a-drizzle/Printer1/media/pictures/building/20160507_185557.jpg

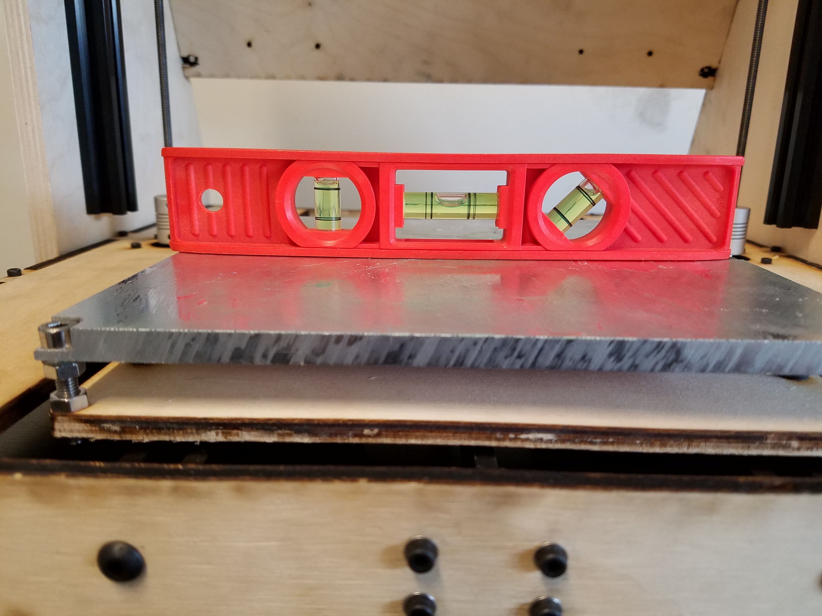
media/pictures/building/20160507_185557.jpg
