a-drizzle/Printer1/archive/rev A/X-002.pdf

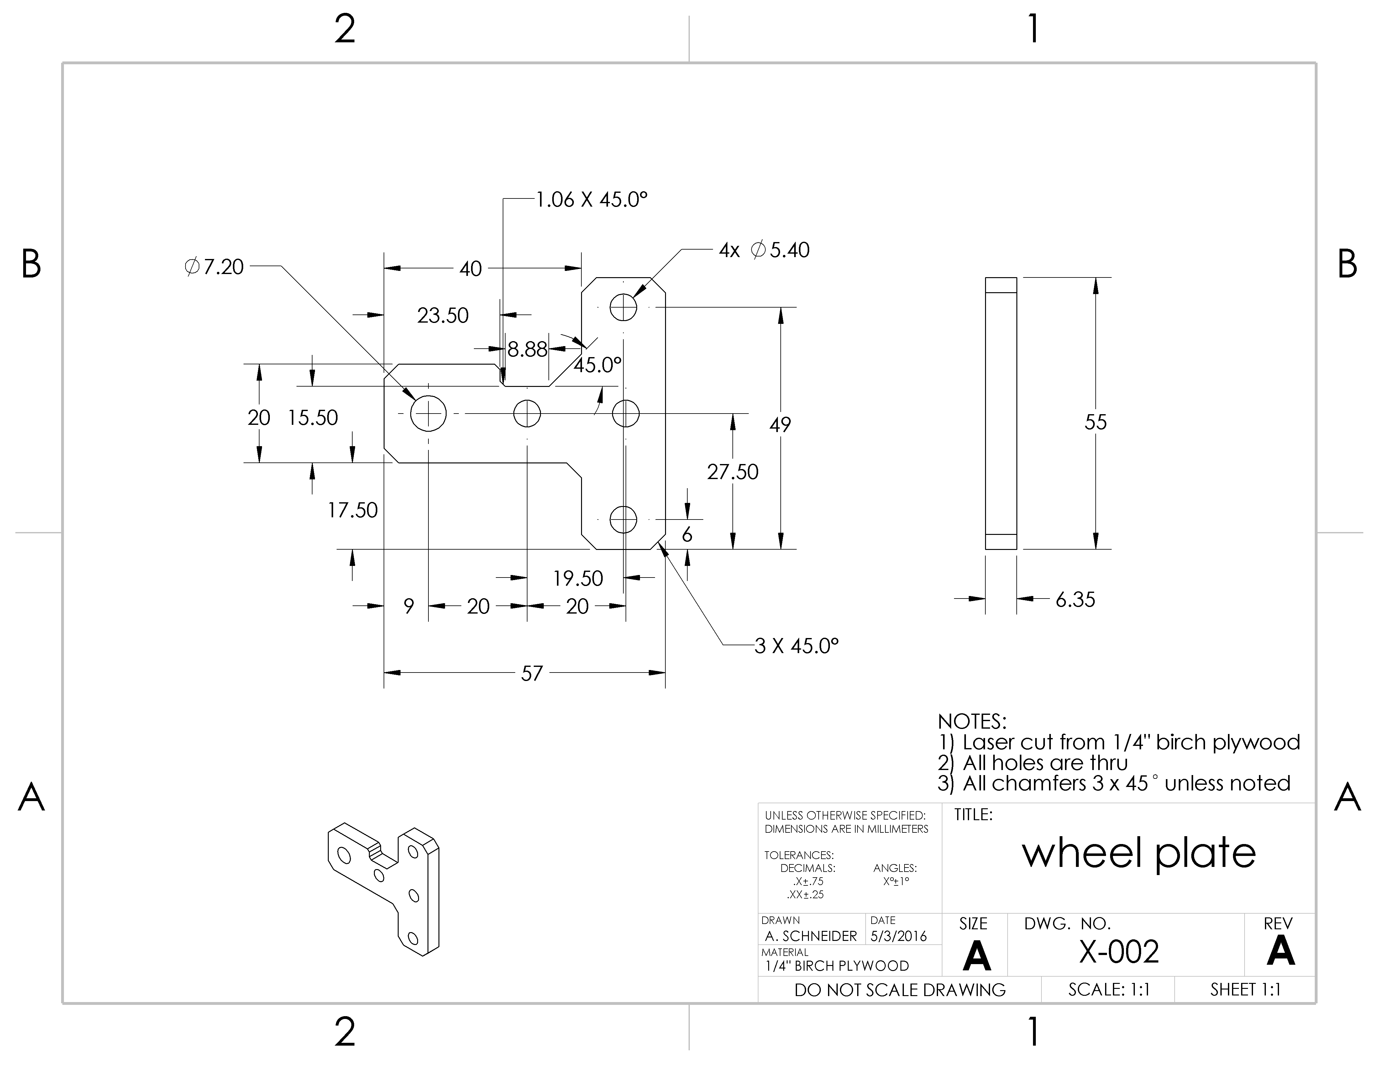
[picture p3: page 1]
