a-drizzle/Printer1/archive/rev A/Y-004.pdf

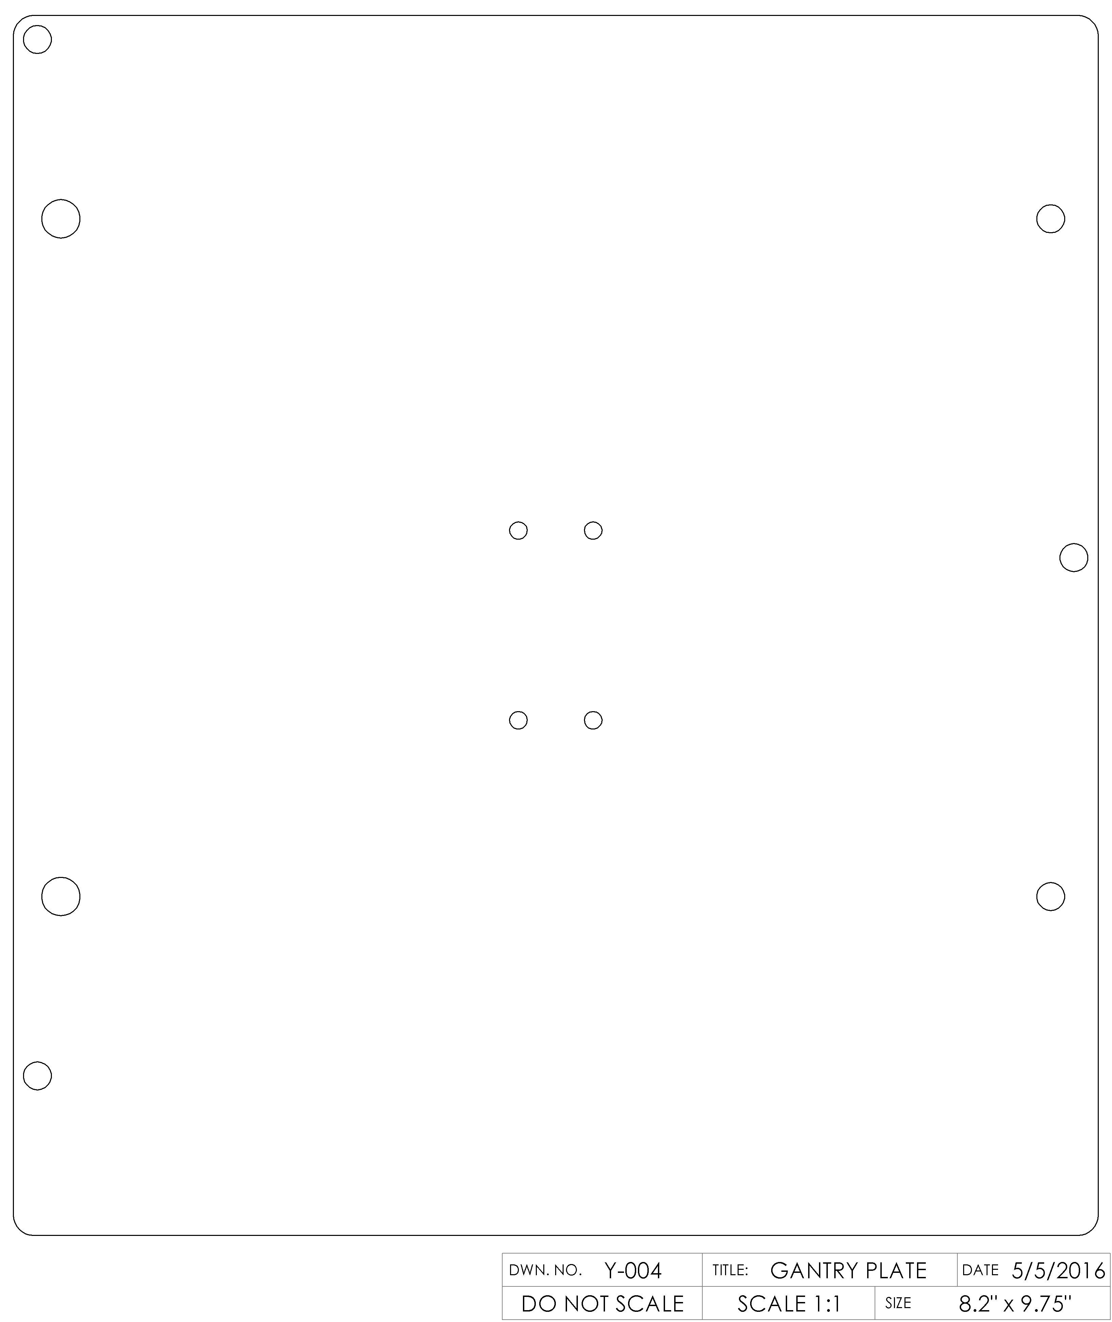
[picture p4: page 1]
