a-drizzle/Printer1/media/pictures/complete/20160509_213520.jpg

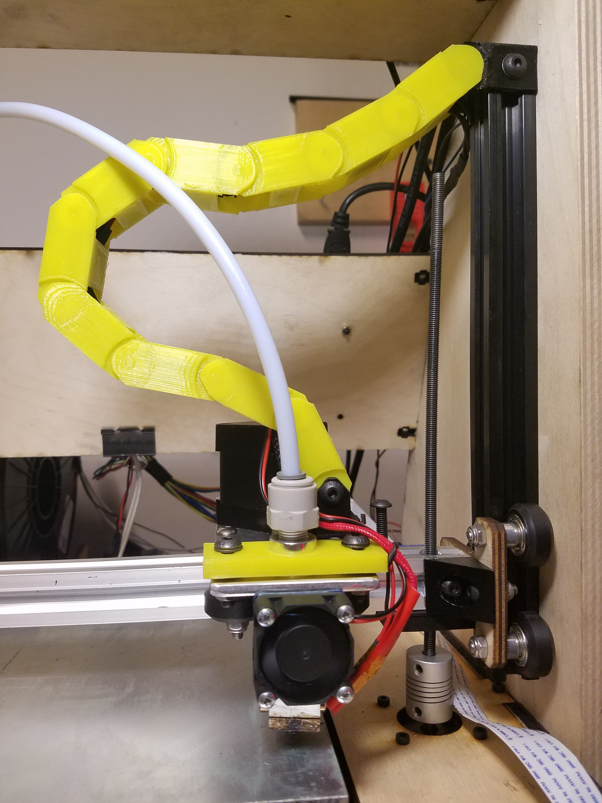
media/pictures/complete/20160509_213520.jpg
