a-drizzle/Printer1/media/renders/FrameRender2.png

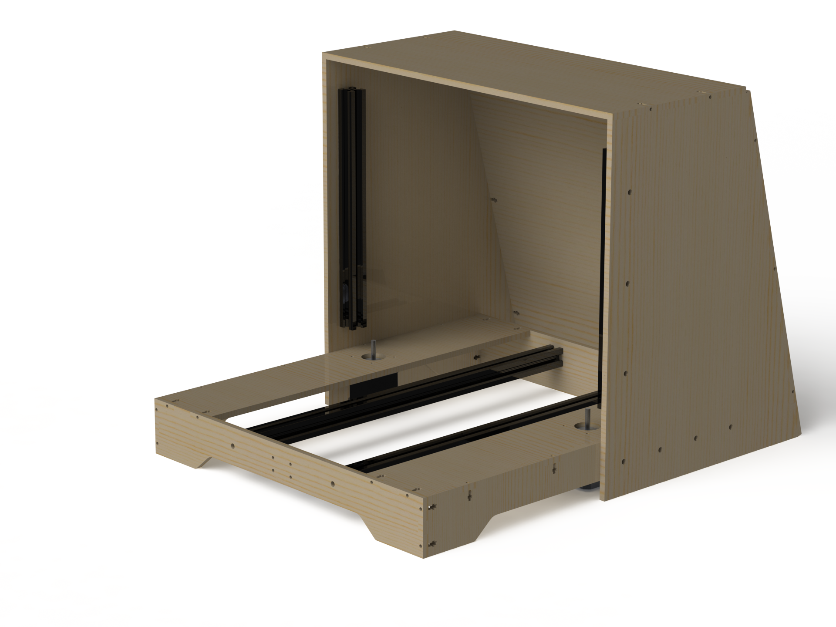
media/renders/FrameRender2.png
