a-drizzle/Printer1/media/renders/full.png

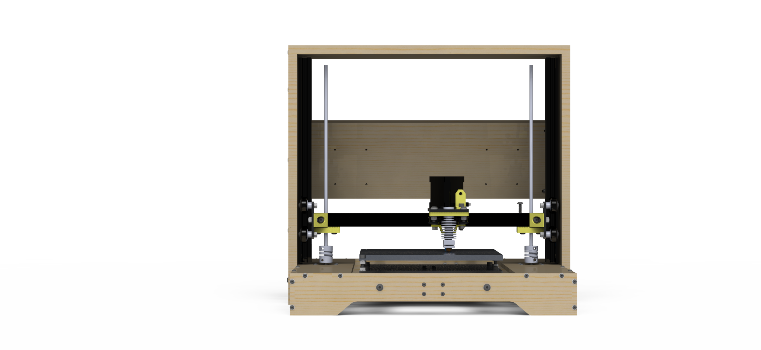
media/renders/full.png
