a-drizzle/Printer1/media/renders/x-axis_back.png

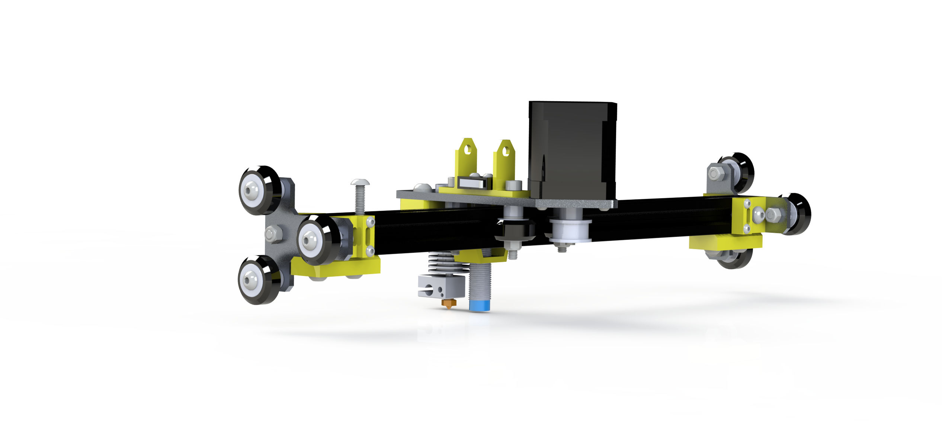
media/renders/x-axis_back.png
