a-drizzle/Printer1/media/renders/x-carriage.png

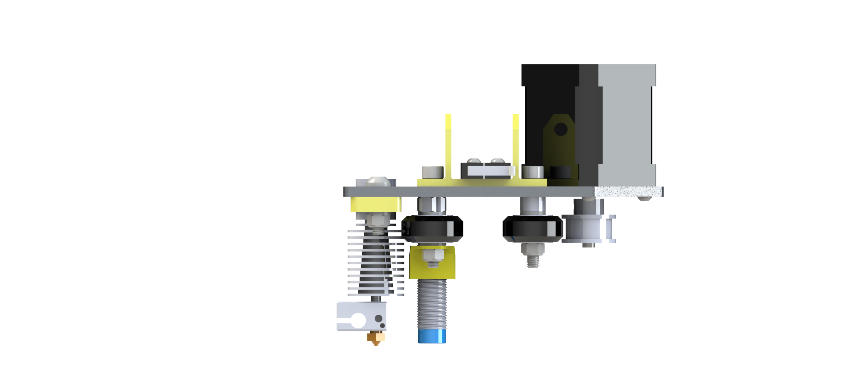
media/renders/x-carriage.png
