a-drizzle/Printer1/media/renders/y.png

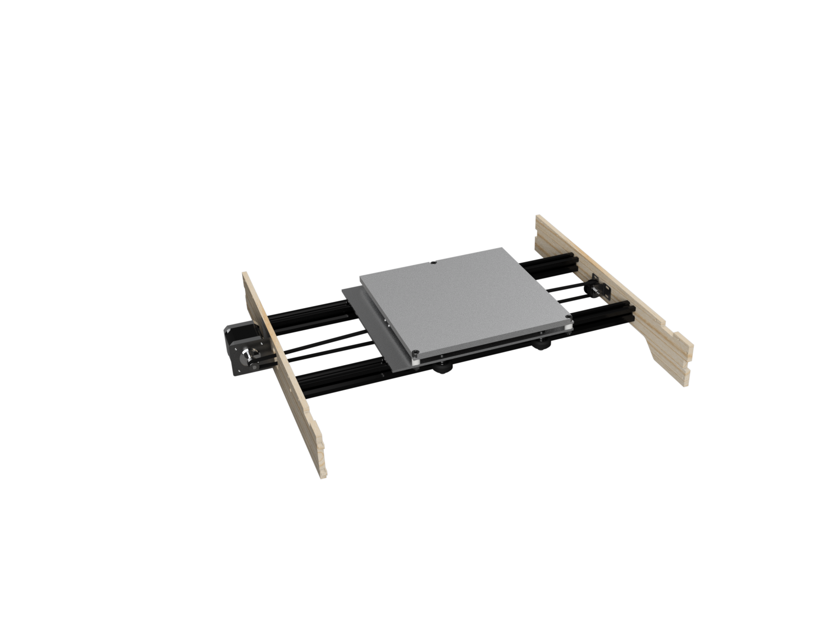
media/renders/y.png
