a-drizzle/Printer1/documentation/BOM_final.xlsx

Category | Andrew's Part # | Description | Manufacturer | Manufacturer Part # | Quantity | Price per Unit | Total
Electronic | E-001 | NEMA 17 stepper 76 oz-in | OpenBuilds | 775 | 1 | $17.50 | $17.50
Electronic | E-002 | NEMA 17 stepper 84 oz-in | Ebay | 231514870097 | 3 | $9.00 | $27.00
Electronic | E-003 | Inductive Sensor | Ebay | 141715753806 | 1 | $4.58 | $4.58
Electronic | E-004 | Endstop Switch | OpenBuilds | 725 | 2 | $2.00 | $4.00
Frame | F-001 | Front Base | Andrew |  | 1 |  | $0.00
Frame | F-002 | Back Base | Andrew |  | 1 |  | $0.00
Frame | F-003 | Sides Base | Andrew |  | 2 |  | $0.00
Frame | F-004 | Stepper Mounts | Andrew |  | 2 |  | $0.00
Frame | F-005 | Big Sides | Andrew |  | 2 |  | $0.00
Frame | F-006 | Top | Andrew |  | 1 |  | $0.00
Frame | F-007 | Back | Andrew |  | 1 |  | $0.00
Hardware | H-001 | T-Nuts (25 pk) | OpenBuilds | 50 | 1 | $4.95 | $4.95
Hardware | H-002 | Eccentric Spacer | OpenBuilds | 226 | 6 | $2.00 | $12.00
Hardware | H-003 | Aluminum Spacer - 6mm | OpenBuilds | 90 | 8 | $0.20 | $1.60
Hardware | H-004 | M5x8 Button Head | Mr.Metric | M11409 | 2 | $0.12 | $0.24
Hardware | H-005 | M5x10 Button Head | Mr.Metric | M11410 | 2 | $0.10 | $0.20
Hardware | H-006 | M5x12 Button Head | Mr.Metric | M11411 | 6 | $0.11 | $0.66
Hardware | H-007 | M5x16 Button Head | Mr.Metric | M11412 | 12 | $0.09 | $1.08
Hardware | H-008 | M5x20 Button Head | Mr. Metric | M11413 | 4 | $0.16 | $0.64
Hardware | H-009 | M5x25 Button Head | Mr.Metric | M11414 | 18 | $0.14 | $2.52
Hardware | H-010 | M5x30 Button Head, SS | Mr.Metric | M11534 | 2 | $0.20 | $0.40
Hardware | H-011 | M5 Flat Washer | Mr.Metric | M60710 | 39 | $0.02 | $0.78
Hardware | H-012 | M5 Nylon Locknut | Mr.Metric | M50352 | 29 | $0.06 | $1.74
Hardware | H-013 | M3x10 Button Head | Mr.Metric | M11402 | 18 | $0.06 | $1.08
Hardware | H-014 | Solid V Wheel Kit | OpenBuilds | 480 | 14 | $4.85 | $67.90
Hardware | H-015 | Drop In T-Nut | OpenBuilds | 230 | 2 | $0.75 | $1.50
Hardware | H-016 | M5 Hex Nut, zinc | Mr. Metric | M50608 | 14 | $0.04 | $0.56
Hardware | H-017 | M5x30 FT Socket Head | Mr. Metric | M10103-FT | 7 | $0.16 | $1.12
Hardware | H-018 | M5 Split Lock Washer | Mr. Metric | M60807 | 3 | $0.04 | $0.12
Hardware | H-019 | M3 Nylon Locknut | Mr.Metric | M50303 | 8 | $0.02 | $0.16
Hardware | H-020 | M3 Hex Nut, zinc | Mr. Metric | M50013 | 28 | $0.02 | $0.56
Hardware | H-021 | M3x12 Button Head | Mr. Metric | M11403 | 12 | $0.09 | $1.08
Hardware | H-022 | M3x16 Button Head | Mr. Metric | M11404 | 24 | $0.05 | $1.20
Hardware | H-023 | M3x6 Button Head | Mr. Metric | M11400 | 4 | $0.03 | $0.12
Hardware | H-024 | M3 Flat Washer | Mr. Metric | M60708 | 28 | $0.03 | $0.84
Hardware | H-025 | M5x35 Socket Head | Mr. Metric | M10105 | 2 | $0.20 | $0.40
Hardware | H-030 | Smooth Idler Pulley Wheel Kit | OpenBuilds | 550 | 1 | $5.45 | $5.45
Mechanical | M-001 | GT2 20 tooth pulley | OpenBuilds | 210 | 2 | $5.50 | $11.00
Mechanical | M-002 | GT2 Timing Belt 2mm | OpenBuilds | 470 / By the Foot | 5 | $2.50 | $12.50
Mechanical | M-003 | e3D Lite6 Bowden, 12V | SMW3D | Lite12B | 1 | $39.99 | $39.99
Mechanical | M-004 | Flexible 5mm to 5mm coupler | SMW3D | 5x5cplr | 2 | $1.50 | $3.00
Mechanical | M-005 | Z-Axis Rod | Andrew |  | 2 |  | $0.00
Printed | PX-001 | Endstop Mount | Andrew |  | 1 |  | $0.00
Printed | PX-002 | Belt Clamp Base | Andrew |  | 2 |  | $0.00
Printed | PX-003 | Belt Clamper | Andrew |  | 4 |  | $0.00
Printed | PX-004 | Z Nut Trap | Andrew |  | 2 |  | $0.00
Printed | PX-005 | Z Nut Trap stopper | Andrew |  | 2 |  | $0.00
Printed | PX-006 | Black Angle Connector | Andrew |  | 2 |  | $0.00
Printed | PX-007 | Groove Mount Plate | Andrew |  | 1 |  | $0.00
Printed | PX-008 | Drag Chain Base | Andrew |  | 1 |  | $0.00
Printed | PX-009 | Inductive Sensor Mount | Andrew |  | 1 |  | $0.00
Mechanical | X-001 | Carriage Plate | Andrew |  | 1 |  | $0.00
Mechanical | X-002 | Wheel Plate | Andrew |  | 2 |  | $0.00
Mechanical | X-003 | x axis V-Slot | Andrew |  | 1 |  | $0.00
Mechanical | Y-001 | laser cut idler mount | Andrew |  | 2 |  | $0.00
Mechanical | Y-002 | laser cut stepper mount | Andrew |  | 1 |  | $0.00
Mechanical | Y-003 | Build Plate | Andrew |  | 1 |  | $0.00
Mechanical | Y-004 | Gantry Plate | Andrew |  | 1 |  | $0.00
Mechanical | Y-005 | y axis V-Slot | Andrew |  | 2 |  | $0.00
Mechanical | Y-006 | z axis V-Slot | Andrew |  | 2 |  | $0.00
Stock |  | .160x6x6" aluminum sheet | McMaster | 89015K255 | 1 | $10.48 | $10.48
Stock |  | 1/2x12x24" Birch Plywood (single sheet) | Revell | 88-7682 | 2 | $6.79 | $13.58
Stock |  | 1/4x12x24" Birch Plywood (single sheet) | Revell | 88-7684 | 2 | $9.49 | $18.98
Stock |  | 20x20x500mm Black V-Slot | OpenBuilds | 130-LP | 5 | $5.50 | $27.50
Electronic |  | Fotek Relay, 24V-380V 25A SSR-25 DA | Ebay | 321979099507 | 1 | $4.99 | $4.99
Stock |  | General Purpose Low-Carbon 22 gauage Steel Sheet 12"x24" | McMaster | 6544K13 | 1 | $8.27 | $8.27
Electronic |  | Keenovo 500W, 120V, 8x8" heat mat | Keenovo | K150150500W110V | 1 | $34.25 | $34.25
Stock |  | M5x0.8 low-strength steel fully threaded rod | McMaster | 98861A060 | 2 | $1.08 | $2.16
Hardware |  | M5x25 Socket Cap, zinc | Mr. Metric | M10856 | 7 | $0.02 | $0.14
Stock |  | MIC 6 5/16x8x8" | McMaster | 86825K744 | 1 | $22.37 | $22.37
Stock |  | Super-Cushioning Polyurethane Rubber Sheet, Abrasion-Resistant, 4" x 4", 1/8" Thick, 70Oo Durometer | McMaster | 8514K51 | 2 | $5.73 | $11.46
Electronic |  | Thermistor 100K 3950 | SMW3D | 100K 3950 | 1 | $0.99 | $0.99
Mechanical |  | V-slot cover 500mm black | OpenBuilds | 120-LP-B | 3 | $2.00 | $6.00
Total |  |  |  |  |  |  | $389.64
