a-drizzle/Printer1/documentation/BOM_rB.xlsx

Sheet: BOM
Category | Andrew's Part # | Description | Manufacturer | Manufacturer Part # | Quantity | Price per Unit | Total
 |  |  |  |  |  |  | $345.41
MISC
Hardware | H-001 | T-Nuts (25 pk) | OpenBuilds | 50 | 1 | $4.95 | $4.95
Mechanical |  | V-slot cover 500mm black | OpenBuilds | 120-LP-B | 3 | $2.00 | $6.00
X - AXIS & Z - AXIS
Stock |  | .160x6x6" aluminum sheet | McMaster | 89015K255 | 1 | $10.48 | $10.48
Stock |  | 20x20x500mm Black V-Slot | OpenBuilds | 130-LP | 1 | $5.50 | $5.50
Electronic | E-001 | NEMA 17 stepper 76 oz-in | OpenBuilds | 775 | 1 | $17.50 | $17.50
Electronic | E-002 | NEMA 17 stepper 84 oz-in | Ebay | 231514870097 | 2 | $9.00 | $18.00
Hardware | H-002 | Eccentric Spacer | OpenBuilds | 226 | 4 | $2.00 | $8.00
Hardware | H-003 | Aluminum Spacer - 6mm | OpenBuilds | 90 | 8 | $0.20 | $1.60
Mechanical | M-001 | GT2 20 tooth pulley | OpenBuilds | 210 | 1 | $5.50 | $5.50
Mechanical | M-002 | GT2 Timing Belt | OpenBuilds | 470 / By the Foot | 2 | $2.50 | $5.00
Electronic | E-003 | Inductive Sensor | Ebay | 141715753806 | 1 | $4.58 | $4.58
Mechanical | M-003 | e3D v6 clone | Ebay | 181902204358 | 1 | $25.99 | $25.99
Mechanical |  | PTFE tubing 3mm ID | Filastruder |  | 1 | $7.50 | $7.50
Mechanical |  | Fiberglass insulation | Filastruder |  | 1 | $1.99 | $1.99
Mechanical | H-014 | Solid V Wheel | MakerFarm | SolidV+Bearing | 6 | $2.95 | $17.70
Hardware | H-004 | M5x8 Button Head | Mr.Metric | M11409 | 2 | $0.12 | $0.24
Hardware | H-005 | M5x10 Button Head | Mr.Metric | M11410 | 3 | $0.10 | $0.30
Hardware | H-006 | M5x12 Button Head | Mr.Metric | M11411 | 4 | $0.11 | $0.44
Hardware | H-007 | M5x16 Button Head | Mr.Metric | M11412 | 4 | $0.09 | $0.36
Hardware | H-008 | M5x20 Button Head | Mr.Metric | M11413 |  | $0.16 | $0.00
Hardware | H-009 | M5x25 Button Head | Mr.Metric | M11414 |  | $0.14 | $0.00
Hardware | H-010 | M5x30 Button Head, SS | Mr.Metric | M11534 | 4 | $0.20 | $0.80
Hardware | H-011 | M5 Flat Washer | Mr.Metric | M60710 | 10 | $0.02 | $0.20
Hardware | H-012 | M5x.8 Nylon Locknut | Mr.Metric | M50352 | 12 | $0.06 | $0.72
Hardware | H-013 | M3x10 Button Head | Mr.Metric | M11402 | 6 | $0.06 | $0.36
Hardware | H-014 | Solid V Wheel Kit |  |  | 10 |  | $0.00
Hardware | H-015 | Drop In T-Nut |  |  |  |  | $0.00
Hardware | H-016 | M5 Hex Nut, zinc | Mr. Metric | M50608 | 2 | $0.02 | $0.04
Electronic | E-004 | Endstop Switch | MakerFarm | Switch | 1 | $1.50 | $1.50
Mechanical | X-001 | Carriage Plate | Andrew |  | 1 |  |  | $123.82
Mechanical | X-002 | Wheel Plate | Andrew |  | 2
Mechanical | X-003 | V-Slot | Andrew |  | 1
Printed | PX-002 | Belt Clamp Base | Andrew |  | 2 |  | $0.00
Printed | PX-003 | Belt Clamper | Andrew |  | 2 |  | $0.00
Printed | PX-004 | Z Nut Trap | Andrew |  | 2 |  | $0.00
Printed | PX-005 | Z nut trap stopper | Andrew |  | 2 |  | $0.00
Printed | PX-006 | Black Angle Connector | Andrew |  | 2 |  | $0.00
Printed | PX-007 | Groove Mount Plate
Printed | PX-008 | Drag Chain Base | Andrew |  | 1 |  | $0.00
Y - AXIS
Electronic |  | NEMA 17 stepper 84 oz-in | Ebay | 231514870097 | 1 | $9.00 | $9.00
Stock |  | MIC 6 5/16x8x8" | McMaster | 86825K744 | 1 | $22.37 | $22.37
Stock |  | Firm White Polyester Felt Strip, 1/4" Thick, 1" Width, Plain Back | McMaster | 88085K311 | 1 | $4.70 | $4.70
Stock |  | Super-Cushioning Polyurethane Rubber Sheet, Abrasion-Resistant, 4" x 4", 1/8" Thick, 70Oo Durometer | McMaster | 8514K51 | 2 | $5.73 | $11.46
Stock |  | General Purpose Low-Carbon 22 gauage Steel Sheet 12"x24" | McMaster | 6544K13 | 1 | $8.27 | $8.27
Stock |  | 20x20x500mm Black V-Slot | OpenBuilds | 130-LP | 2 | $5.50 | $11.00
Stock |  | 20x20x250mm Black V-Slot | OpenBuilds | 255-LP | 2 | $3.30 | $6.60
Stock |  | Aspen Aerogel Spaceloft insulation | Ebay | 171328843398 | 1 | $7.99 | $7.99
Electronic |  | Keenovo 500W, 120V, 8x8" heat mat | Keenovo | K150150500W110V | 1 | $34.25 | $34.25
Electronic |  | Fotek Relay, 24V-380V 25A SSR-25 DA | Ebay | 321979099507 | 1 | $4.99 | $4.99
Mechanical |  | Solid V Wheel Kit | OpenBuilds | 480 | 4 | $4.85 | $19.40
Hardware |  | Smooth Idler Pulley Wheel Kit | OpenBuilds | 550 | 1 | $5.45 | $5.45
Hardware |  | Eccentric Spacer | OpenBuilds | 226 | 2 | $2.00 | $4.00
Mechanical | M-002 | GT2 Timing Belt 2mm | OpenBuilds | 470 / By the Foot | 3 | $2.50 | $7.50
Hardware |  | M5 x 25 Socket Cap, zinc | Mr. Metric | M10856 | 7 | $0.02 | $0.06
Hardware |  | M5 Washer | Mr. Metric | M60710 | 3 | $0.04 | $0.36
Hardware |  | M5 Hex Nut, zinc | Mr. Metric | M50608 | 9 | $0.04 | $0.32
Hardware |  | M3 X 6 Button Head | Mr. Metric | M11400 | 8 | $0.03 | $0.12
Hardware |  | M3 Washer | Mr. Metric | M60708 | 4 | $0.02 | $0.10
Hardware |  | M3 Hex Nut, zinc | Mr. Metric | M50013 | 5
Mechanical | Y-001 | laser cut idler mount | Andrew |  | 2
Mechanical | Y-002 | laser cut stepper mount | Andrew |  | 1
Mechanical | Y-003 | Build Plate | Andrew |  | 1
Mechanical | Y-004 | Gantry Plate | Andrew |  | 1 |  |  | $157.94
Printed | PX-001 | Endstop Mount | Andrew |  | 1
FRAME
Stock |  | 1/4x12x24" Birch Plywood (single sheet) | Revell | 88-7684 | 2 | $9.49 | $18.98
Stock |  | 1/2x12x24" Birch Plywood (single sheet) | Revell | 88-7682 | 2 | $6.79 | $13.58
Hardware |  | M3 Hex Nut, zinc | Mr. Metric | M50013 | 42 | $0.03 | $1.26
Hardware |  | M5 Hex Nut, zinc | Mr. Metric | M50608 | 8 | $0.02 | $0.16
Hardware |  | M3 Washer | Mr. Metric | M60708 | 50 | $0.05 | $2.50
Hardware |  | M5 Washer | Mr. Metric | M60710 | 18 | $0.09 | $1.62
Hardware |  | M3 x 16 Button Head | Mr. Metric | M11404 | 34 | $0.06 | $2.04
Hardware |  | M3 x 12 Button Head | Mr. Metric | M11403 | 14 |  | $0.00
Hardware |  | M3 x 10 Button Head | Mr. Metric | M11402 | 8 | $0.16 | $1.28
Hardware |  | M5 x 25 Button Head | Mr. Metric | M11414 |  | $0.11 | $0.00
Hardware |  | M5 x 20 Button Head | Mr. Metric | M11413 | 8 | $0.10 | $0.80
Hardware |  | M5 x 12 Button Head | Mr. Metric | M11411 | 6 |  | $0.00
Hardware |  | M5 x 10 Button Head | Mr. Metric | M11410 | 4 |  | $0.00
Hardware | F-001 | Front Base | Andrew |  | 1
Hardware | F-002 | Back Base | Andrew |  | 1
Hardware | F-003 | Sides Base | Andrew |  | 2
Hardware | F-004 | Stepper Mounts | Andrew |  | 2
Hardware | F-005 | Big Sides | Andrew |  | 2
Hardware | F-006 | Top | Andrew |  | 1
Hardware | F-007 | Back | Andrew |  | 1

Sheet: OpenBuilds
OPENBUILDS
V-SLOT BLK |  |  |  |  |  |  | ELECTRONICS |  |  | HARDWARE |  | SCREWS
x [mm] | y [mm] | length [mm] | length [in] | Cost | $/cm | $/in | Item | Price |  | Item | Price | Item | Price
20 | 20 | 250 | 9.84 | $3.30 | $0.13 | $0.34 | Nema 17 | $17.50 |  | Eccentric Spacer | $2.00 | M5 x 6mm | $0.15
20 | 20 | 500 | 19.69 | $5.50 | $0.11 | $0.28 | Nema 23 | $24.50 |  | M5 Nylon Lock Nut | $0.15 | M5 x 8mm | $0.15
20 | 20 | 1000 | 39.37 | $11.00 | $0.11 | $0.28 | Limit Switch | $2.00 |  | T-Nuts (25) | $4.95 | M5 x 10mm | $0.15
20 | 20 | 1500 | 59.06 | $16.50 | $0.11 | $0.28 | 16-2 Wire | $0.4/ft |  | Drop in T-Nuts | $0.75 | M5 x 15mm | $0.15
20 | 40 | 250 | 9.84 | $4.15 | $0.17 | $0.42 | Wire Cable | $2.5/ft |  | Doulbe T-Nut | $0.85 | M5 x 20mm | $0.15
20 | 40 | 500 | 19.69 | $7.15 | $0.14 | $0.36 |  |  |  | Lock Collar | $0.90 | M5 x 25mm | $0.15
20 | 40 | 1000 | 39.37 | $14.30 | $0.14 | $0.36 | Item |  | Price | Spring Loaded T-Nuts | $1.20 | M5 x 30mm | $0.20
20 | 40 | 1500 | 59.06 | $21.45 | $0.14 | $0.36 | V Wheel |  | $4.85 | 5mm * 8mm coupler | $6.95 | 8mm Lead Screw | $10.00
20 | 60 | 250 | 9.84 | $4.65 | $0.19 | $0.47 | GT2 Timming Belt |  | $2.50 | Nut Plate for 8mm | $6.25 | M3 Socket (25) | $2.00
20 | 60 | 500 | 19.69 | $8.50 | $0.17 | $0.43 | Smooth Idler |  | $5.45 | Mounting plate | $3.50 | Self Tapping Screw | $0.25
20 | 60 | 1000 | 39.37 | $17.00 | $0.17 | $0.43 | GT2 20 tooth pulley |  | $5.50 | Precision Shim | 0.25
20 | 60 | 1500 | 59.06 | $25.30 | $0.17 | $0.43 | Belt Crimp |  | $0.60 | Spacers | 0.2
20 | 80 | 250 | 9.84 | $6.00 | $0.24 | $0.61 | Black Angle Corner |  | 2.75
20 | 80 | 500 | 19.69 | $11.00 | $0.22 | $0.56 | Cube Corner |  | 3.25
20 | 80 | 1000 | 39.37 | $22.00 | $0.22 | $0.56 | End Cap |  | 1.85
20 | 80 | 1500 | 59.06 | $33.00 | $0.22 | $0.56
Panel Cover |  | 250 | 9.84 | $1.00 | $0.04 | $0.10
Panel Cover |  | 500 | 19.69 | $2.00 | $0.04 | $0.10
Panel Cover |  | 1000 | 39.37 | $3.00 | $0.03 | $0.08

Sheet: Mr.Metric
 | M3 |  |  |  |  | McMaster
 | Mr. Metric |  |  |  |  | length | qnty | total | price
 | length | price |  |  |  | 8 | 100 | 6.58 | $0.07
Socket Head | 8 | $0.10 |  |  |  | 10 | 100 | 6.81 | $0.07
 | 10 | $0.04
 | 12 | $0.05
 | 14 | $0.11
 | 16 | $0.09
Button Head | 10 | $0.06
 | 12 | $0.09
 | 14 | $0.08
 | 16 | $0.05
 | 25 | $0.14
 | M5 |  | M5 Washer | M60710 | $0.02
 | Mr. Metric |  | M5 Hex Nut | M50608 | $0.04
 | length | price | M5 Nylon locknut |  | $0.06
Socket Head | 8 | $0.15 | M3 Nylon locknut |  | $0.02
 | 10 | $0.09 | M3 Hex Nut |  | $0.02
 | 12 | $0.17 | M3 Washer | M60708 | $0.03
 | 14 | $0.16
 | 16 | $0.12
 | 25 | $0.13
 | 30 | $0.16
Button Head | 8 | $0.12
 | 10 | $0.10
 | 12 | $0.11
 | 14 | NA
 | 16 | $0.09
 | 20 | $0.16
 | 25 | $0.14
 | 30 | NA
