a-drizzle/Printer1/production_parts/drawings/M-005.pdf

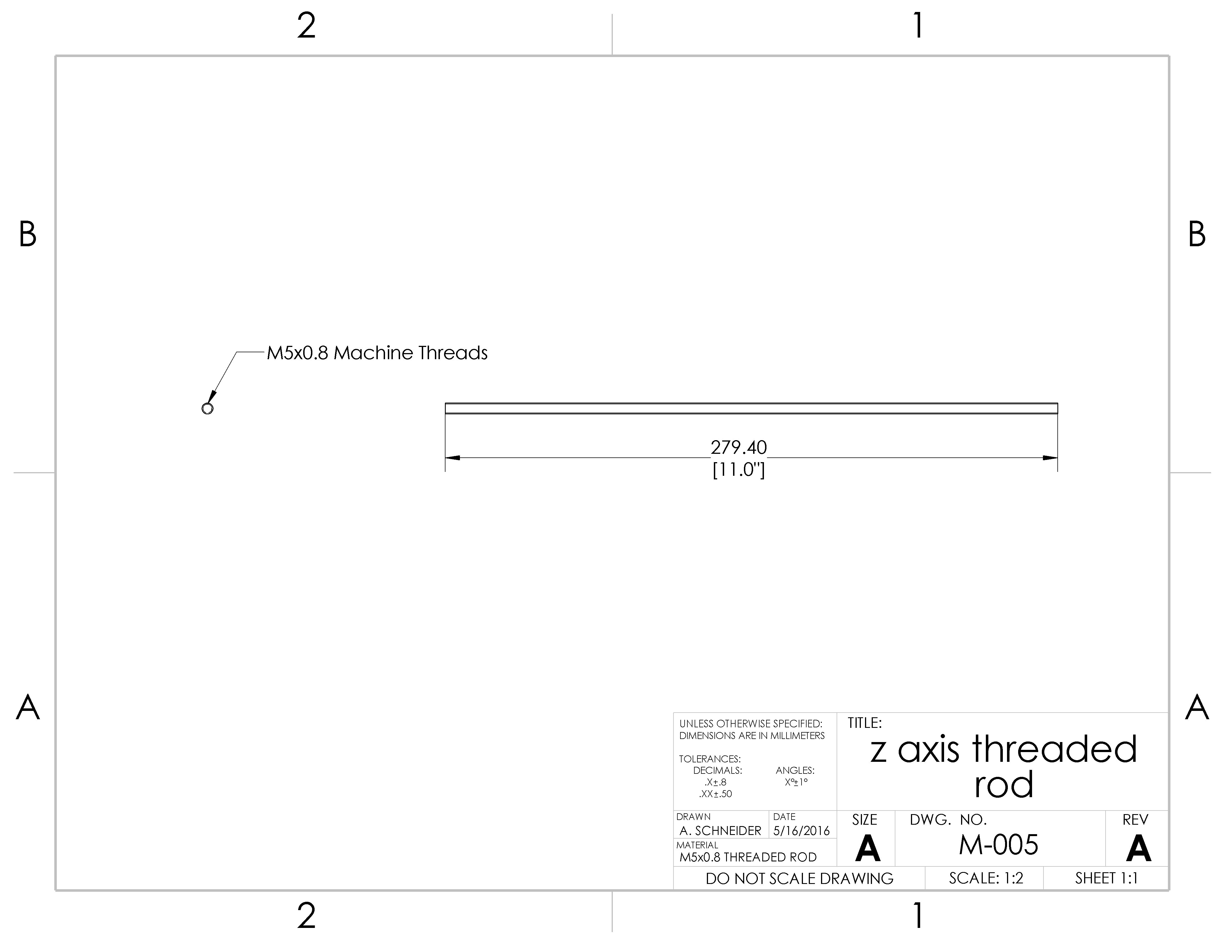
[picture p13: page 1]
