a-drizzle/Printer1/production_parts/drawings/PX-005.pdf

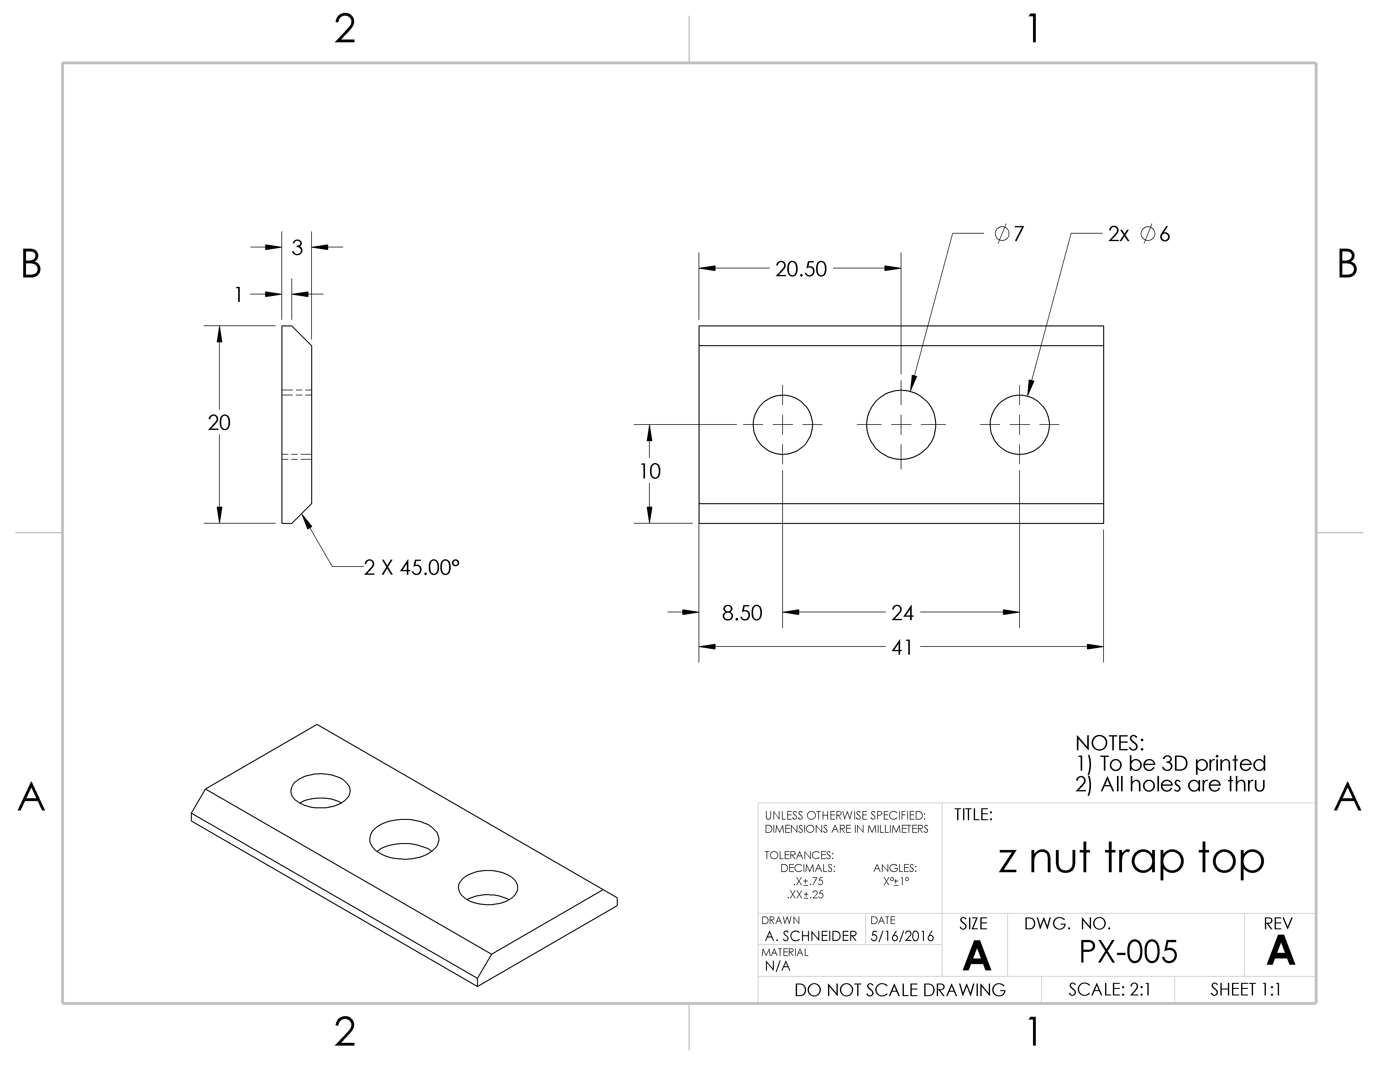
[picture p14: page 1]
