a-drizzle/Printer1/production_parts/drawings/PX-006.pdf

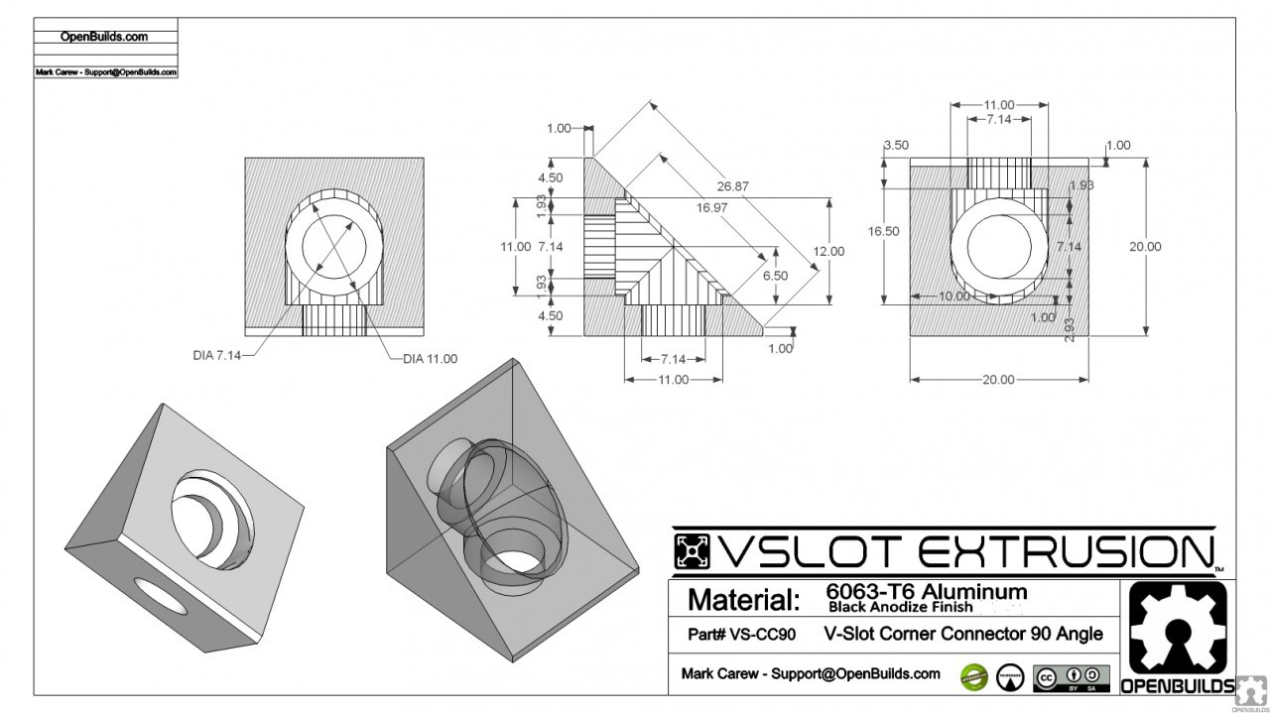
[picture p15: page 1]
