a-drizzle/Printer1/production_parts/drawings/PX-007.pdf

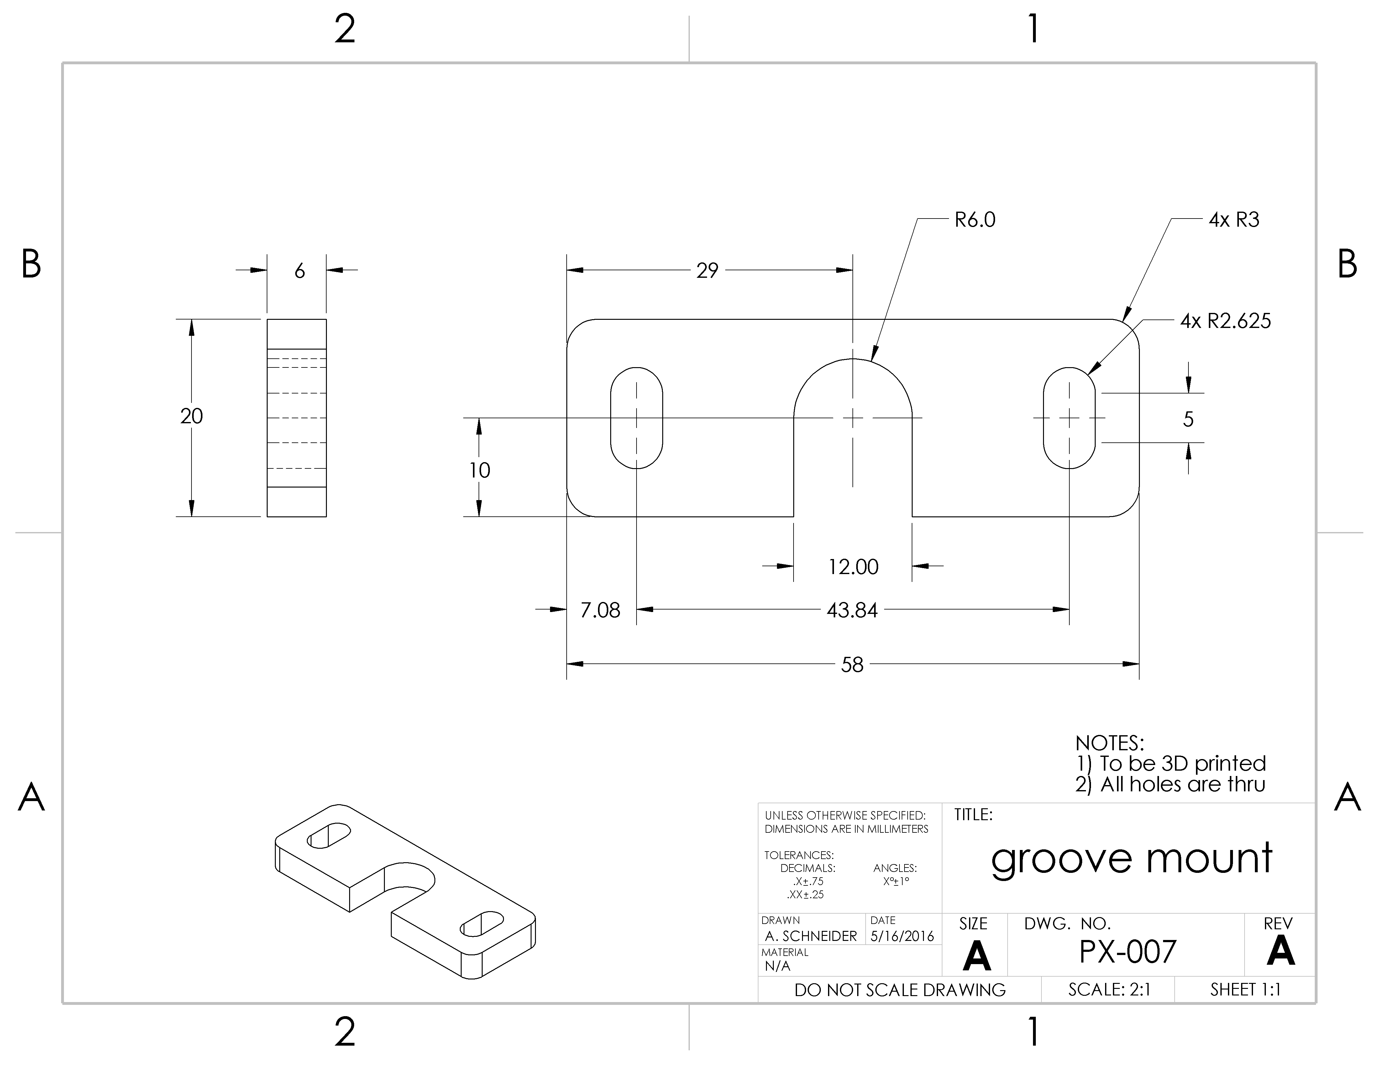
[picture p16: page 1]
