a-drizzle/Printer1/production_parts/drawings/X-001.pdf

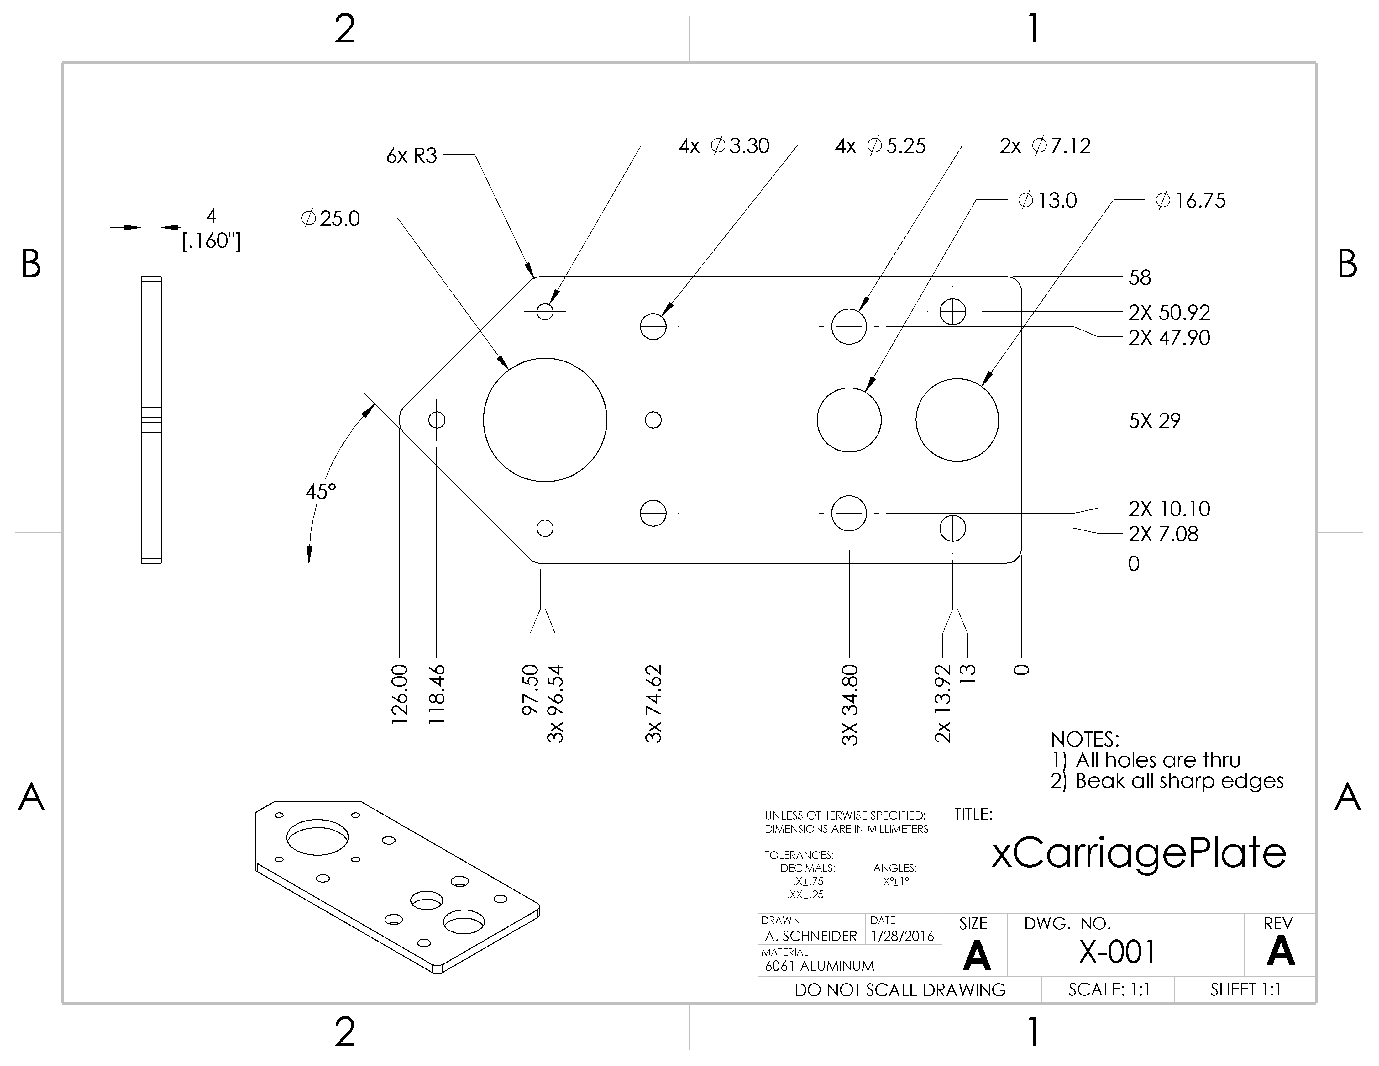
[picture p17: page 1]
