a-drizzle/Printer1/production_parts/drawings/X-002_rB.pdf

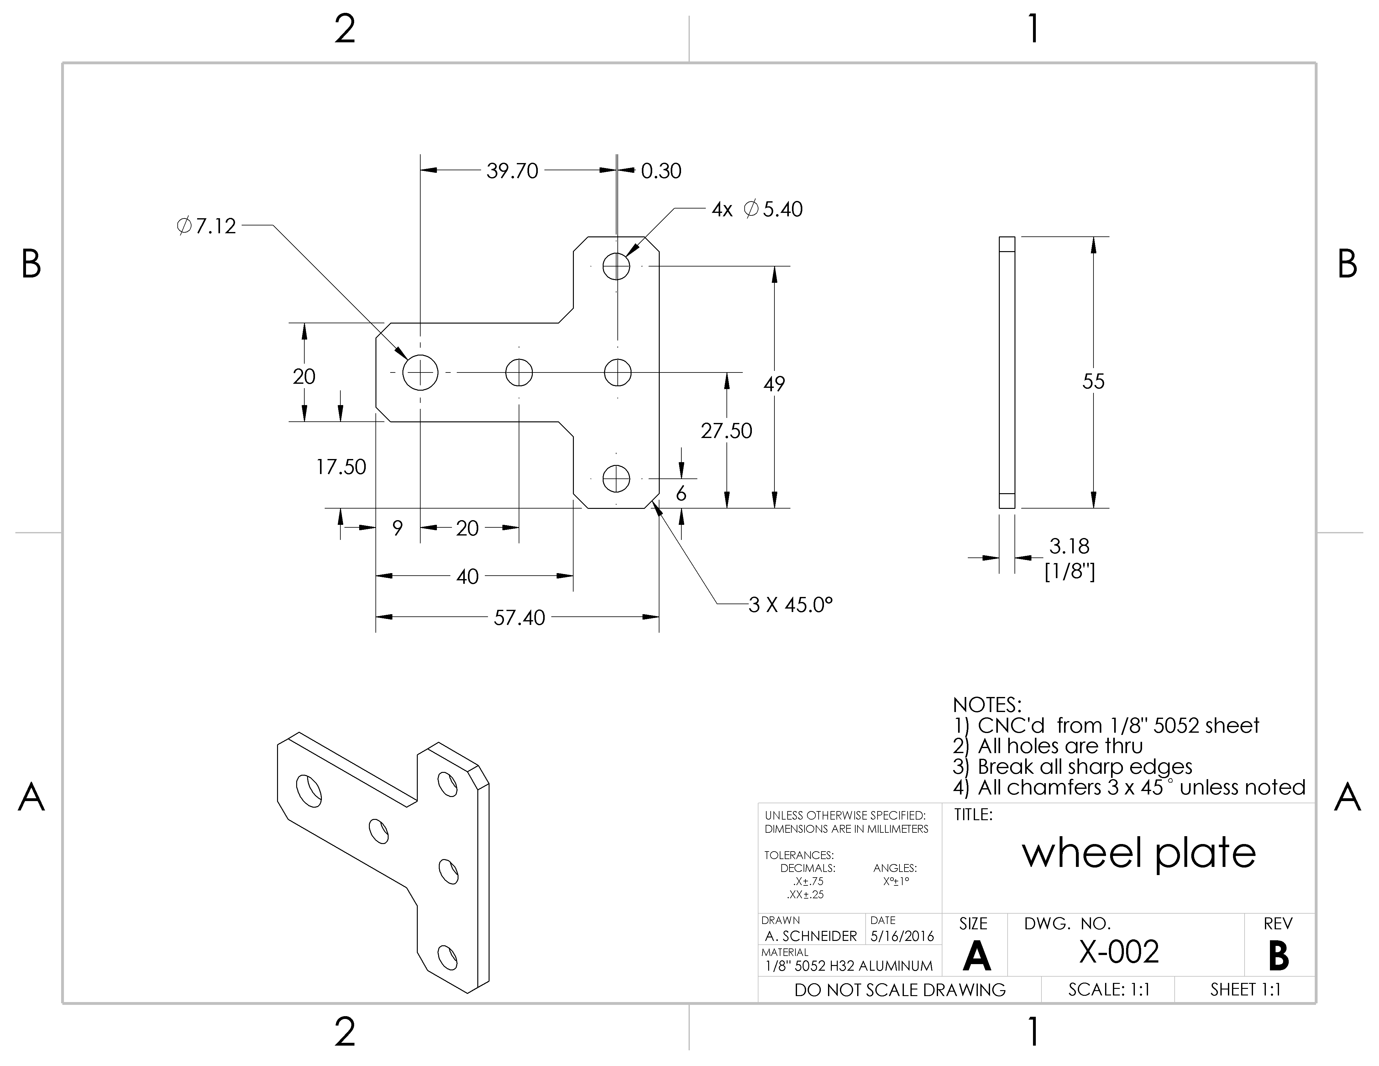
[picture p18: page 1]
