a-drizzle/Printer1/production_parts/drawings/X-003.pdf

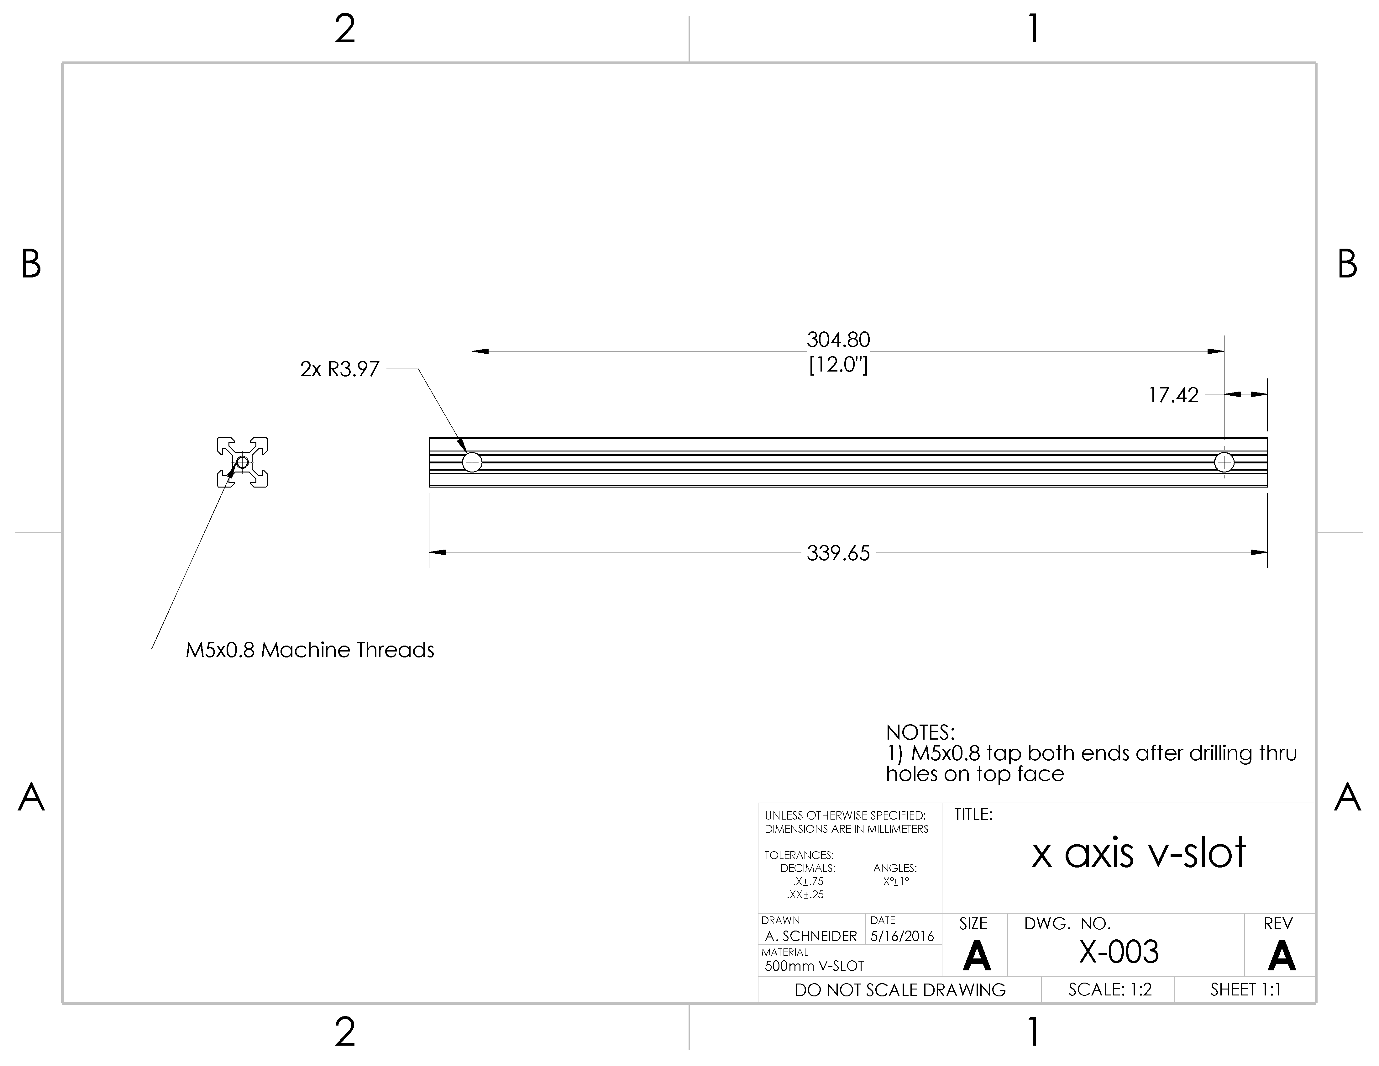
[picture p19: page 1]
