a-drizzle/Printer1/production_parts/drawings/Y-004_rB.pdf

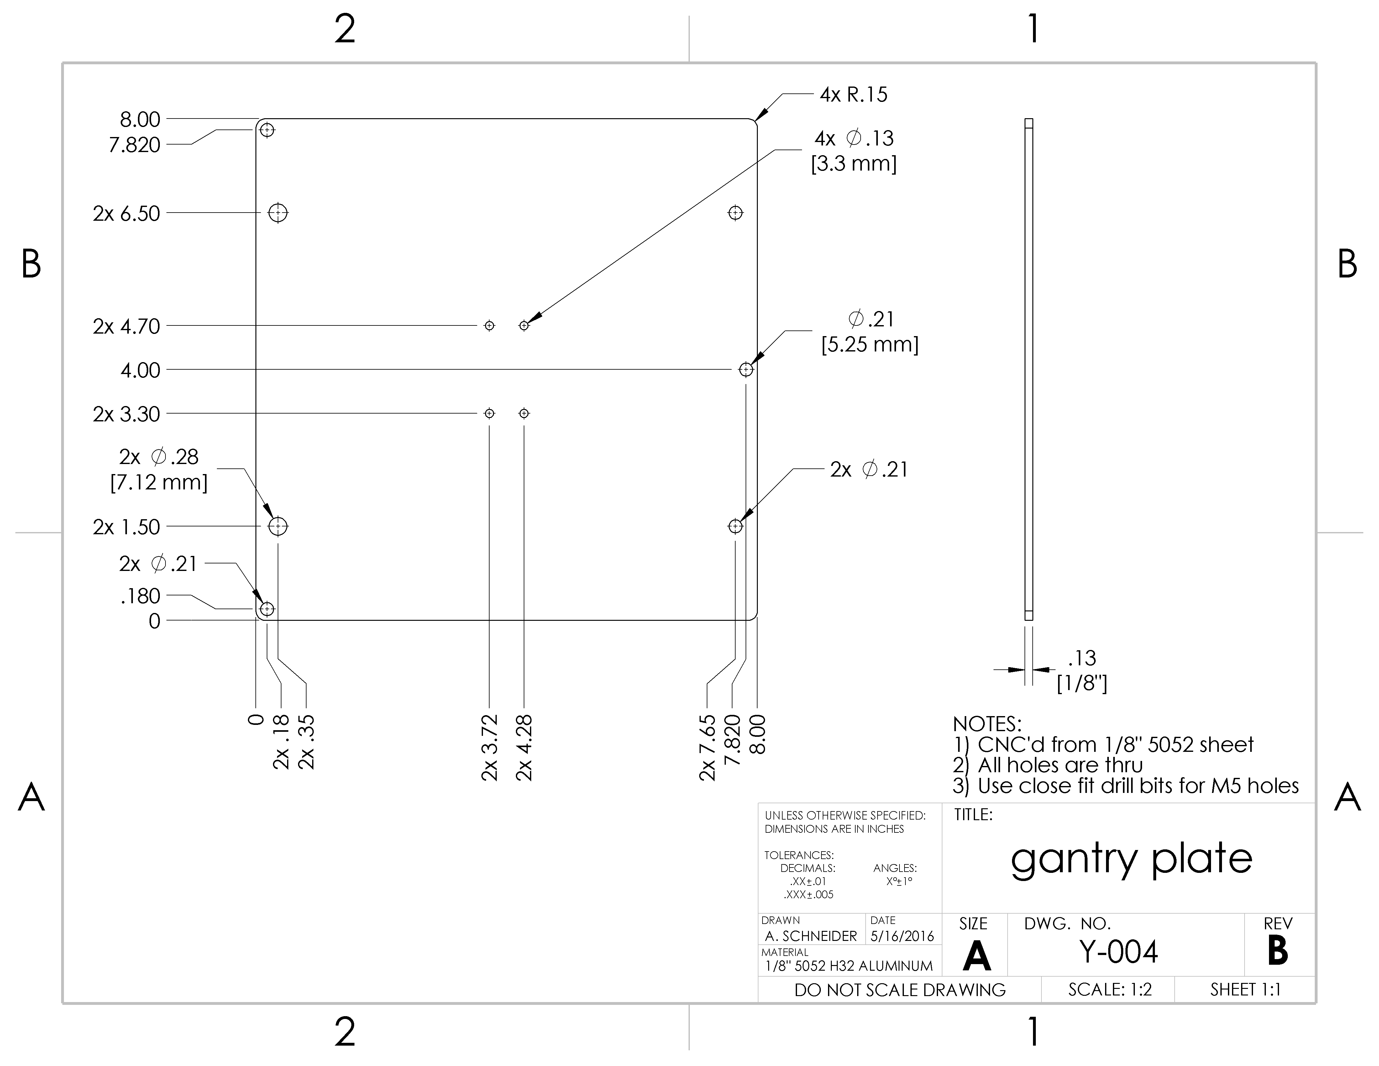
[picture p20: page 1]
