a-drizzle/Printer1/production_parts/drawings/Y-005.pdf

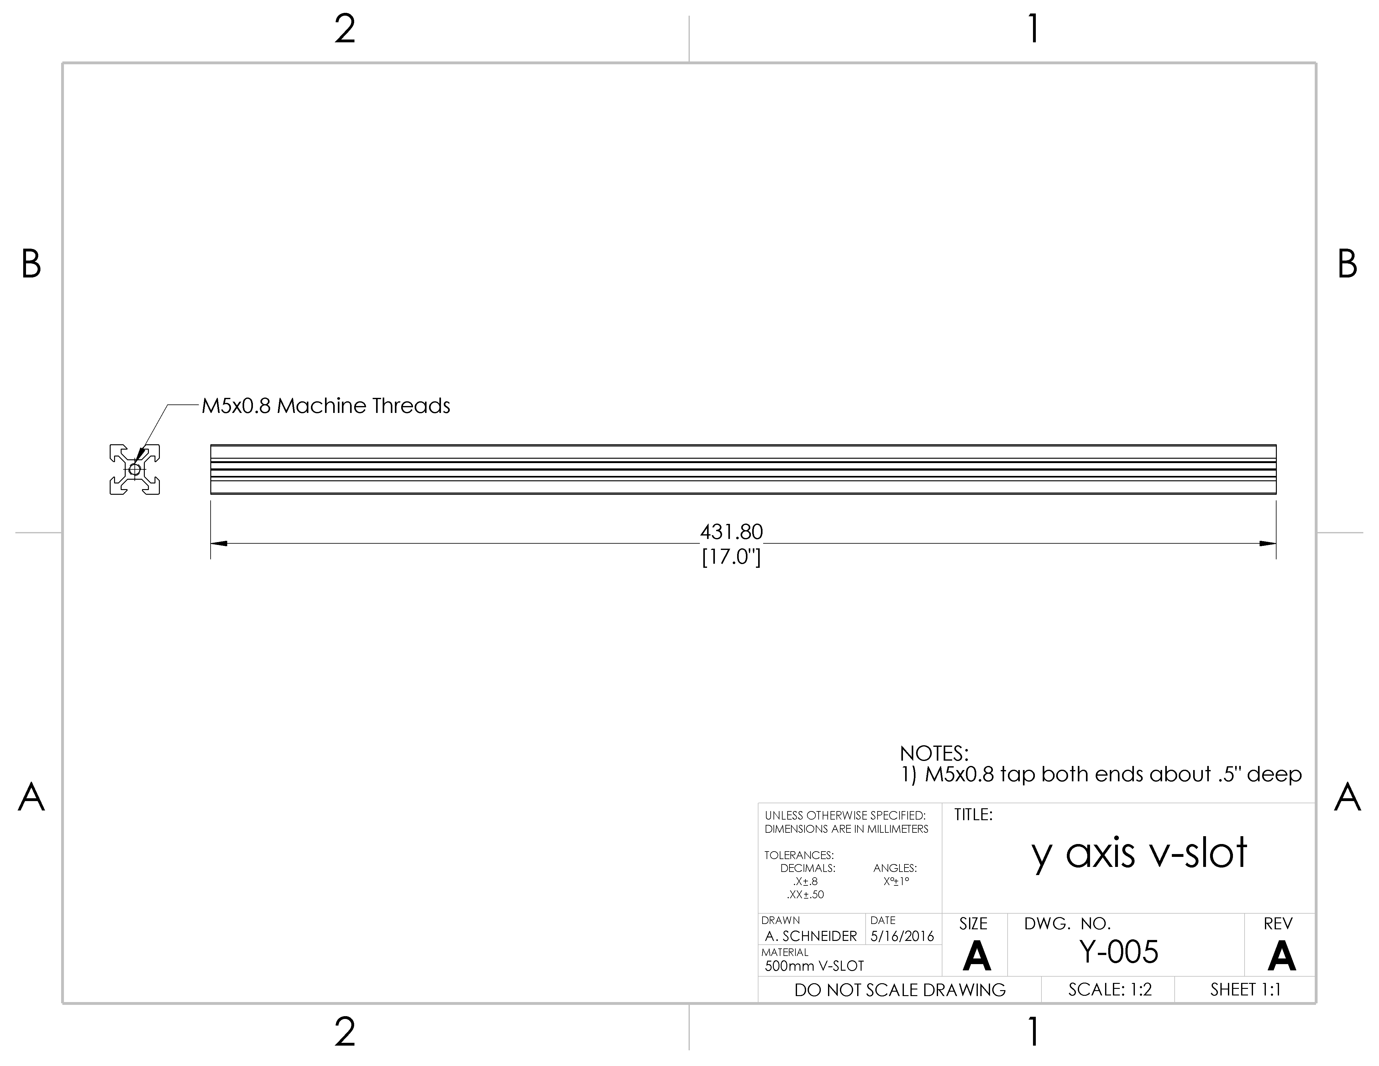
[picture p21: page 1]
