a-drizzle/Printer1/production_parts/drawings/Y-006.pdf

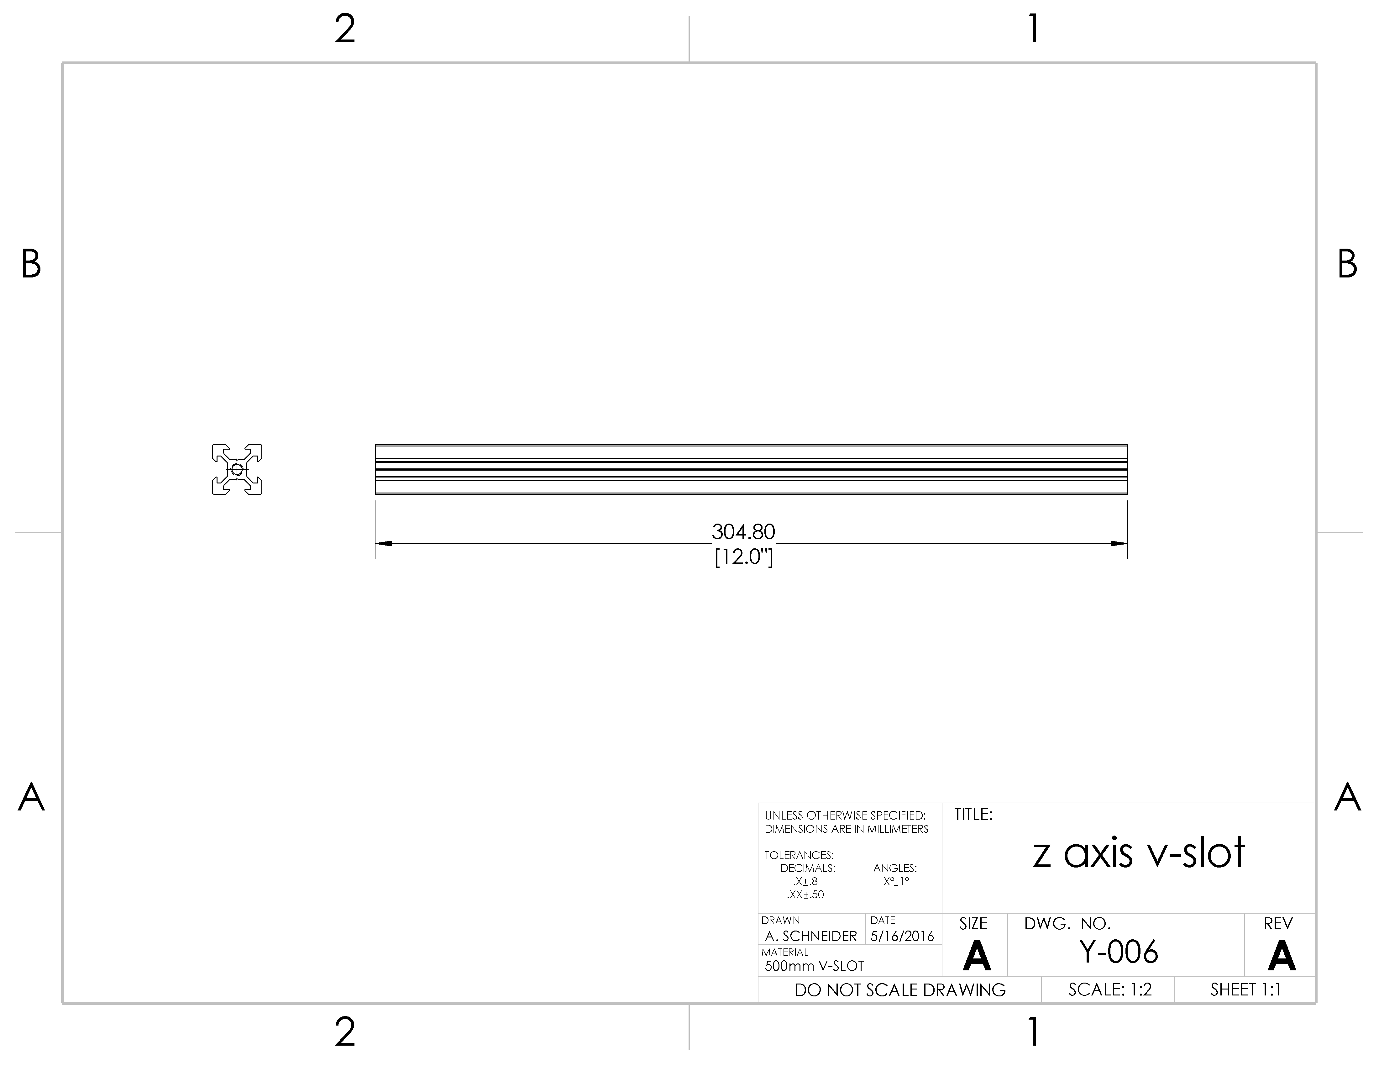
[picture p22: page 1]
