a-drizzle/Printer1/production_parts/drawings/F-100.pdf

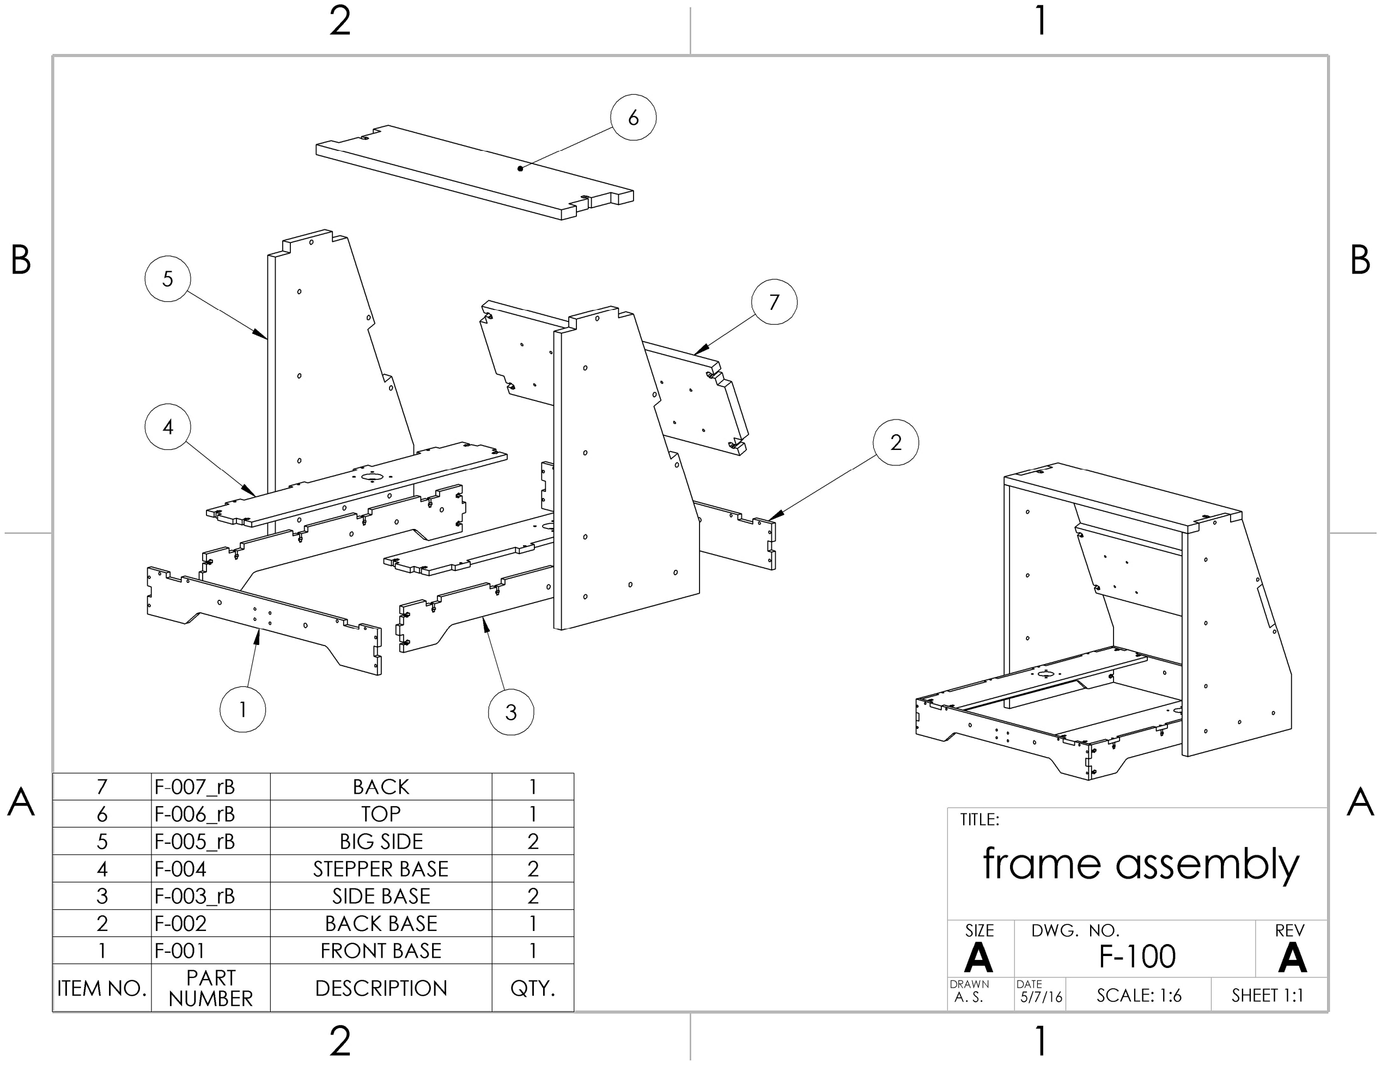
[picture p23: page 1]
