a-drizzle/Printer1/production_parts/drawings/X-100.pdf

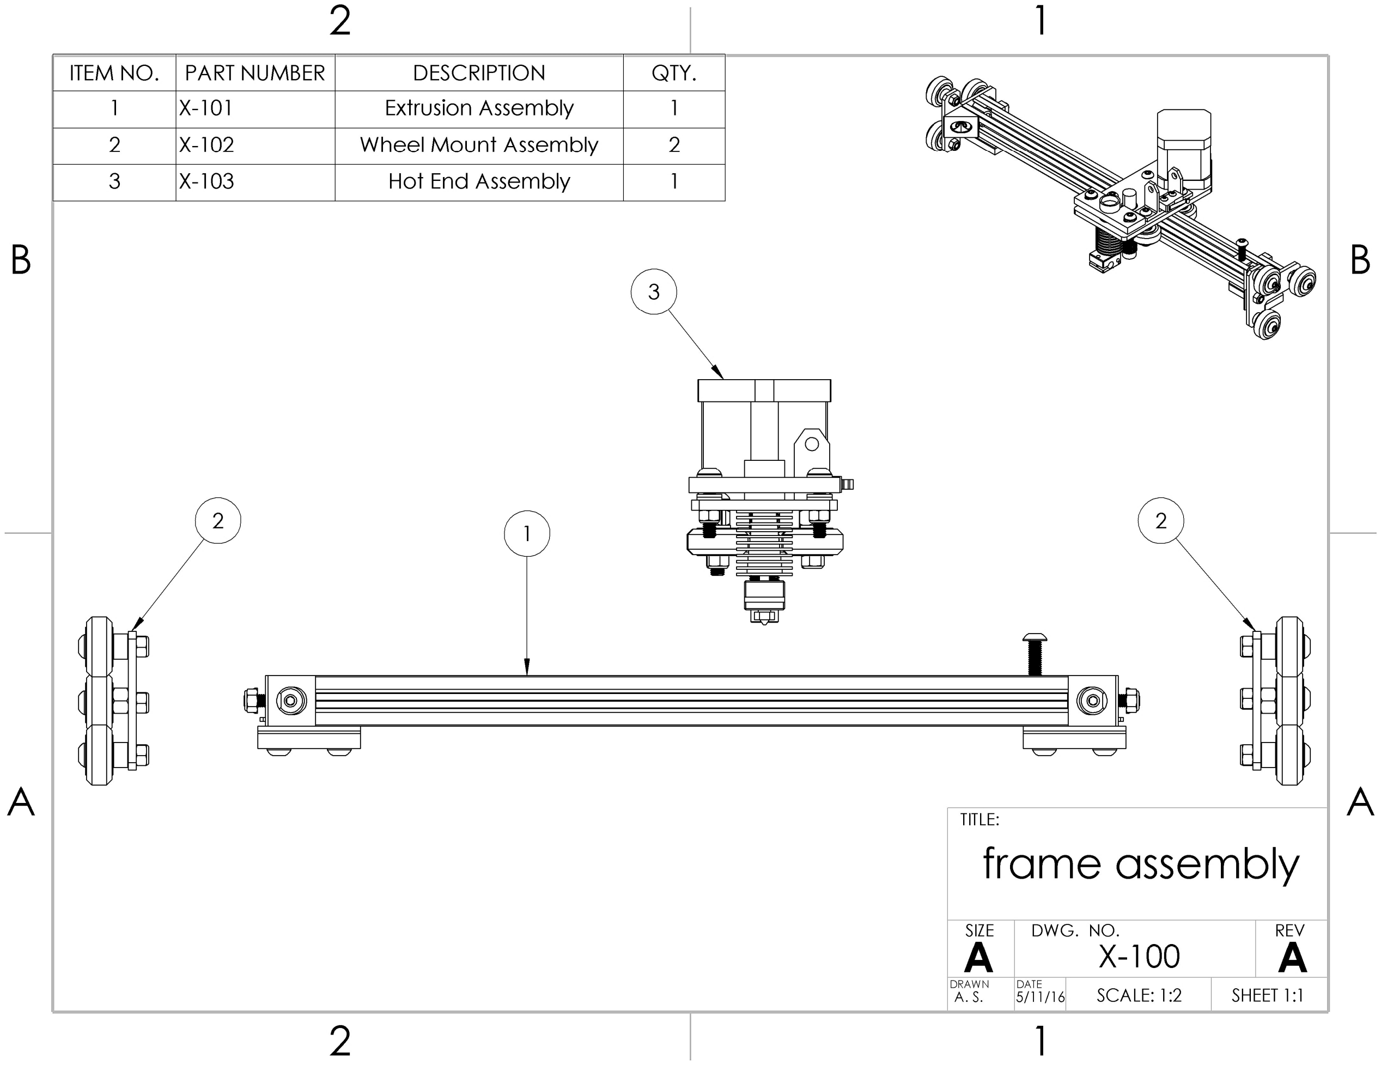
[picture p24: page 1]
