a-drizzle/Printer1/production_parts/drawings/X-101.pdf

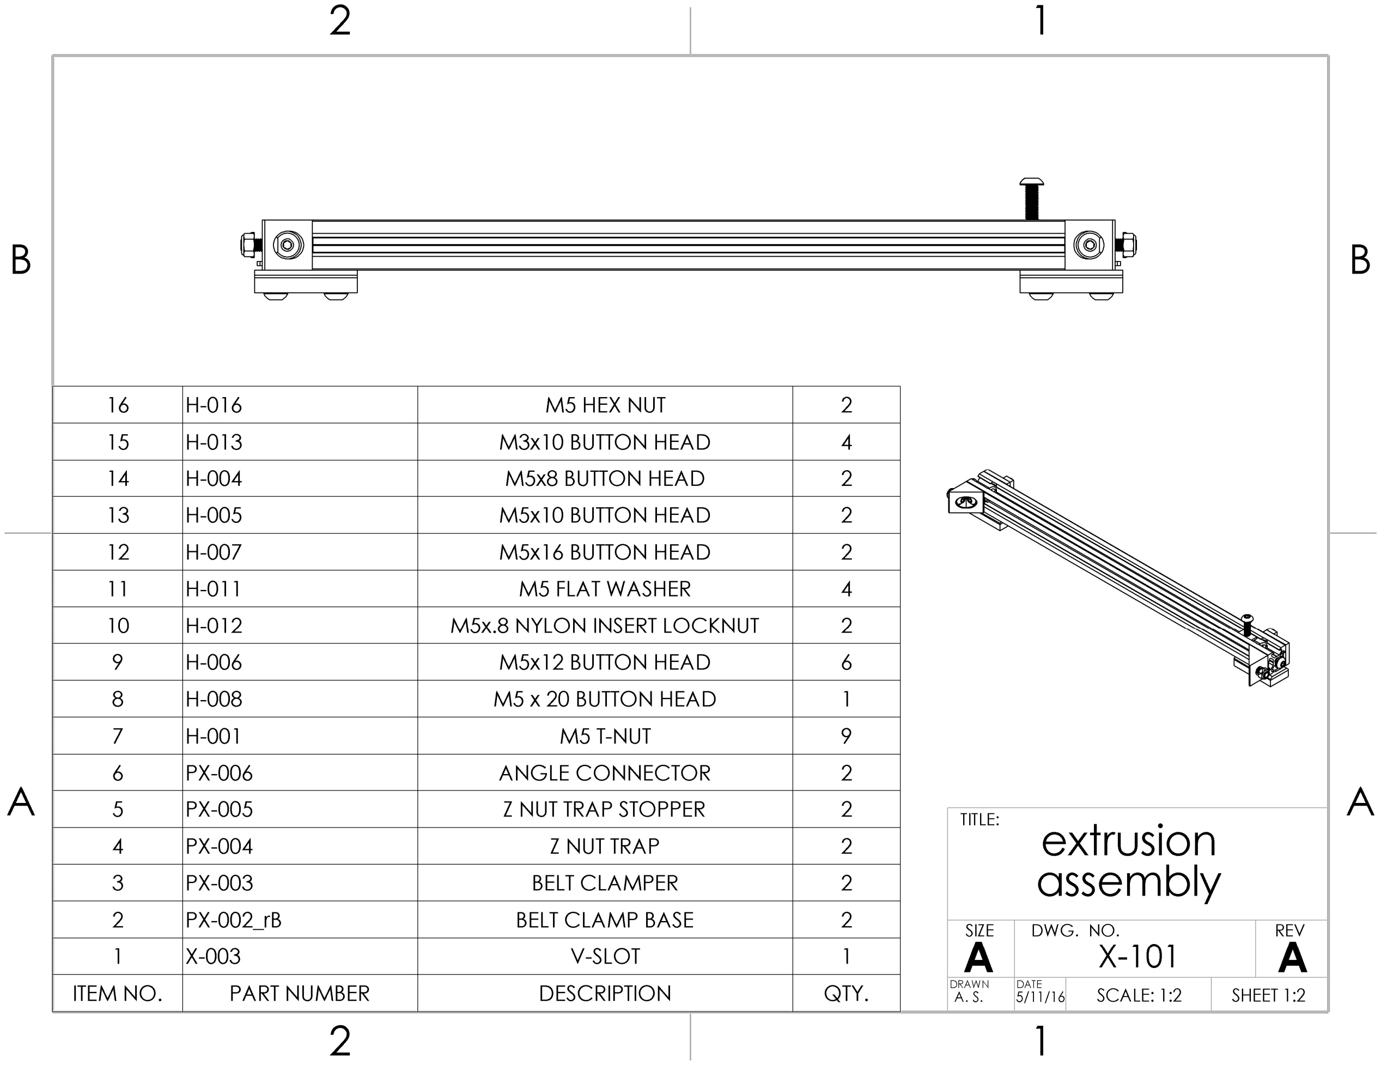
[picture p25: page 1]
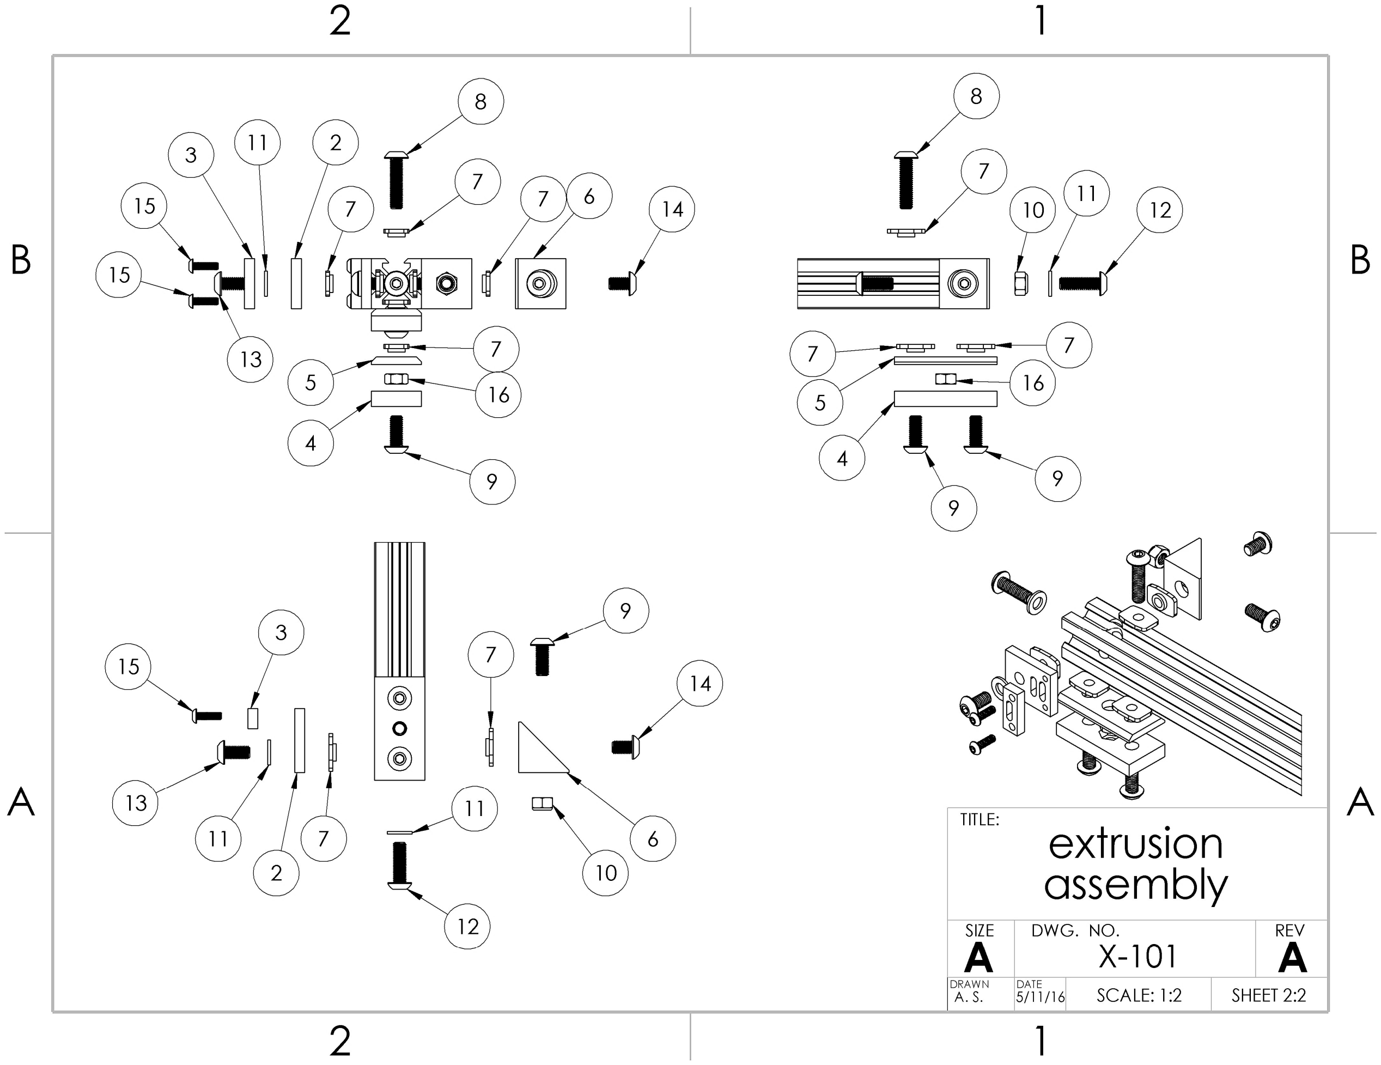
[picture p26: page 2]
