a-drizzle/Printer1/production_parts/drawings/X-102.pdf

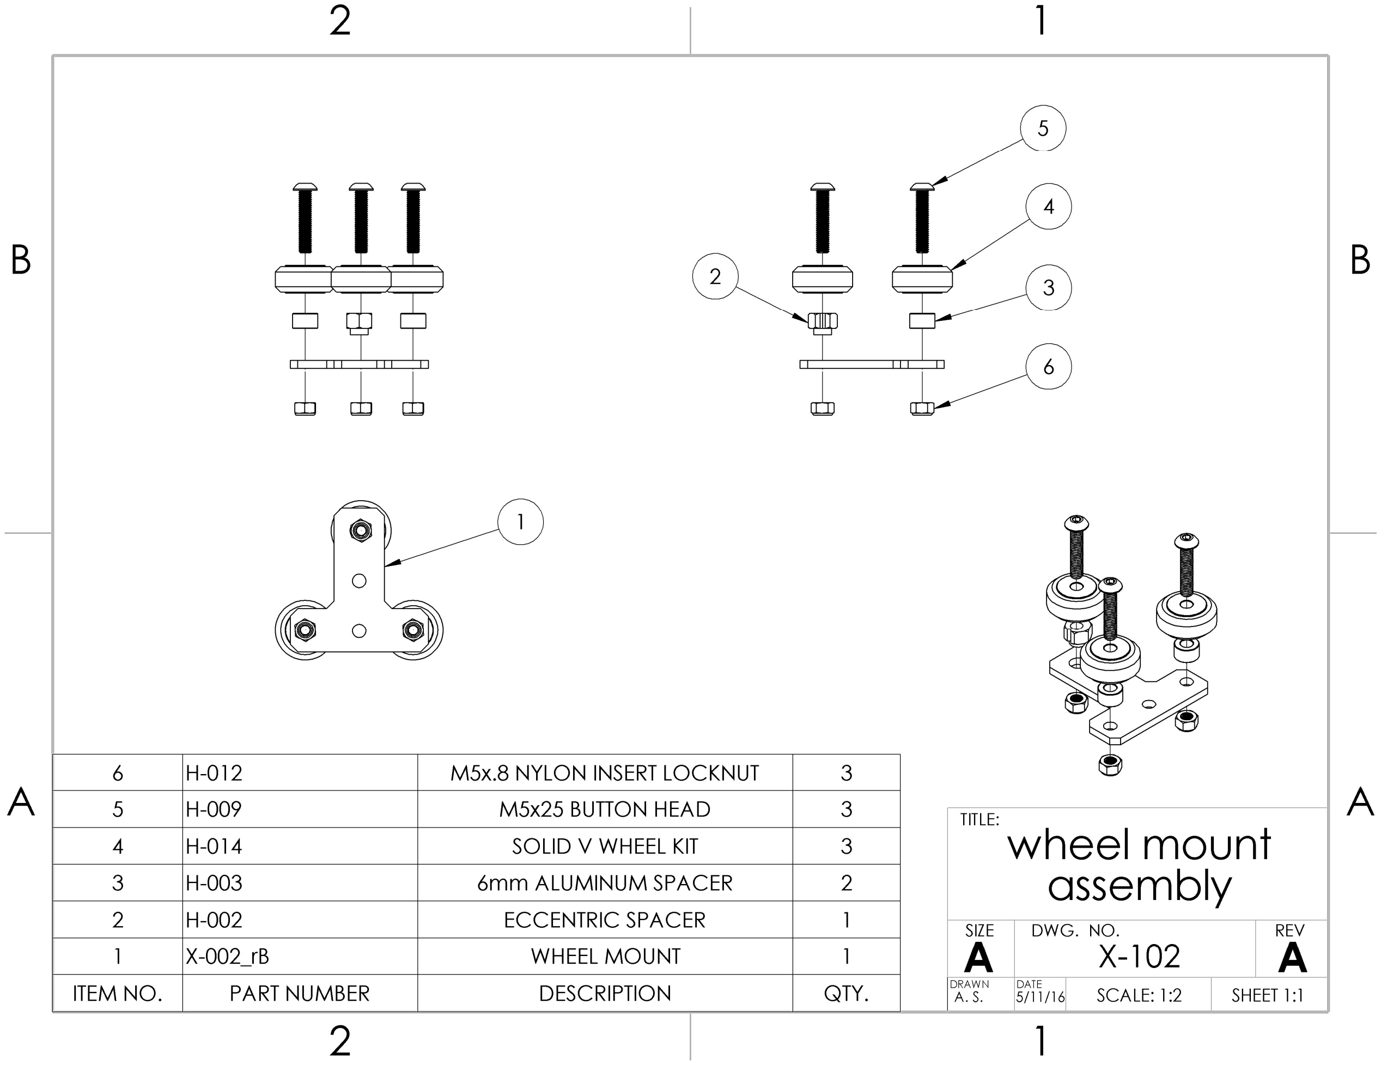
[picture p27: page 1]
