a-drizzle/Printer1/production_parts/drawings/X-103.pdf

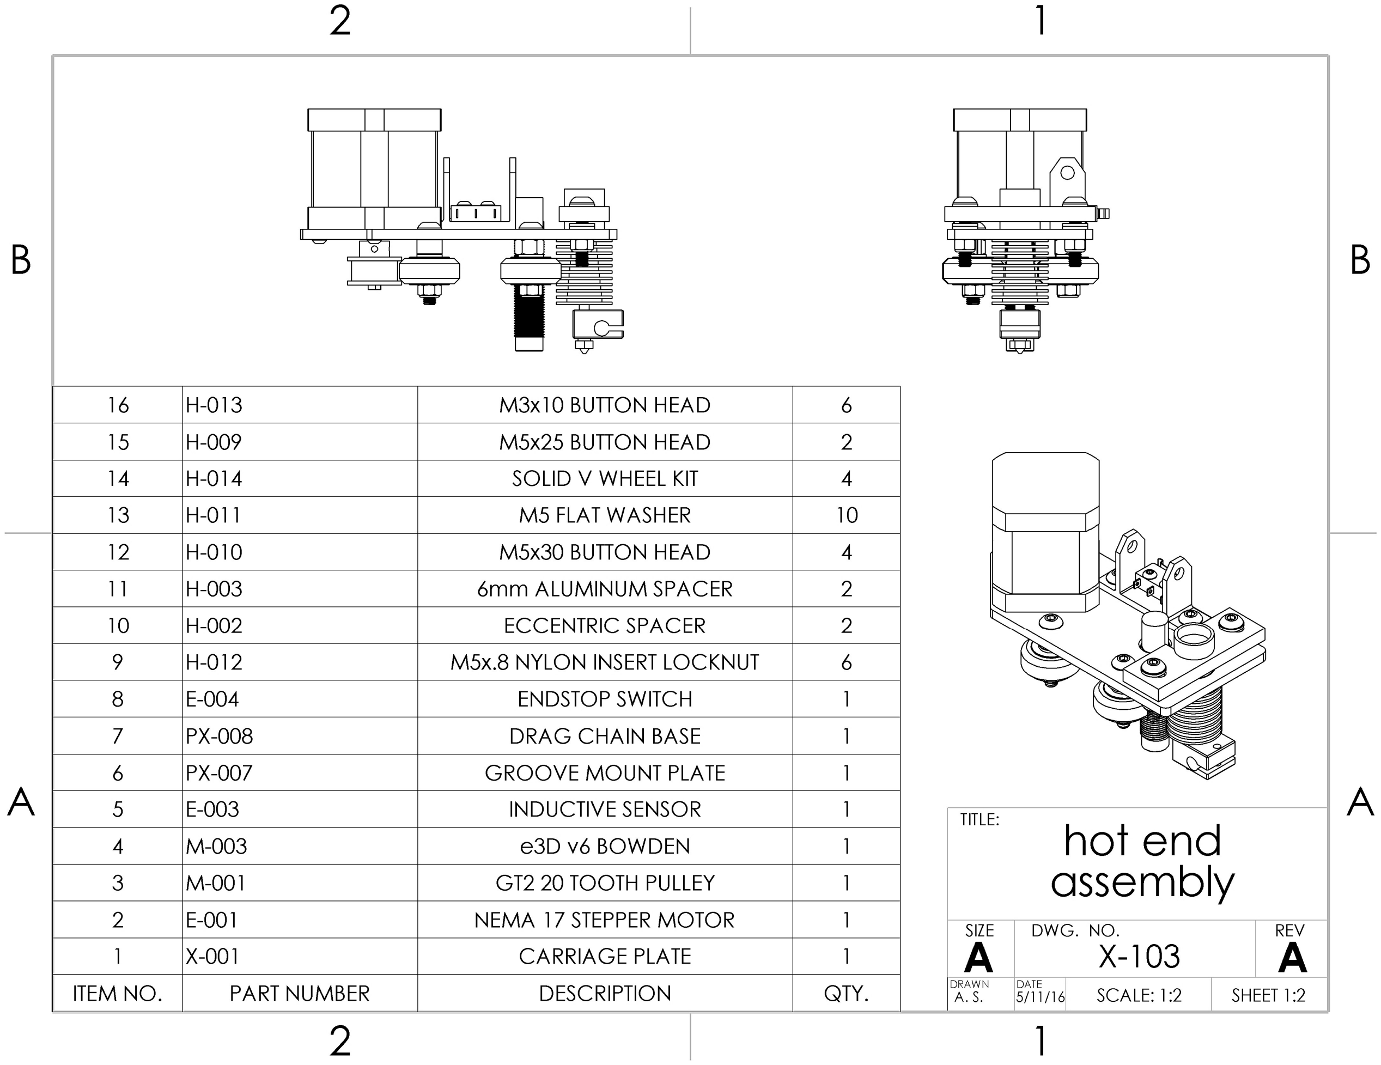
[picture p28: page 1]
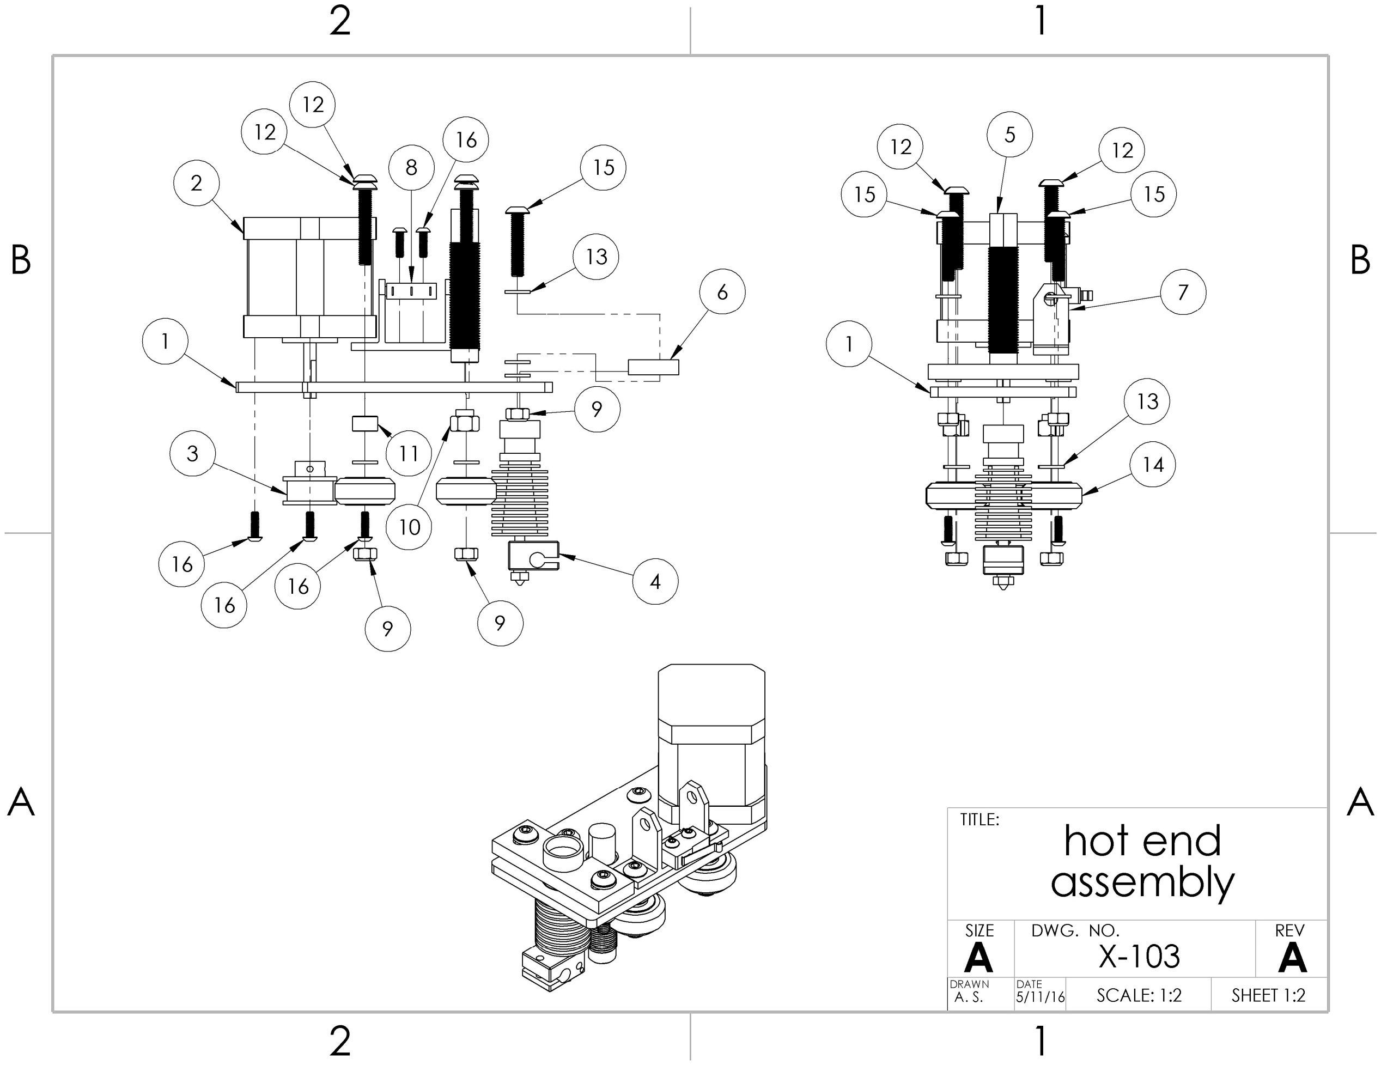
[picture p29: page 2]
