a-drizzle/Printer1/production_parts/drawings/PX-001.pdf

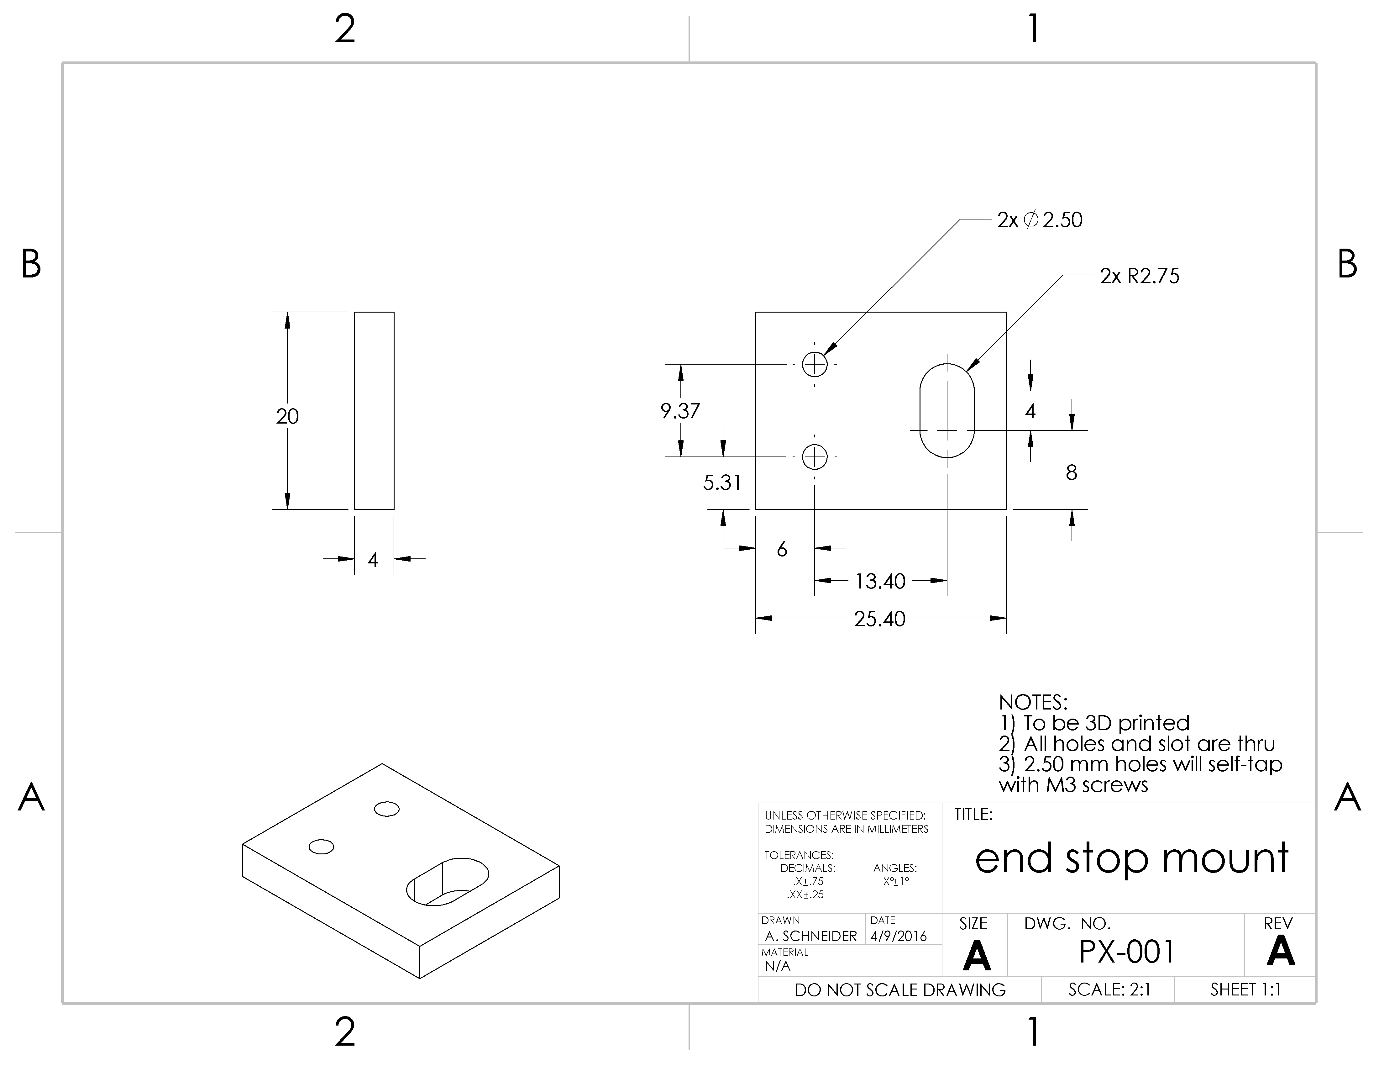
[picture p30: page 1]
