a-drizzle/Printer1/production_parts/drawings/PX-002.pdf

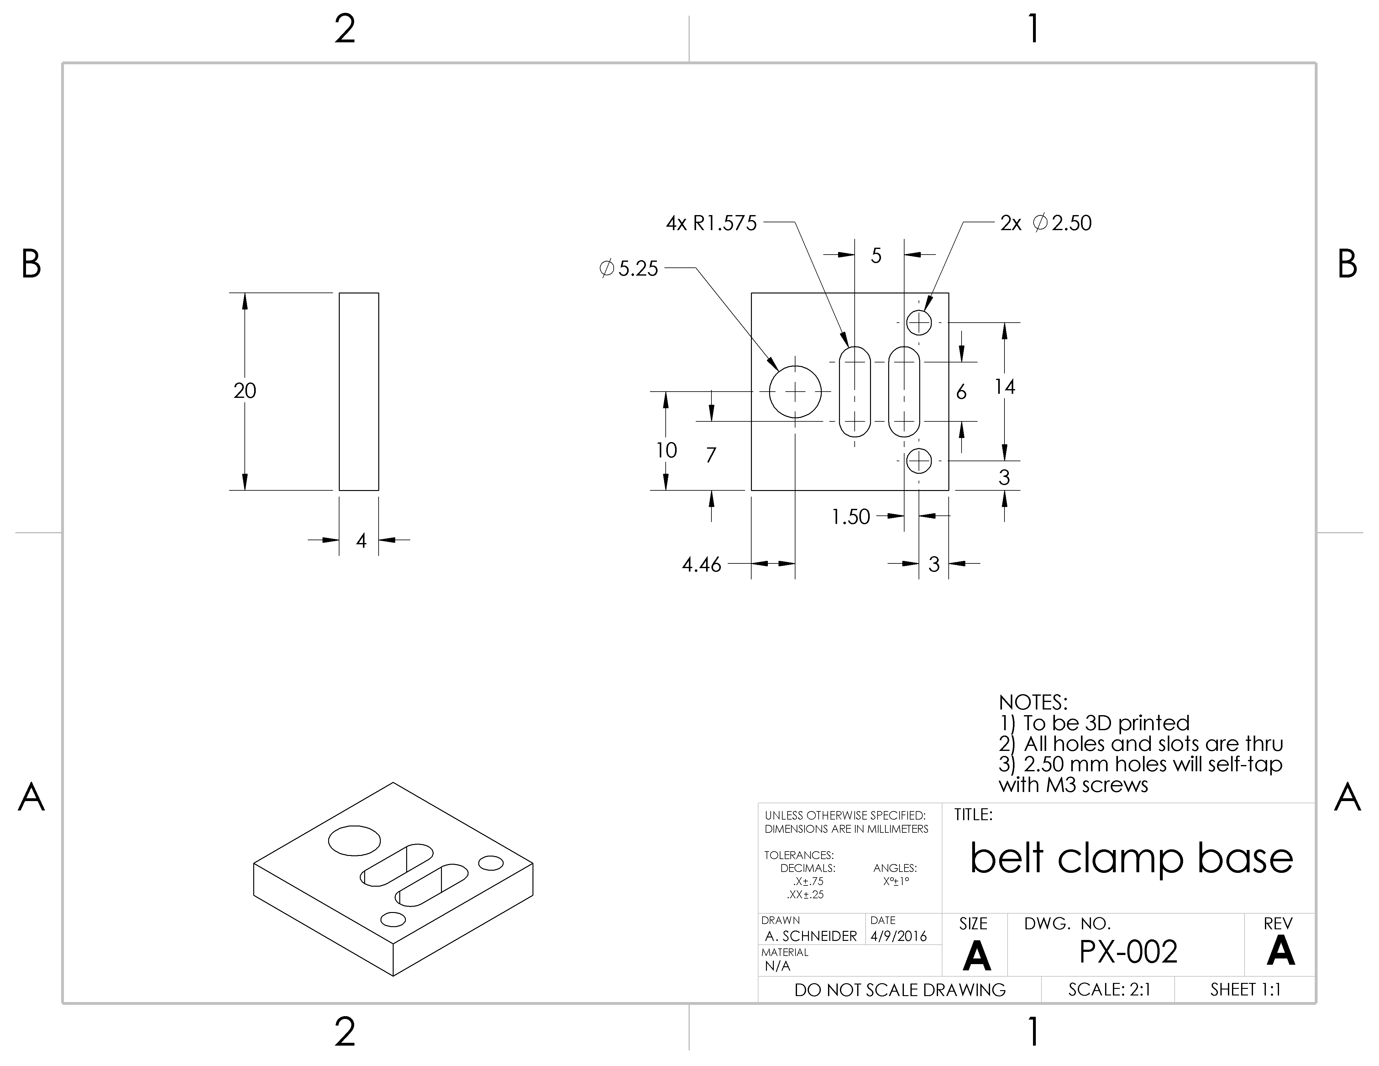
[picture p31: page 1]
