a-drizzle/Printer1/production_parts/drawings/PX-003.pdf

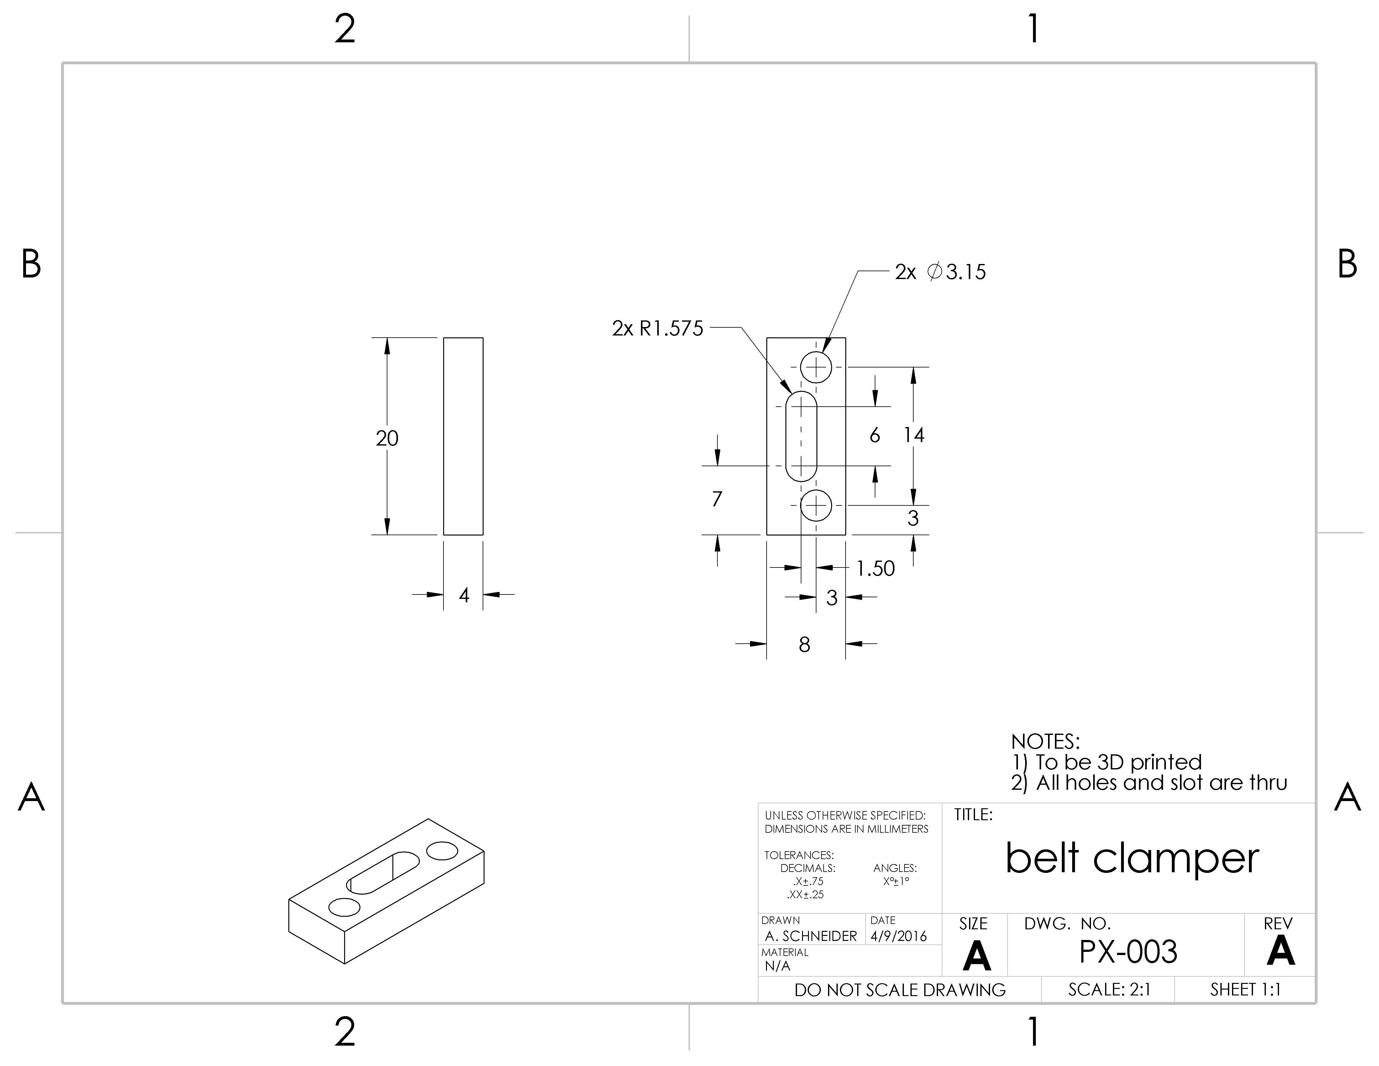
[picture p32: page 1]
