a-drizzle/Printer1/production_parts/drawings/PX-004.pdf

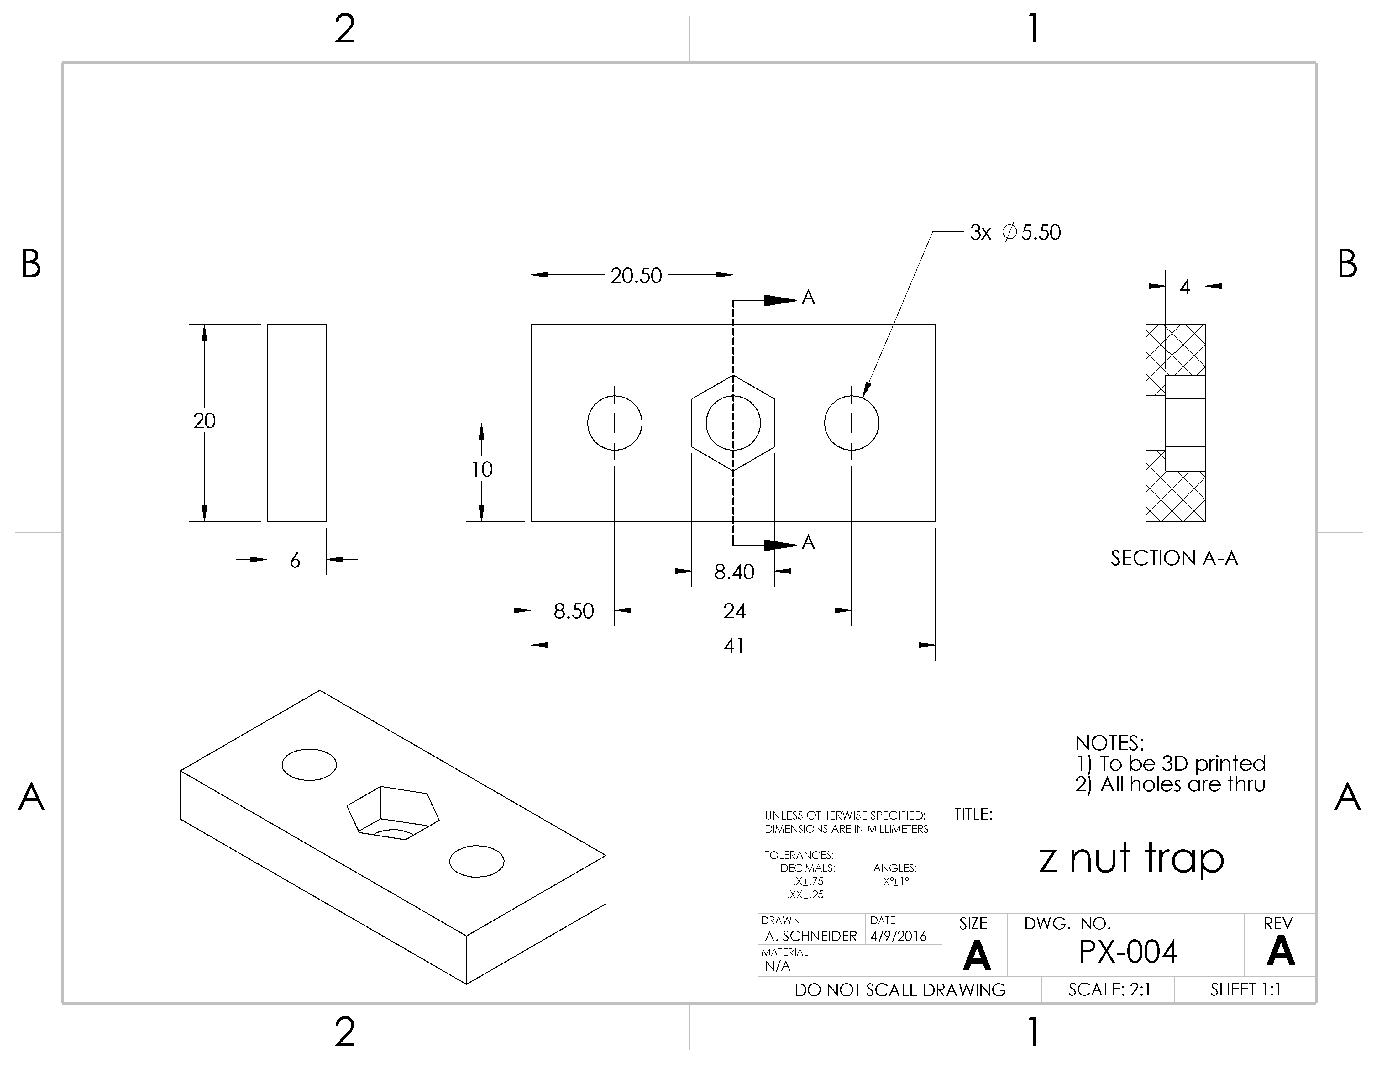
[picture p33: page 1]
