a-drizzle/Printer1/production_parts/drawings/Y-001.pdf

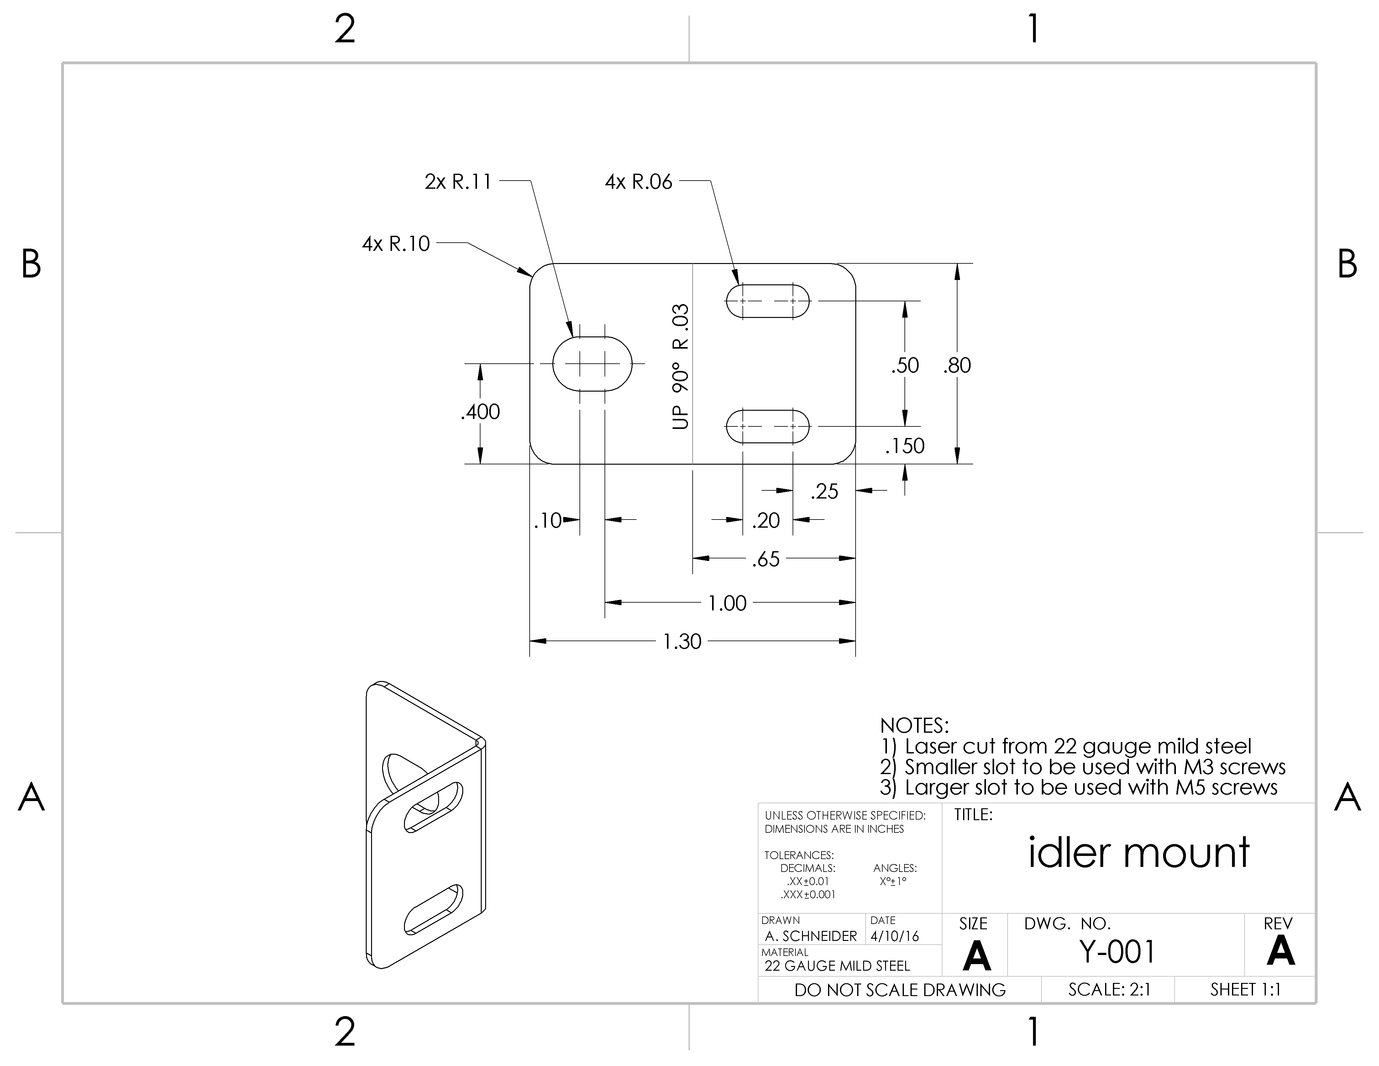
[picture p34: page 1]
