a-drizzle/Printer1/production_parts/drawings/Y-002.pdf

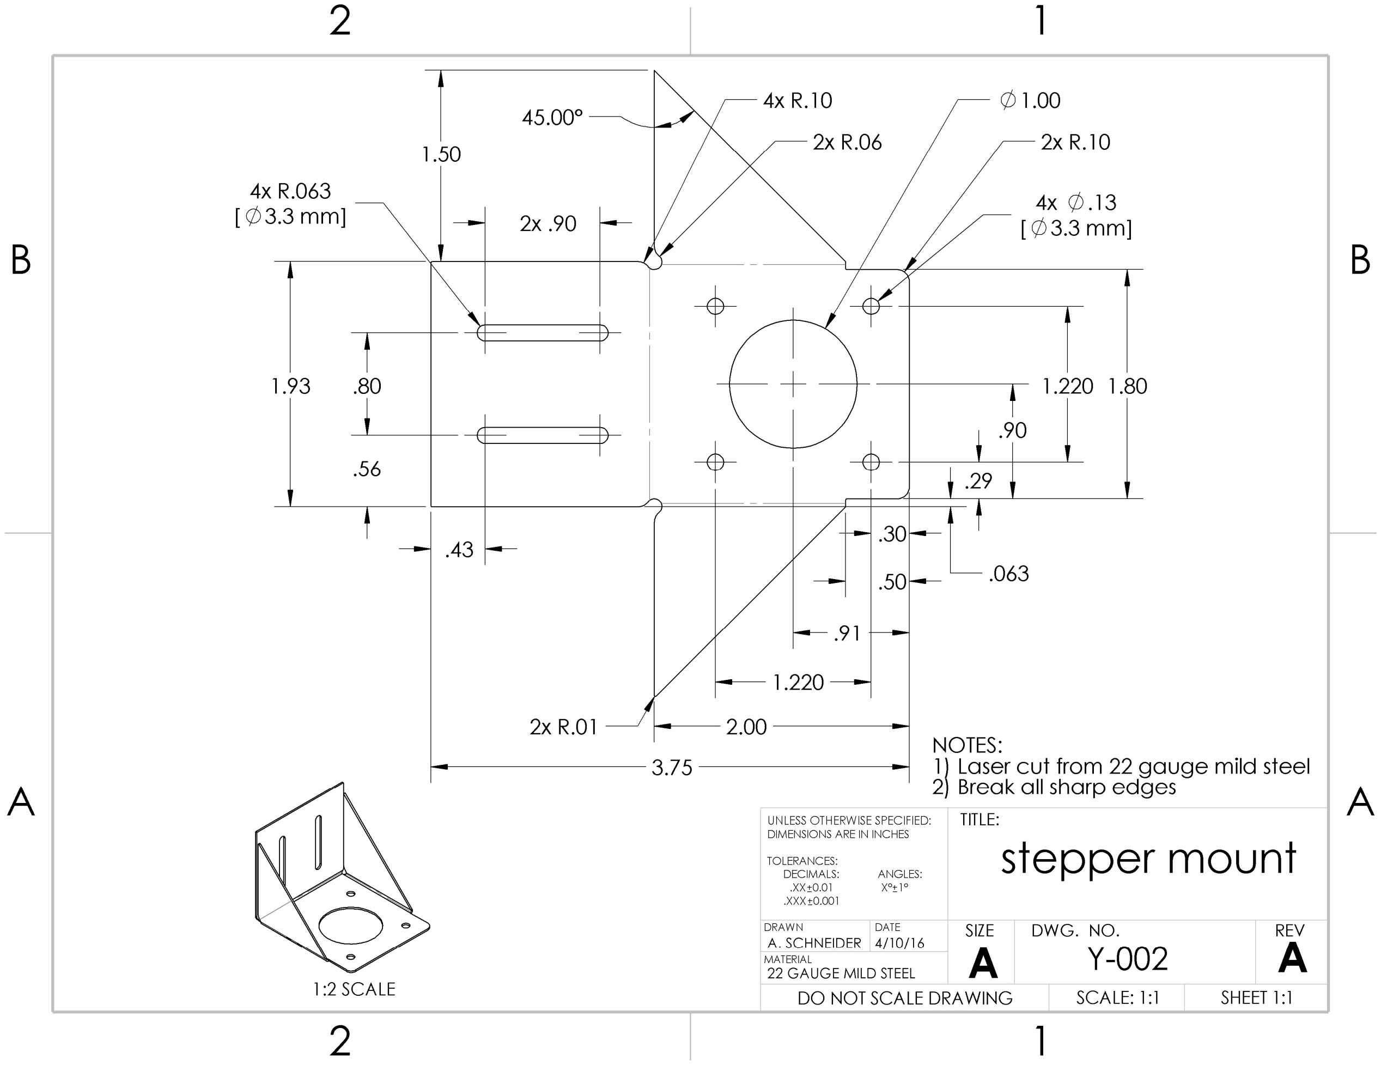
[picture p35: page 1]
