a-drizzle/Printer1/production_parts/drawings/Y-003.pdf

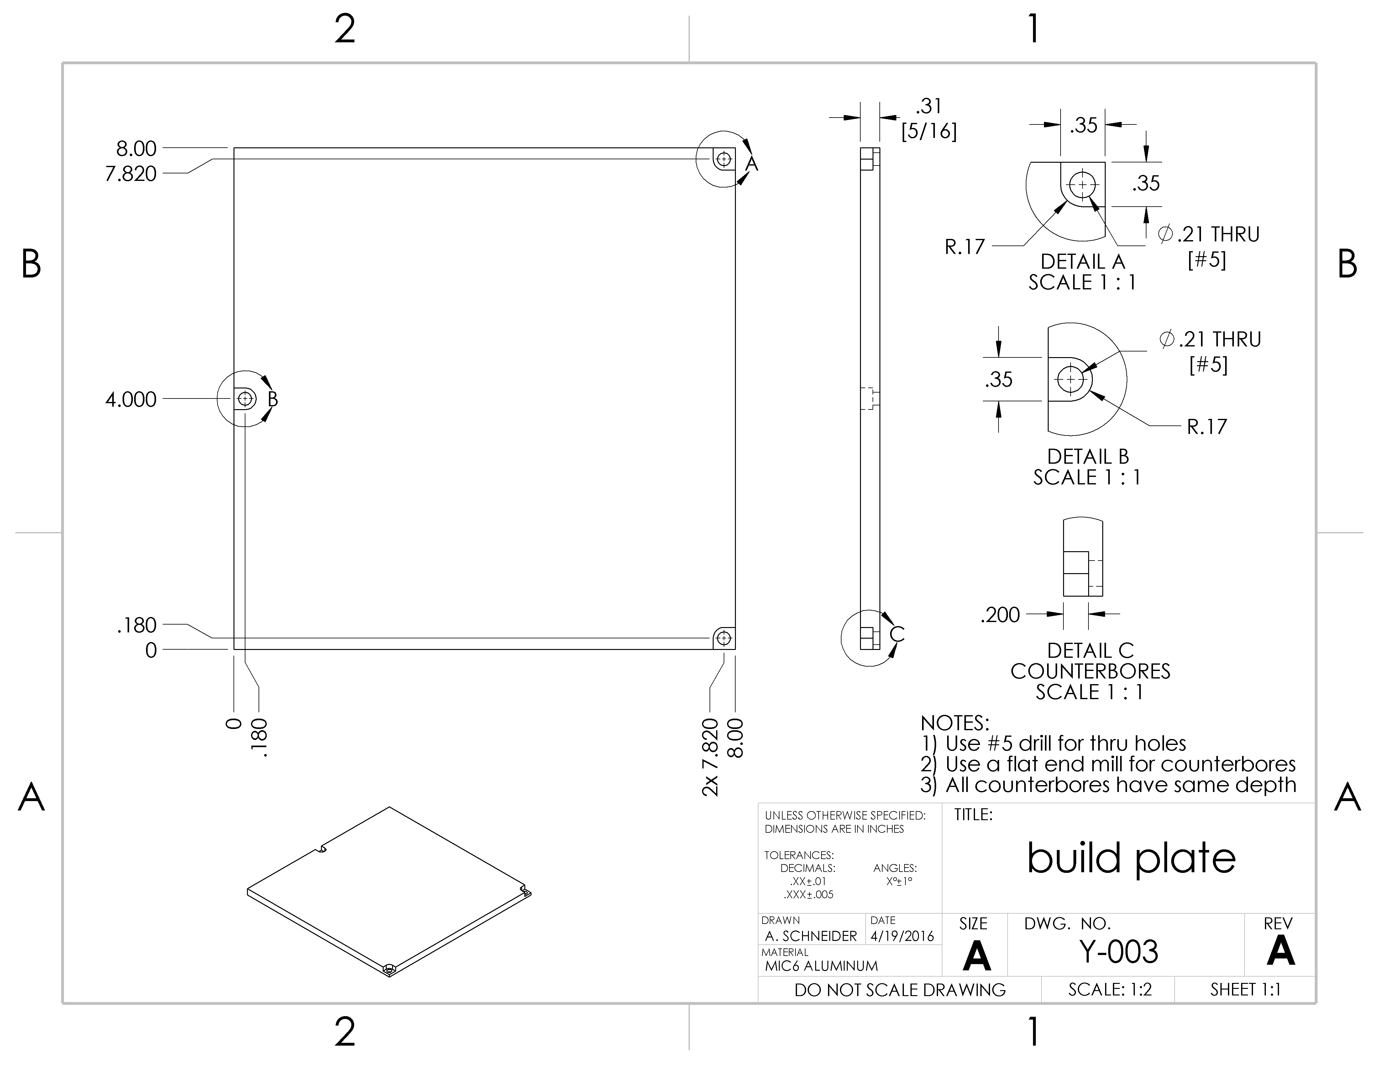
[picture p36: page 1]
