a-drizzle/Printer1/production_parts/laser_cut_parts/F-001.pdf

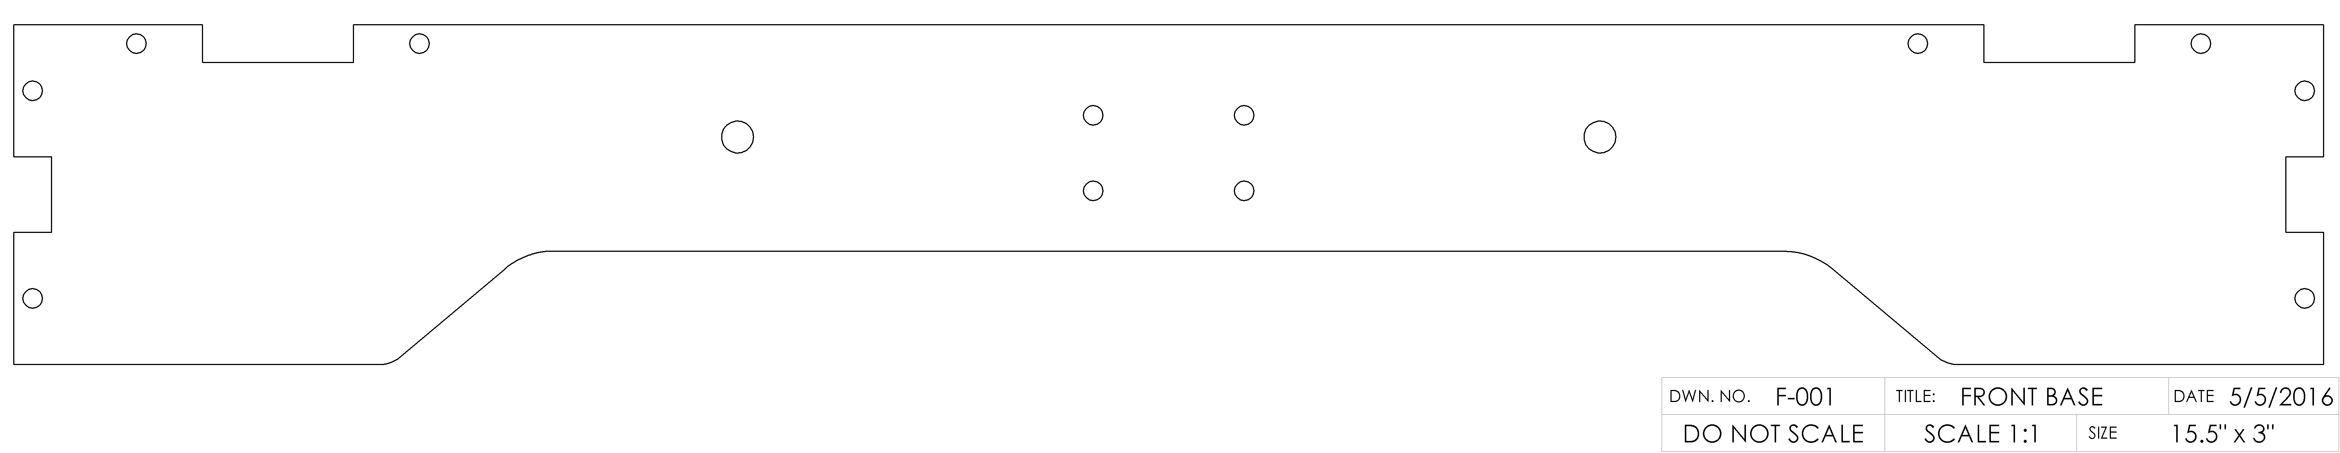
[picture p37: page 1]
