a-drizzle/Printer1/production_parts/laser_cut_parts/F-004.pdf

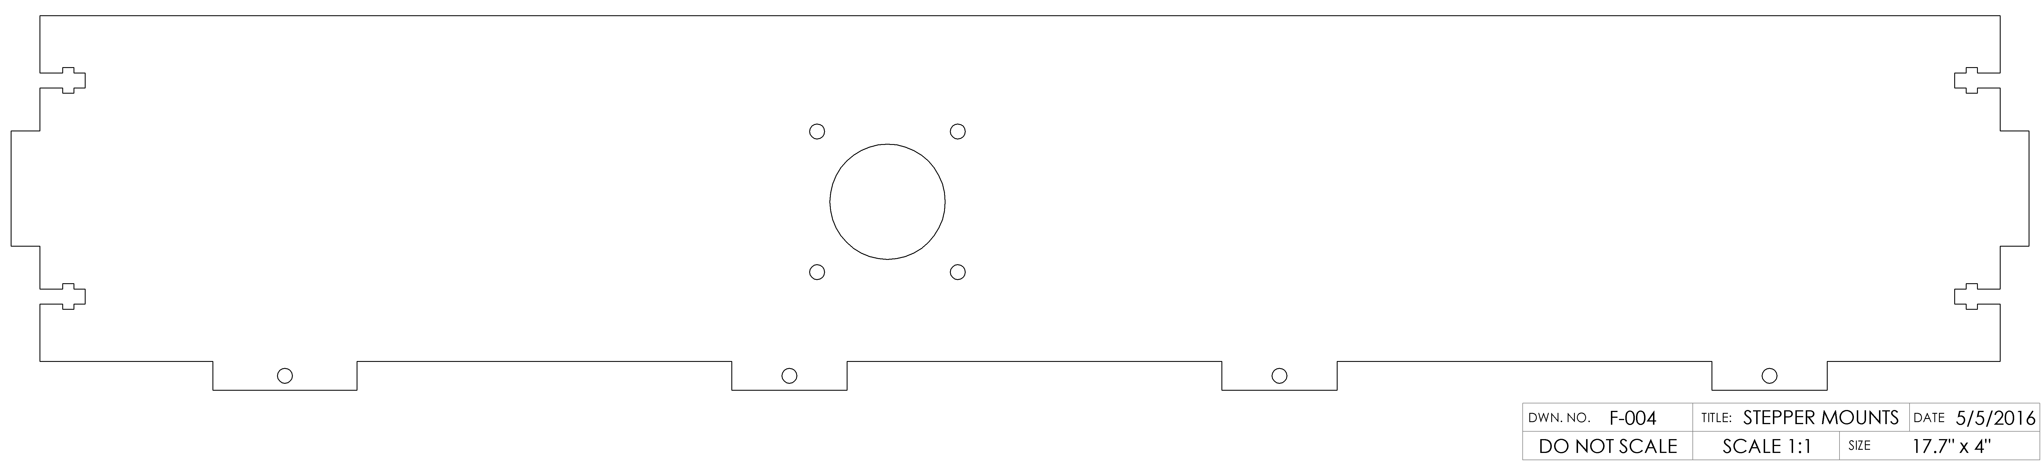
[picture p38: page 1]
