a-drizzle/Printer1/production_parts/laser_cut_parts/full_sheets/F-007_&_F-006.pdf

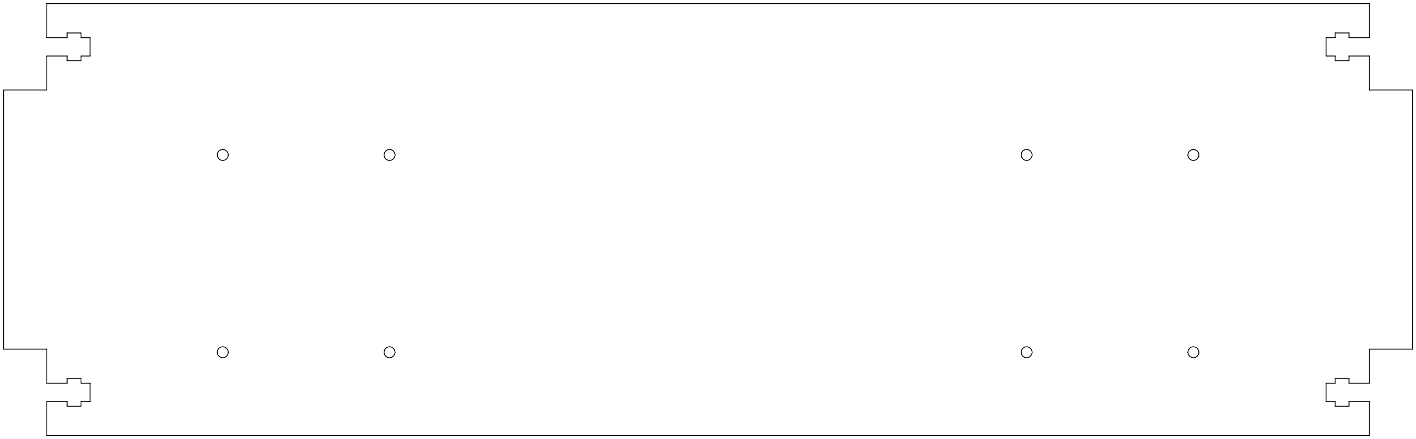
[picture p39: figure]
