a-drizzle/Printer1/CAD/solidworks/X-102.SLDASM

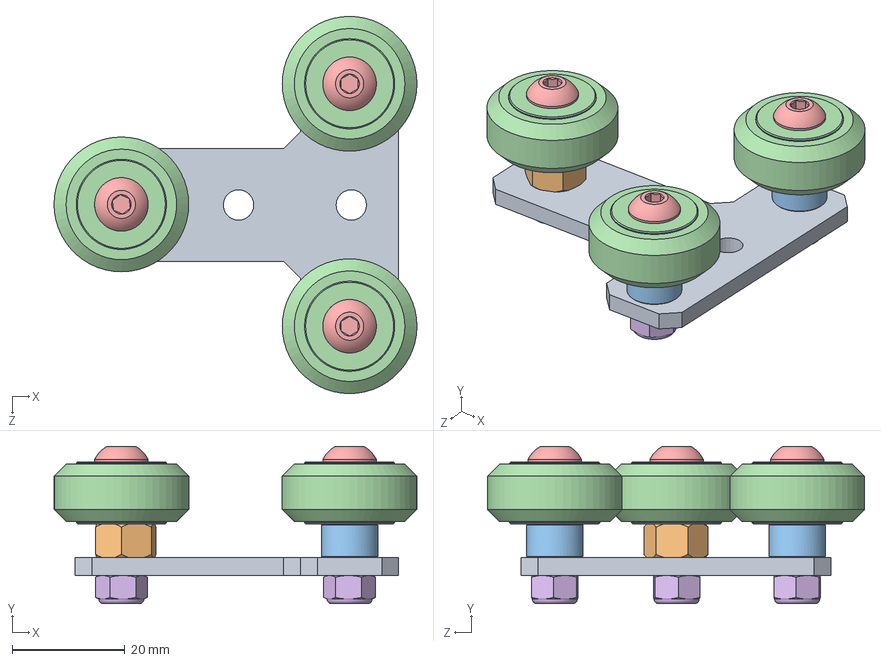
[picture p40: CAD file, 2016-05-18]
CAD/solidworks/X-102.SLDASM
64.4 x 27.9 x 66.9 mm
X-002_rB
H-002
H-003 x 2
H-014 x 3
H-009 x 3
H-012 x 3
