a-drizzle/Printer1/CAD/solidworks/F-101.SLDASM

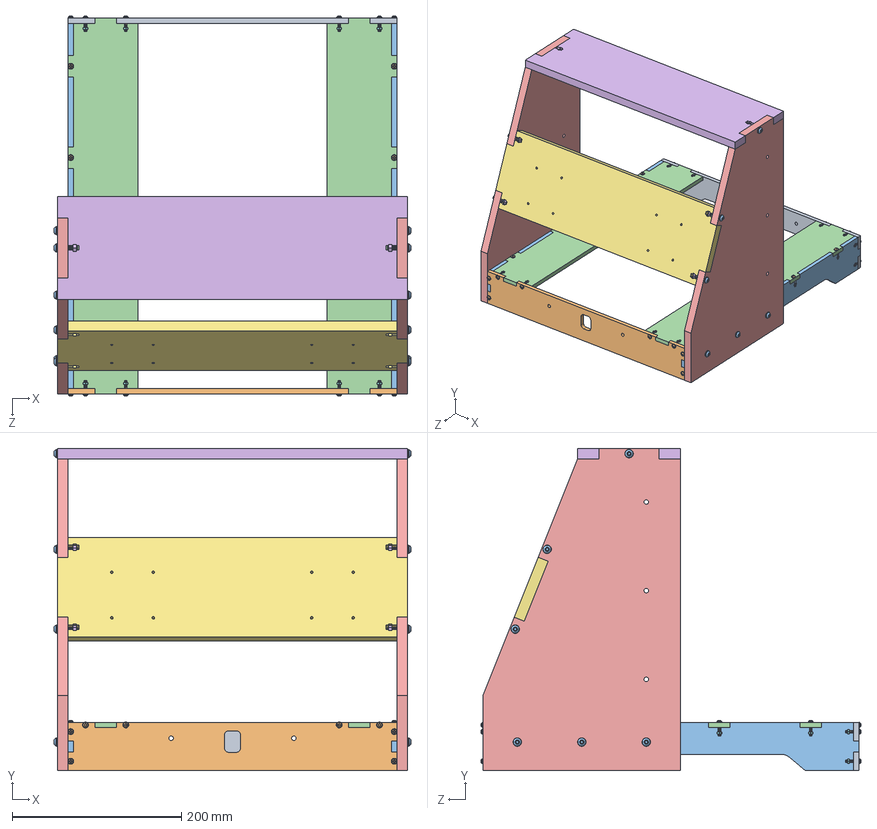
[picture p41: CAD file, 2016-05-18]
CAD/solidworks/F-101.SLDASM
421.7 x 381.0 x 449.0 mm
F-001
F-002
F-003_rB x 2
F-004 x 2
F-005_rB x 2
F-006_rB
F-007_rB
H-020 x 24
H-024 x 24
H-022 x 24
H-009 x 12
H-011 x 12
H-012 x 6
H-016 x 6
