a-drizzle/Printer1/CAD/solidworks/X-101.SLDASM

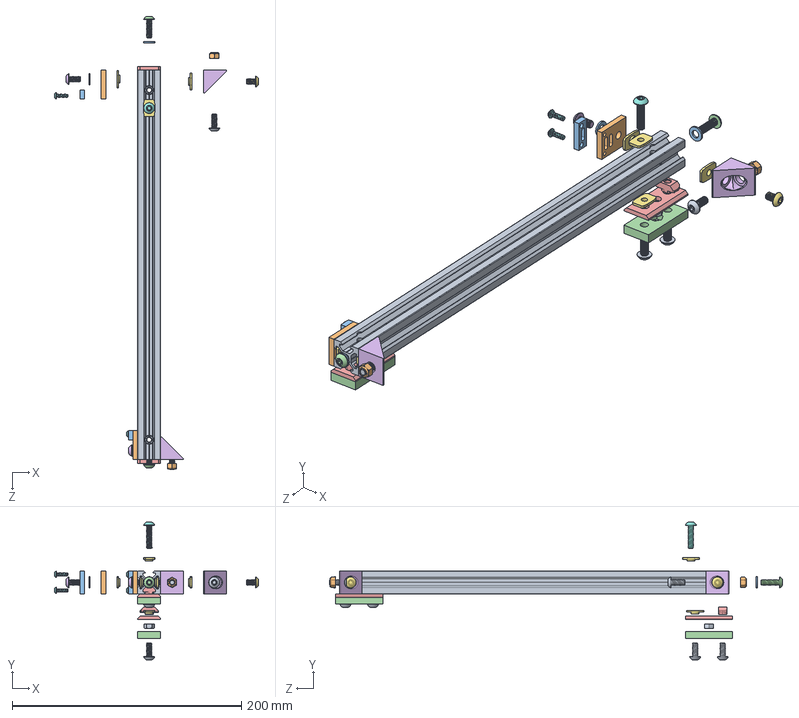
[picture p42: CAD file, 2016-05-18]
CAD/solidworks/X-101.SLDASM
178.0 x 120.0 x 394.8 mm
X-003
PX-002_rB x 2
PX-003 x 2
PX-004 x 2
PX-005 x 2
PX-006 x 2
H-001 x 7
H-008
H-006 x 6
H-012 x 2
H-011 x 4
H-007 x 2
H-015 x 2
H-005 x 2
H-004 x 2
H-013 x 4
H-016 x 2
