a-drizzle/Printer1/CAD/solidworks/X-103.SLDASM

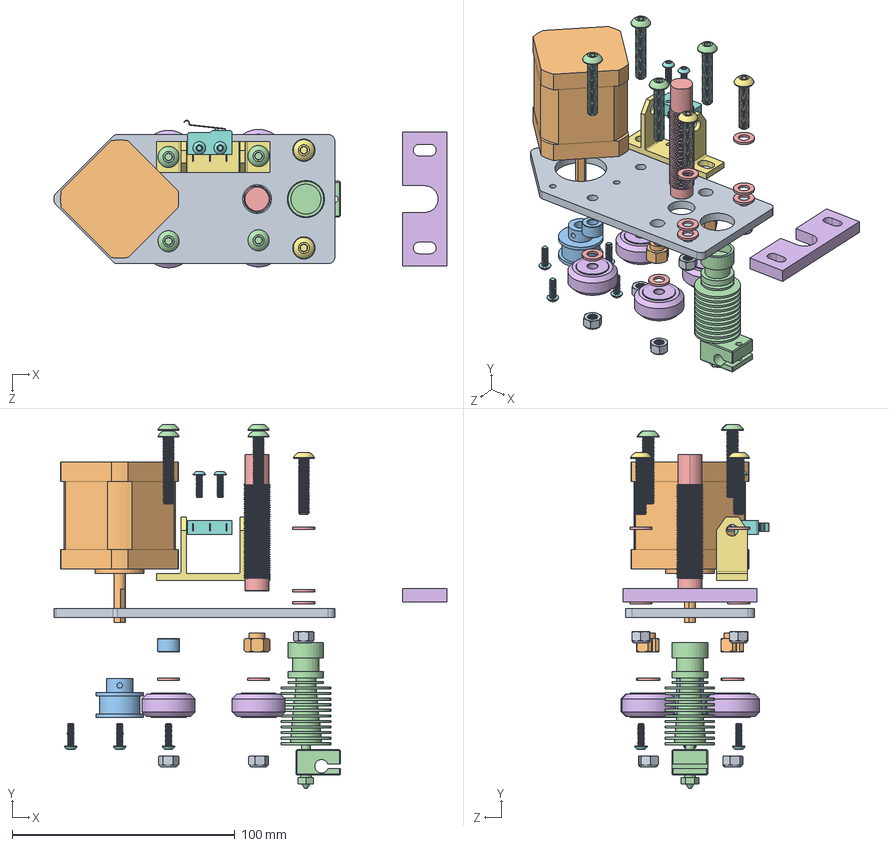
[picture p43: CAD file, 2016-05-12]
CAD/solidworks/X-103.SLDASM
176.3 x 163.3 x 66.3 mm
X-001
E-001
M-001
M-003
E-003
PX-007
PX-008
E-004
H-012 x 6
H-002 x 2
H-003 x 2
H-010 x 4
H-011 x 10
H-014 x 4
H-009 x 2
H-013 x 6
