a-drizzle/Printer1/CAD/solidworks/electronics/E-002.SLDPRT

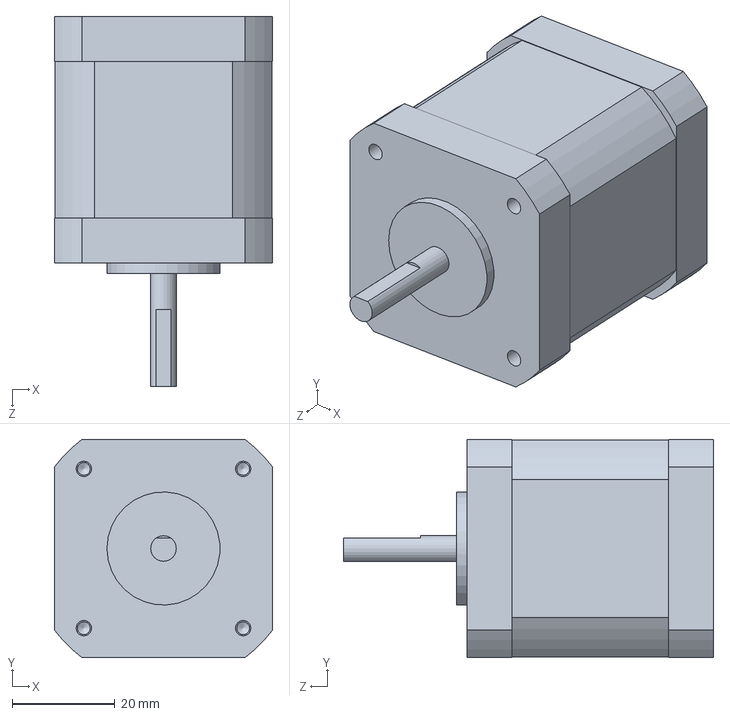
[picture p44: CAD file, 2016-05-18]
CAD/solidworks/electronics/E-002.SLDPRT
42.4 x 42.4 x 72.0 mm
