a-drizzle/Printer1/CAD/solidworks/hardware/H-017.SLDPRT

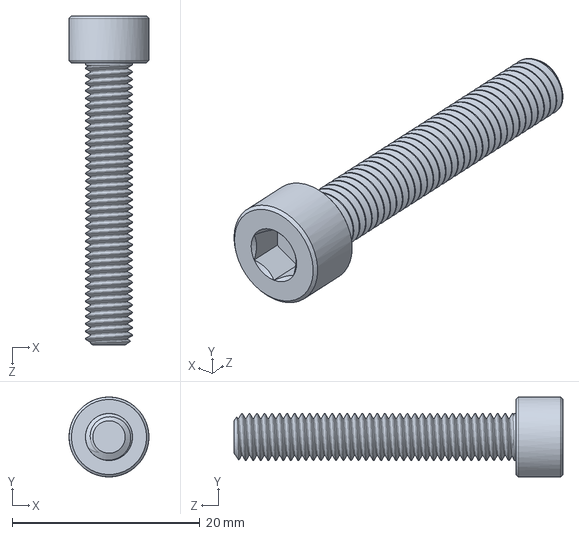
[picture p45: CAD file, 2016-05-18]
CAD/solidworks/hardware/H-017.SLDPRT
8.50 x 8.49 x 35.0 mm
