a-drizzle/Printer1/CAD/solidworks/PX-004.SLDPRT

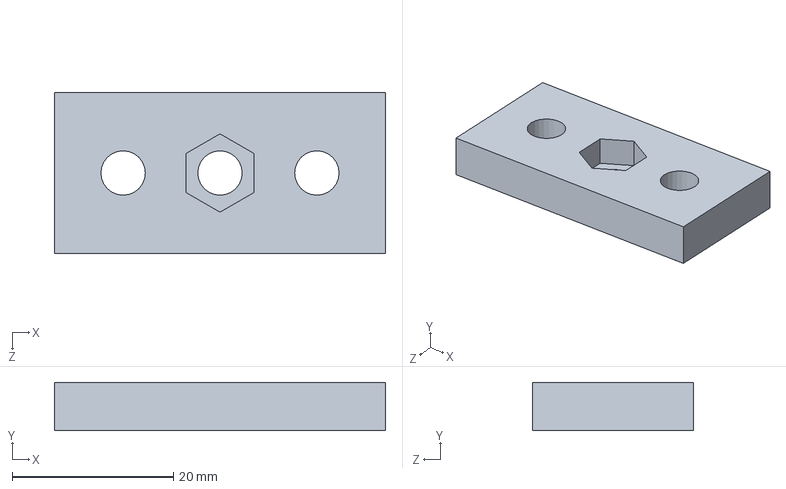
[picture p46: CAD file, 2016-05-18]
CAD/solidworks/PX-004.SLDPRT
41.0 x 6.00 x 20.0 mm
