a-drizzle/Printer1/production_parts/printed_parts/PX-005.STL

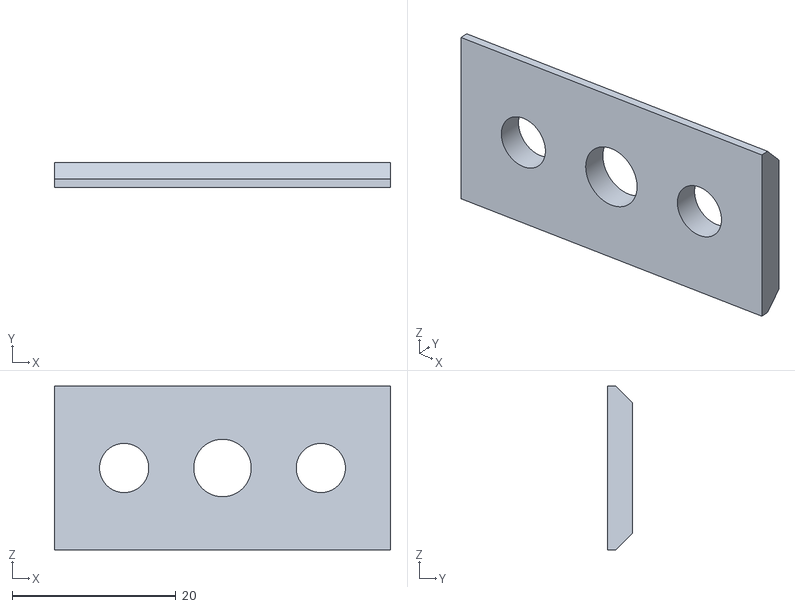
[picture p47: CAD file, 2016-05-18]
production_parts/printed_parts/PX-005.STL
41.0 x 3.00 x 20.0
