a-drizzle/Printer1/production_parts/solidworks/Y-001.SLDPRT

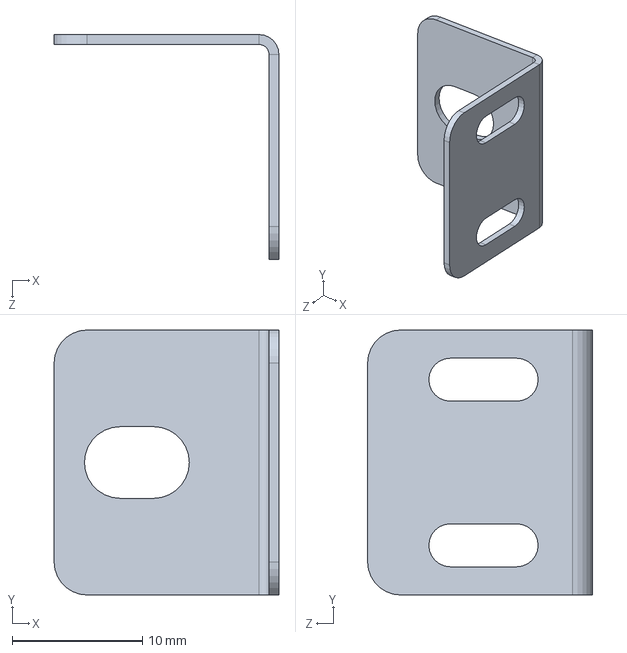
[picture p48: CAD file, 2016-05-18]
production_parts/solidworks/Y-001.SLDPRT
17.2 x 20.3 x 17.2 mm
