a-drizzle/Printer1/CAD/solidworks/electronics/E-003.SLDPRT

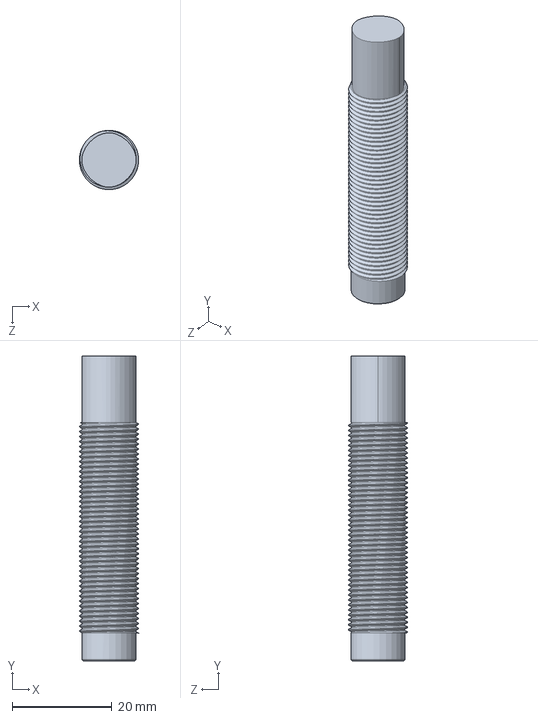
[picture p49: CAD file, 2016-05-18]
CAD/solidworks/electronics/E-003.SLDPRT
11.9 x 61.2 x 11.9 mm
