a-drizzle/Printer1/CAD/solidworks/F-002.SLDPRT

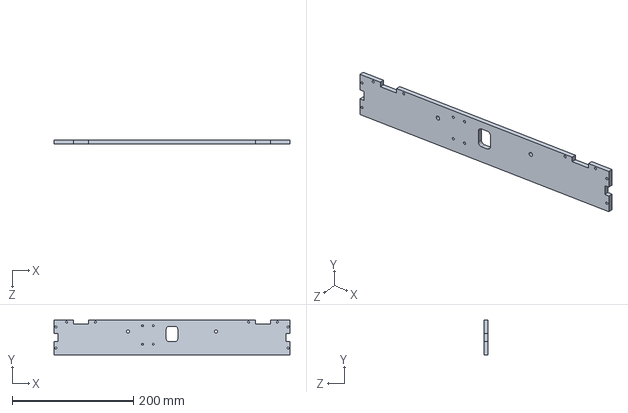
[picture p50: CAD file, 2016-05-18]
CAD/solidworks/F-002.SLDPRT
388.6 x 57.1 x 6.35 mm
