a-drizzle/Printer1/CAD/solidworks/hardware/H-024.SLDPRT

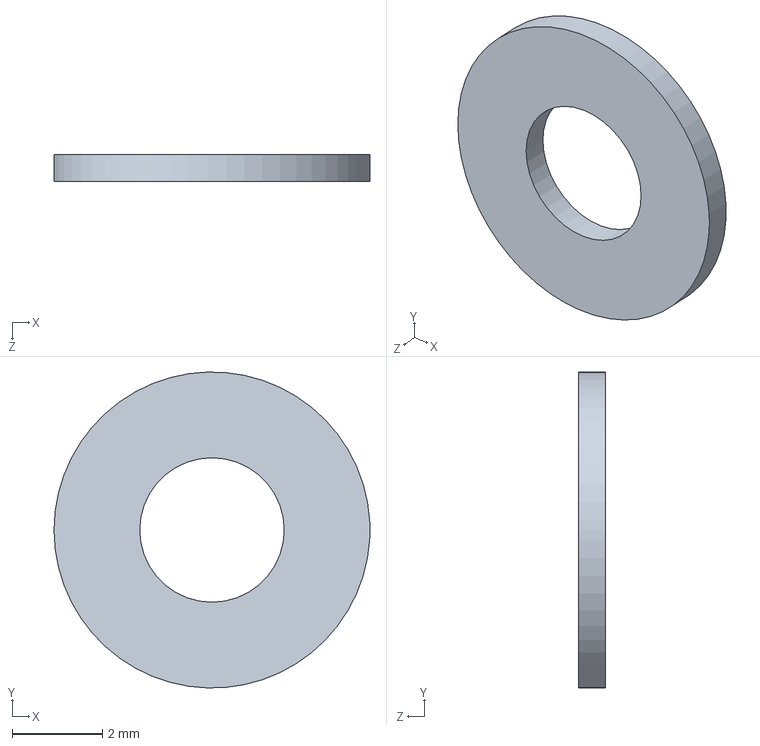
[picture p51: CAD file, 2016-05-18]
CAD/solidworks/hardware/H-024.SLDPRT
7.00 x 7.00 x 0.6 mm
