a-drizzle/Printer1/production_parts/printed_parts/PX-009.STL

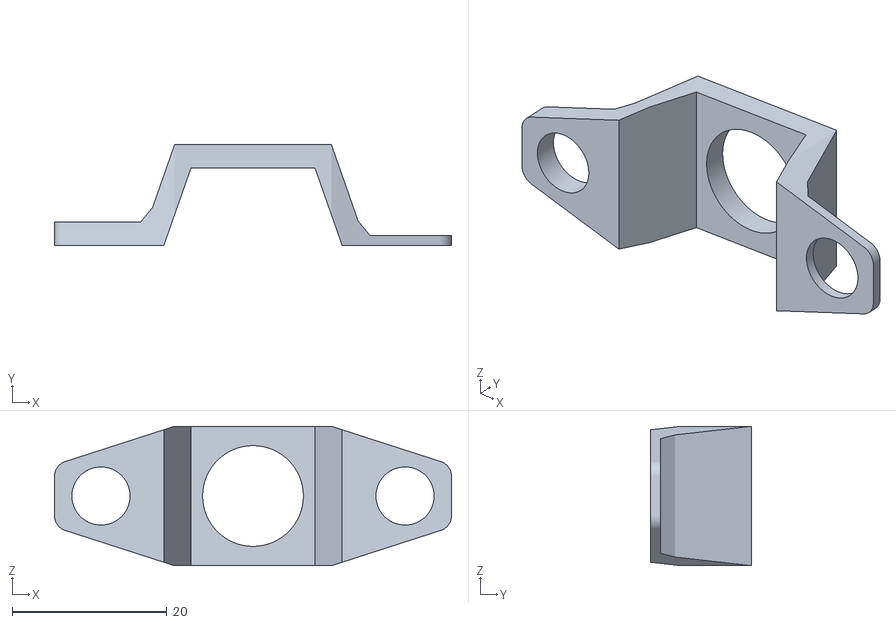
[picture p52: CAD file, 2016-05-18]
production_parts/printed_parts/PX-009.STL
51.3 x 13.0 x 18.0
