a-drizzle/Printer1/production_parts/solidworks/X-003.SLDPRT

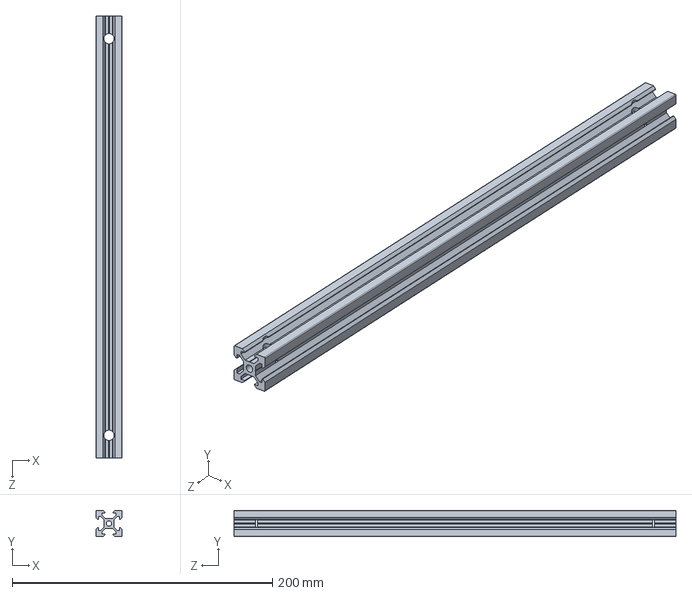
[picture p53: CAD file, 2016-05-18]
production_parts/solidworks/X-003.SLDPRT
20.0 x 20.0 x 339.6 mm
