a-drizzle/Printer1/CAD/solidworks/electronics/E-004.SLDPRT

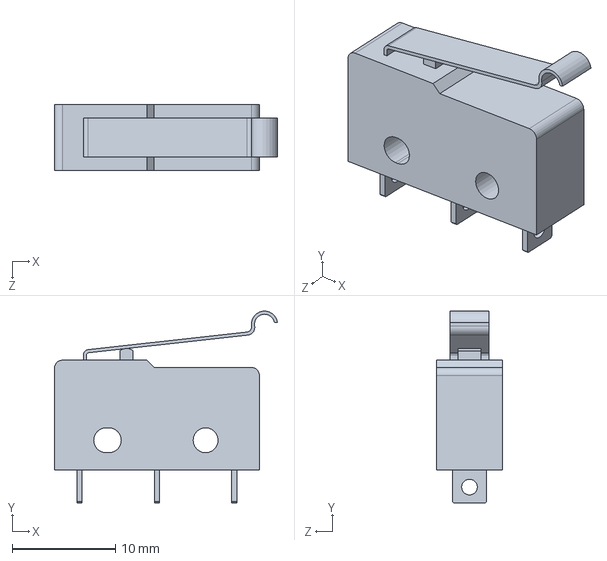
[picture p54: CAD file, 2016-05-18]
CAD/solidworks/electronics/E-004.SLDPRT
21.6 x 18.6 x 6.35 mm
