a-drizzle/Printer1/CAD/solidworks/hardware/H-006.SLDPRT

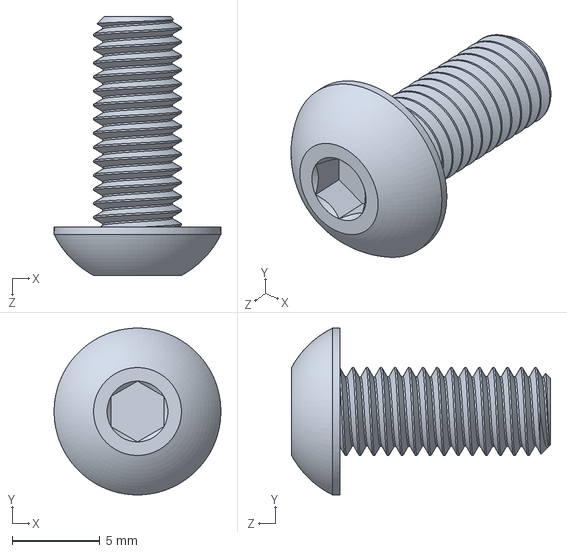
[picture p55: CAD file, 2016-05-18]
CAD/solidworks/hardware/H-006.SLDPRT
9.50 x 9.50 x 14.8 mm
