a-drizzle/Printer1/production_parts/printed_parts/PX-008.STL

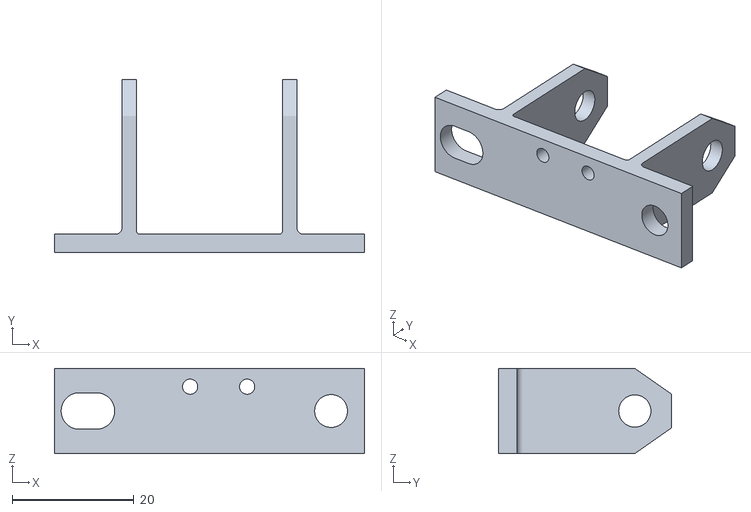
[picture p56: CAD file, 2016-05-18]
production_parts/printed_parts/PX-008.STL
51.0 x 28.4 x 14.0
