a-drizzle/Printer1/production_parts/solidworks/M-003.SLDPRT

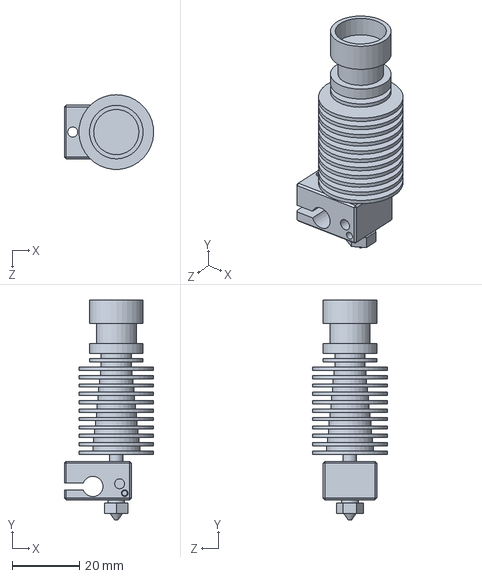
[picture p57: CAD file, 2016-05-18]
production_parts/solidworks/M-003.SLDPRT
26.6 x 65.6 x 22.3 mm
