a-drizzle/Printer1/CAD/solidworks/hardware/H-009.SLDPRT

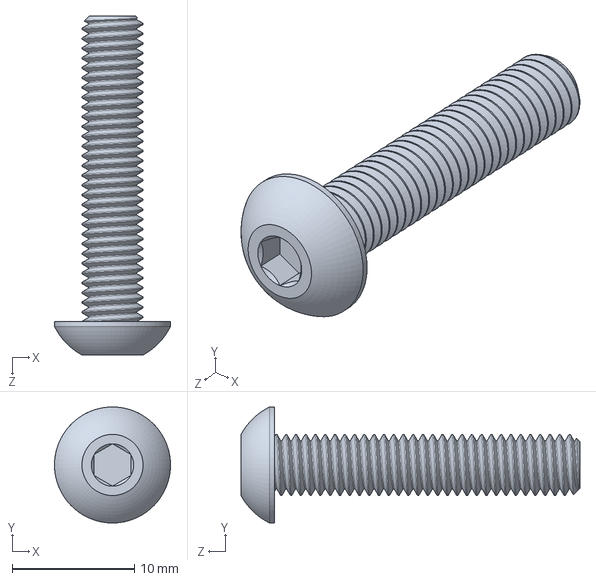
[picture p58: CAD file, 2016-05-18]
CAD/solidworks/hardware/H-009.SLDPRT
9.50 x 9.50 x 27.8 mm
