a-drizzle/Printer1/CAD/solidworks/Y-005.SLDPRT

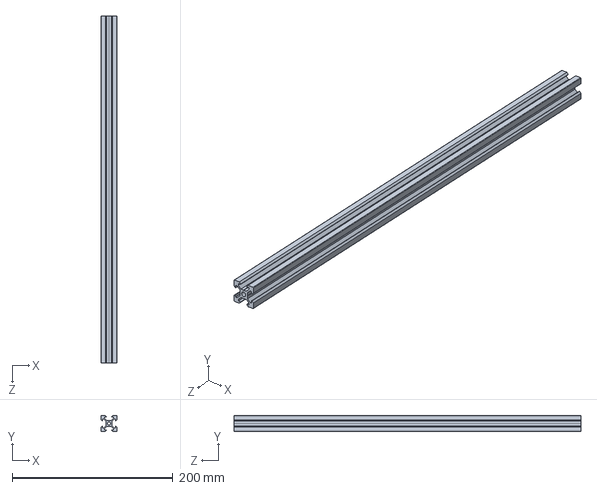
[picture p59: CAD file, 2016-05-18]
CAD/solidworks/Y-005.SLDPRT
20.0 x 20.0 x 431.8 mm
