a-drizzle/Printer1/production_parts/printed_parts/PX-006.STL

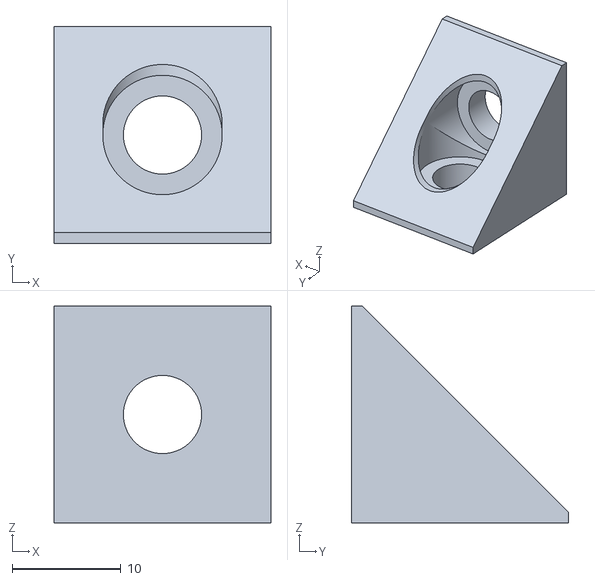
[picture p60: CAD file, 2016-05-18]
production_parts/printed_parts/PX-006.STL
20.0 x 20.0 x 20.0
