a-drizzle/Printer1/CAD/solidworks/hardware/H-008.SLDPRT

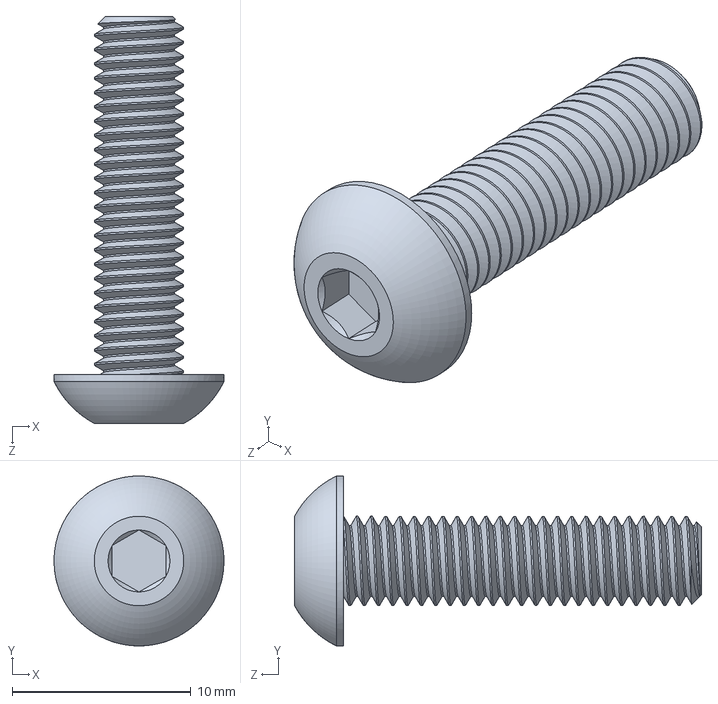
[picture p61: CAD file, 2016-05-18]
CAD/solidworks/hardware/H-008.SLDPRT
9.50 x 9.50 x 22.8 mm
