a-drizzle/Printer1/CAD/solidworks/PX-002_rB.SLDPRT

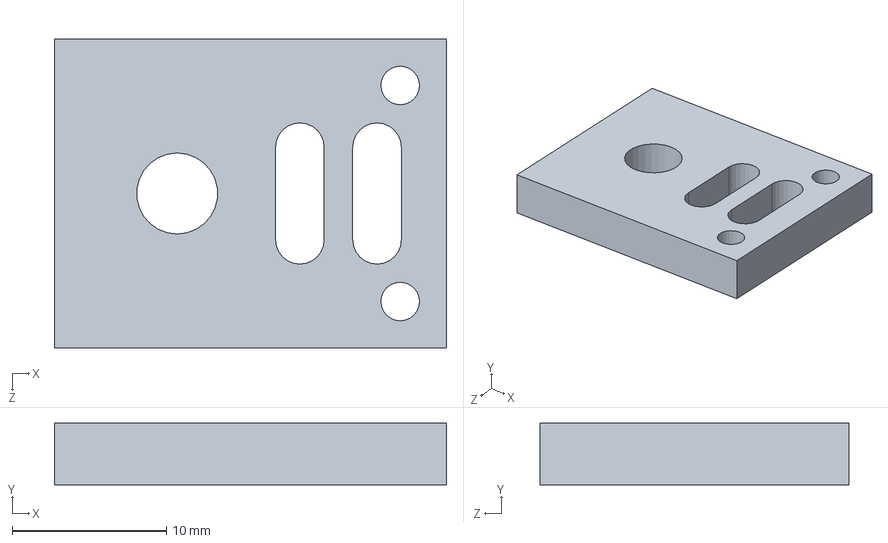
[picture p62: CAD file, 2016-05-18]
CAD/solidworks/PX-002_rB.SLDPRT
25.4 x 4.00 x 20.0 mm
