a-drizzle/Printer1/production_parts/printed_parts/PX-003.STL

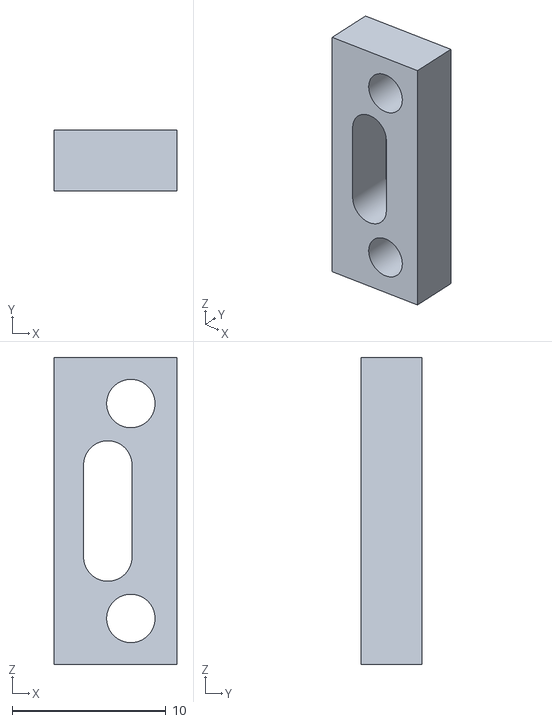
[picture p63: CAD file, 2016-05-18]
production_parts/printed_parts/PX-003.STL
8.00 x 4.00 x 20.0
