a-drizzle/Printer1/CAD/solidworks/hardware/H-021.SLDPRT

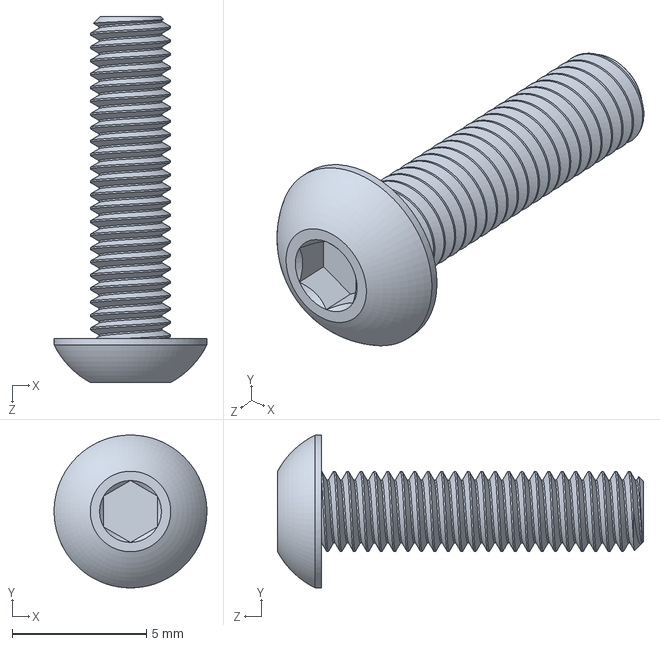
[picture p64: CAD file, 2016-05-18]
CAD/solidworks/hardware/H-021.SLDPRT
5.70 x 5.70 x 13.6 mm
