a-drizzle/Printer1/production_parts/solidworks/M-005.SLDPRT

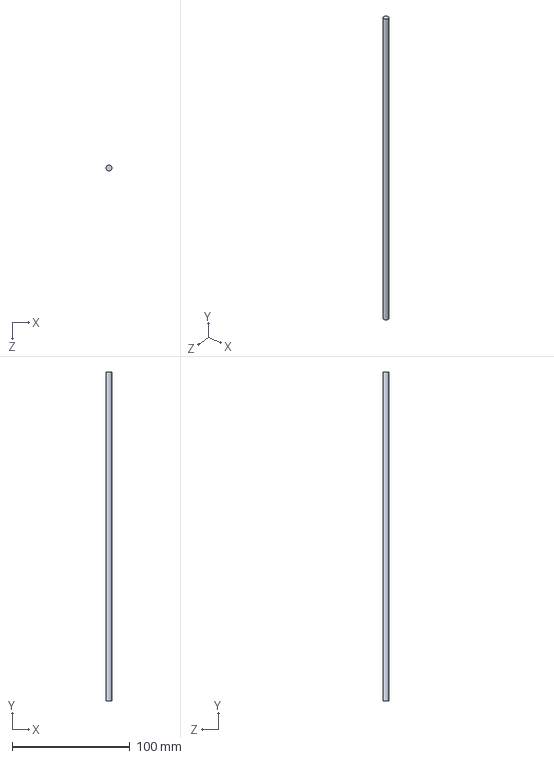
[picture p65: CAD file, 2016-05-18]
production_parts/solidworks/M-005.SLDPRT
5.00 x 279.4 x 5.00 mm
