a-drizzle/Printer1/CAD/solidworks/hardware/H-010.SLDPRT

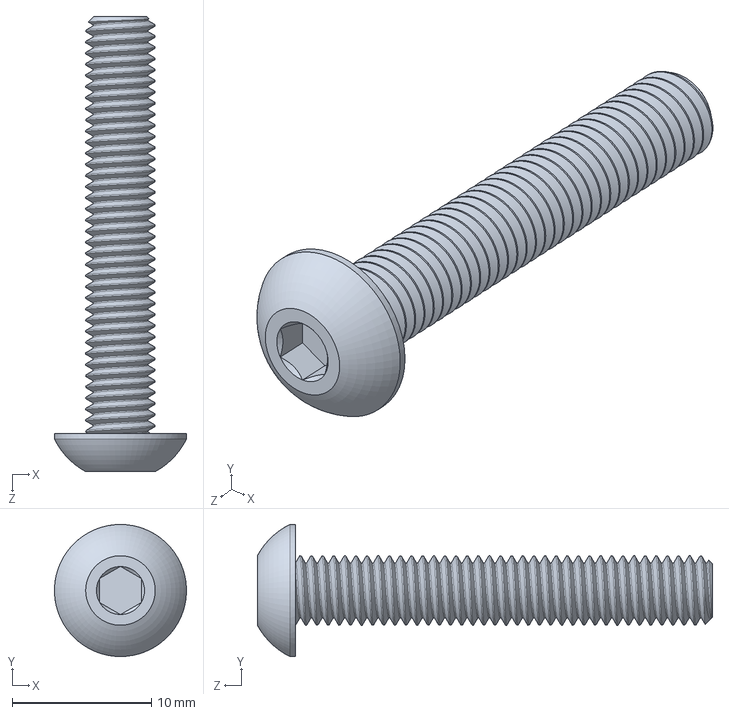
[picture p66: CAD file, 2016-05-18]
CAD/solidworks/hardware/H-010.SLDPRT
9.49 x 9.50 x 32.8 mm
