a-drizzle/Printer1/CAD/solidworks/hardware/H-014.SLDPRT

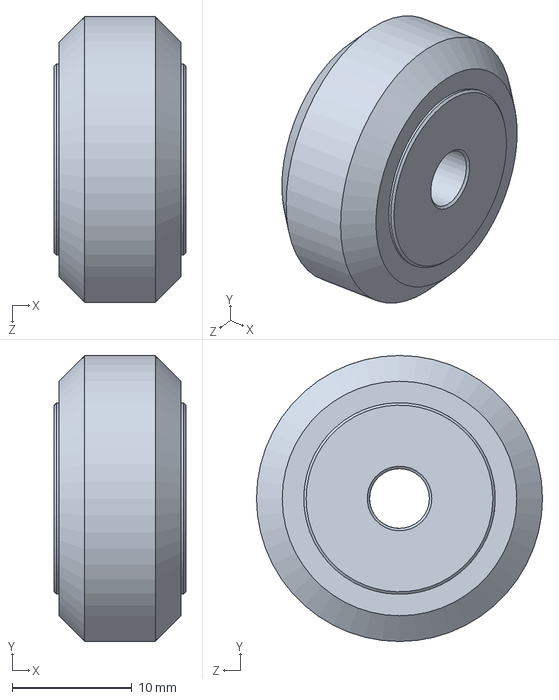
[picture p67: CAD file, 2016-05-18]
CAD/solidworks/hardware/H-014.SLDPRT
11.0 x 23.9 x 23.9 mm
