a-drizzle/Printer1/production_parts/printed_parts/PX-007.STL

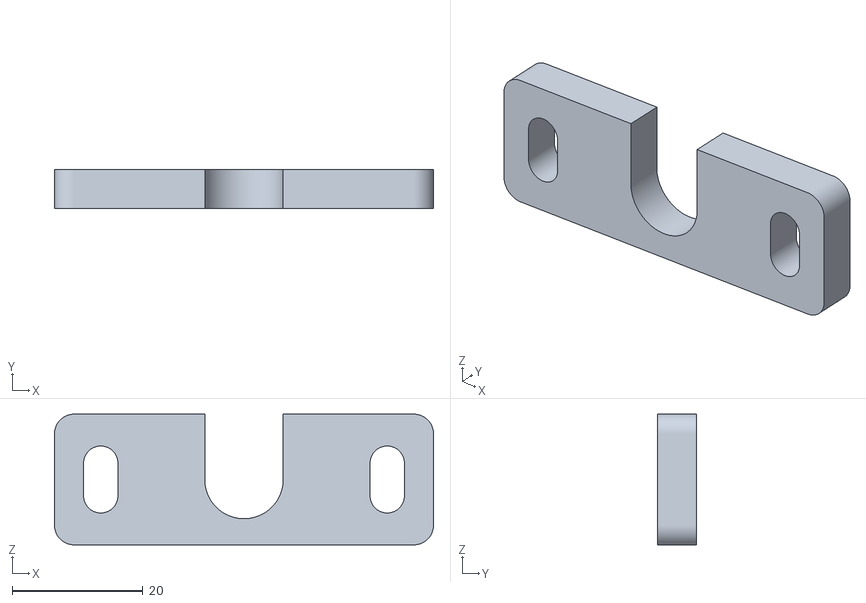
[picture p68: CAD file, 2016-05-18]
production_parts/printed_parts/PX-007.STL
58.0 x 6.00 x 20.0
