a-drizzle/Printer1/production_parts/solidworks/M-004.SLDPRT

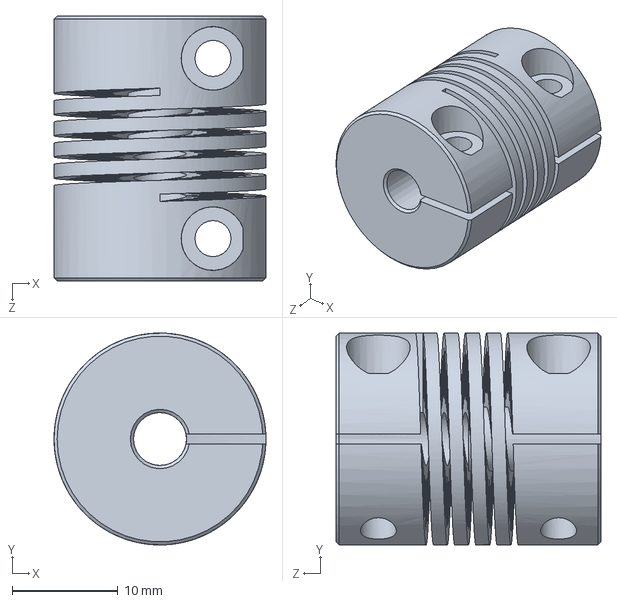
[picture p69: CAD file, 2016-05-18]
production_parts/solidworks/M-004.SLDPRT
20.0 x 20.0 x 25.0 mm
