a-drizzle/Printer1/CAD/solidworks/hardware/H-004.SLDPRT

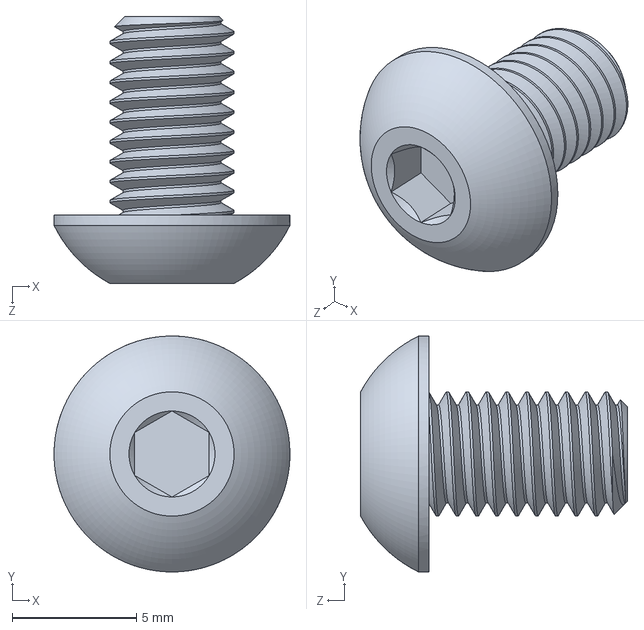
[picture p70: CAD file, 2016-05-18]
CAD/solidworks/hardware/H-004.SLDPRT
9.50 x 9.50 x 10.8 mm
