a-drizzle/Printer1/production_parts/printed_parts/PX-001_rB.STL

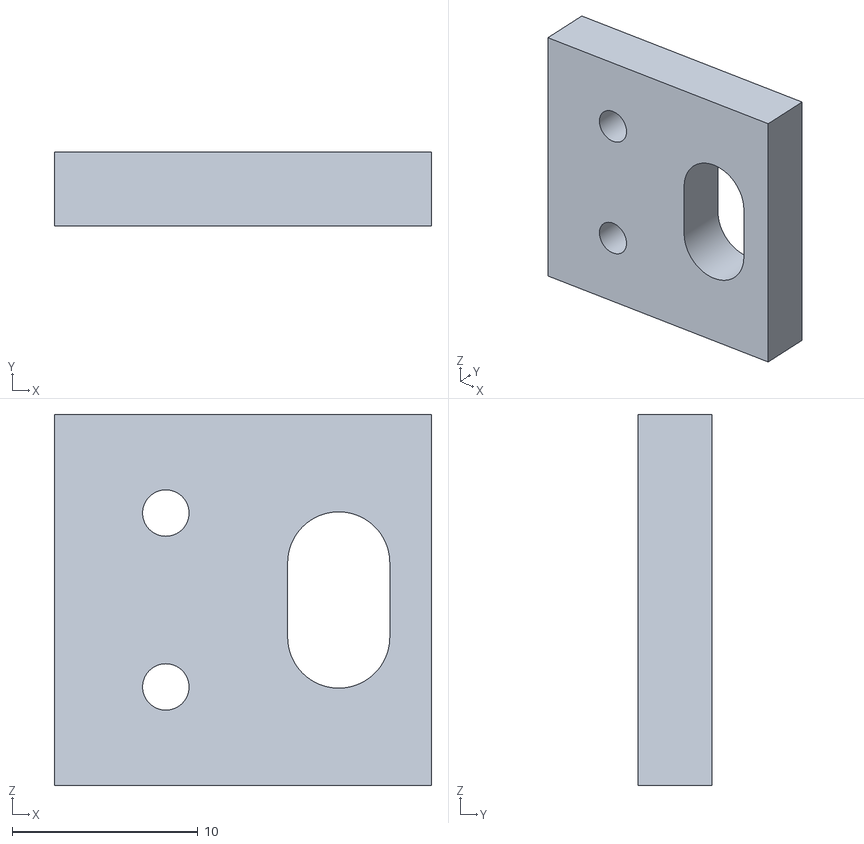
[picture p71: CAD file, 2016-05-12]
production_parts/printed_parts/PX-001_rB.STL
20.3 x 4.00 x 20.0
