a-drizzle/Printer1/production_parts/solidworks/Y-002.SLDPRT

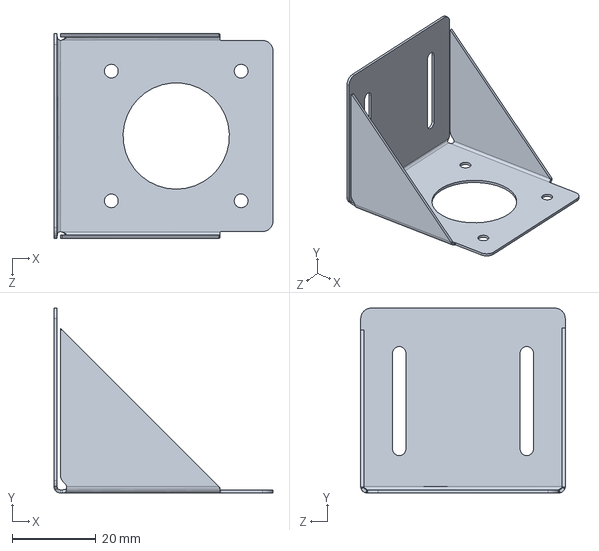
[picture p72: CAD file, 2016-05-18]
production_parts/solidworks/Y-002.SLDPRT
52.3 x 44.2 x 48.9 mm
