a-drizzle/Printer1/CAD/solidworks/hardware/H-002.SLDPRT

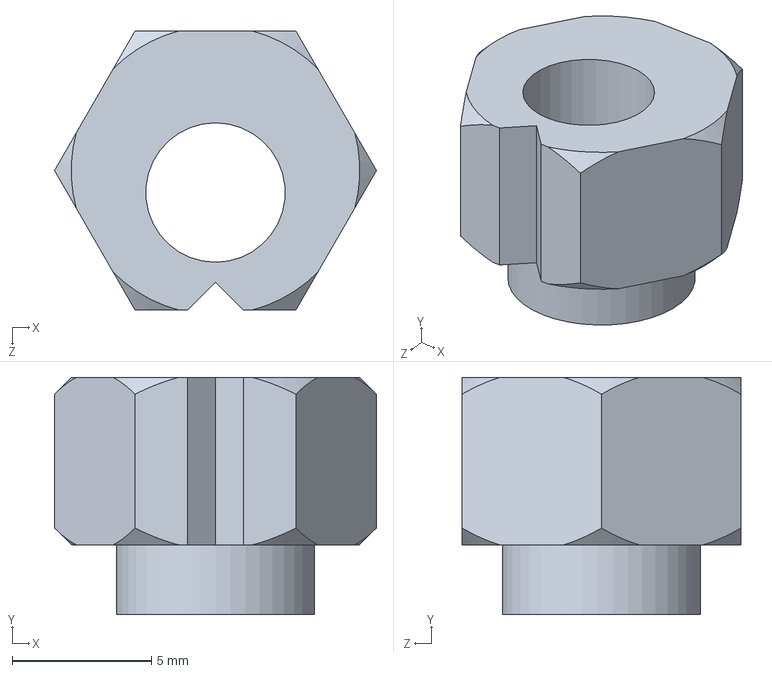
[picture p73: CAD file, 2016-05-18]
CAD/solidworks/hardware/H-002.SLDPRT
11.5 x 8.50 x 10.0 mm
