a-drizzle/Printer1/production_parts/printed_parts/PX-001.STL

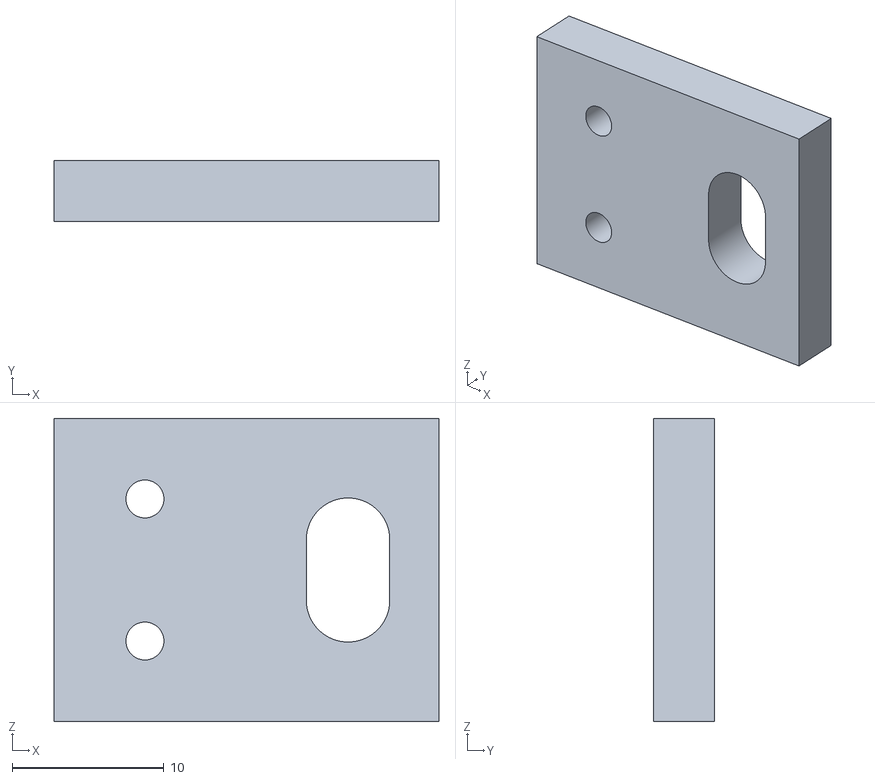
[picture p74: CAD file, 2016-05-06]
production_parts/printed_parts/PX-001.STL
25.4 x 4.00 x 20.0
