a-drizzle/Printer1/CAD/solidworks/hardware/H-007.SLDPRT

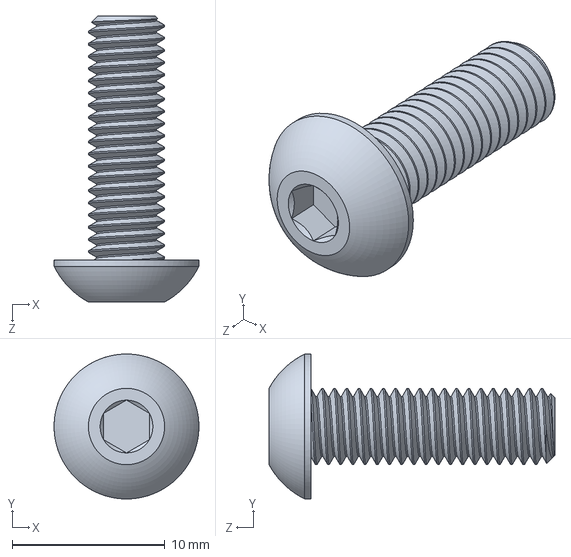
[picture p75: CAD file, 2016-05-18]
CAD/solidworks/hardware/H-007.SLDPRT
9.50 x 9.50 x 18.8 mm
