a-drizzle/Printer1/production_parts/printed_parts/PX-002.STL

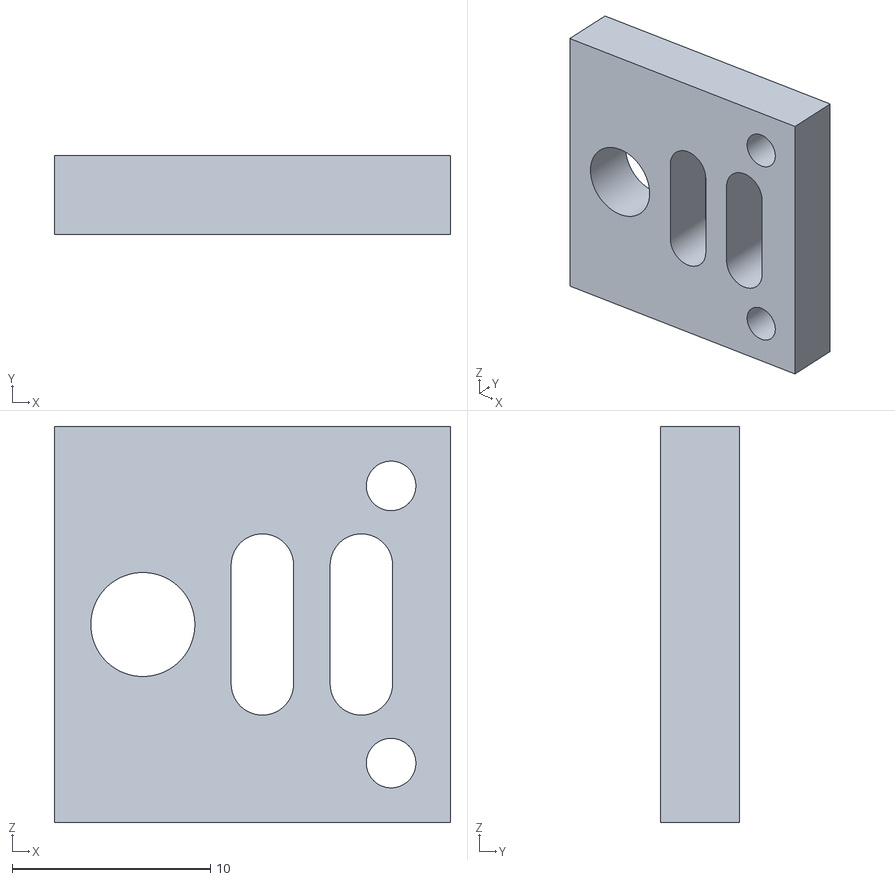
[picture p76: CAD file, 2016-05-06]
production_parts/printed_parts/PX-002.STL
20.0 x 4.00 x 20.0
