a-drizzle/Printer1/CAD/solidworks/hardware/H-020.SLDPRT

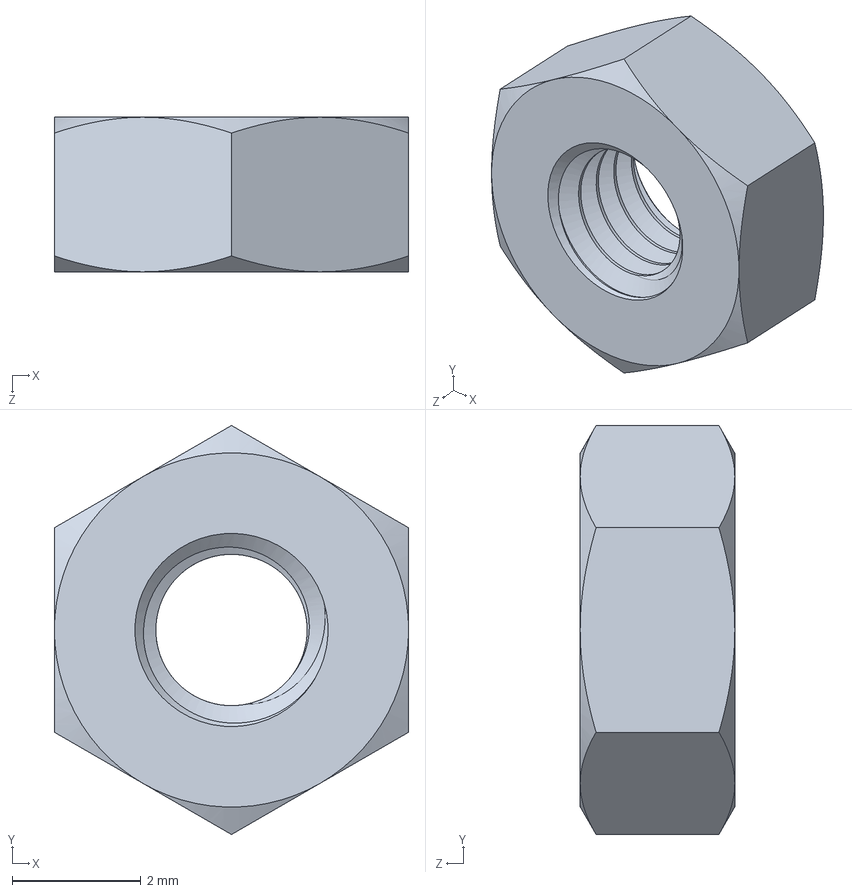
[picture p77: CAD file, 2016-05-18]
CAD/solidworks/hardware/H-020.SLDPRT
5.50 x 6.35 x 2.40 mm
