a-drizzle/Printer1/CAD/solidworks/X-003.SLDPRT

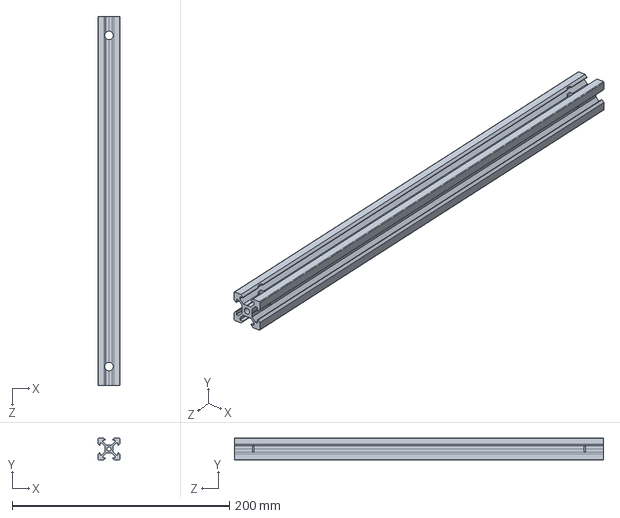
[picture p78: CAD file, 2016-05-18]
CAD/solidworks/X-003.SLDPRT
20.0 x 20.0 x 339.6 mm
