a-drizzle/Printer1/production_parts/solidworks/Y-004_rB.SLDPRT

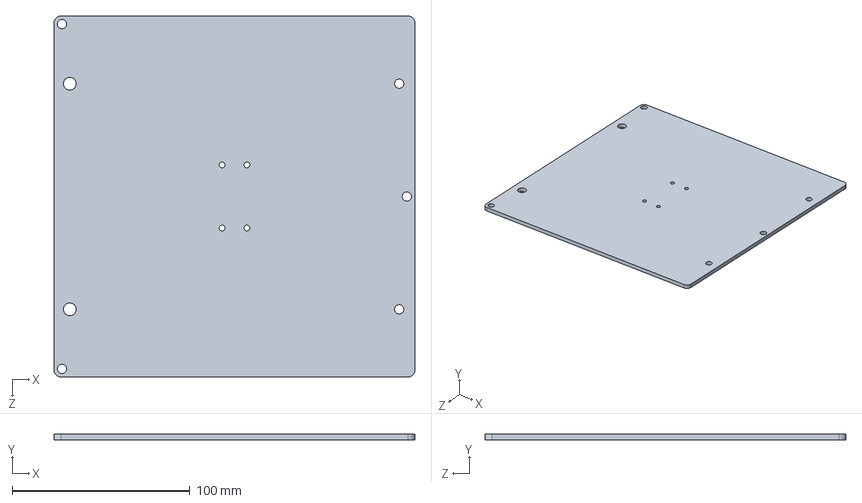
[picture p79: CAD file, 2016-05-18]
production_parts/solidworks/Y-004_rB.SLDPRT
203.2 x 3.17 x 203.2 mm
