a-drizzle/Printer1/CAD/solidworks/hardware/H-018.SLDPRT

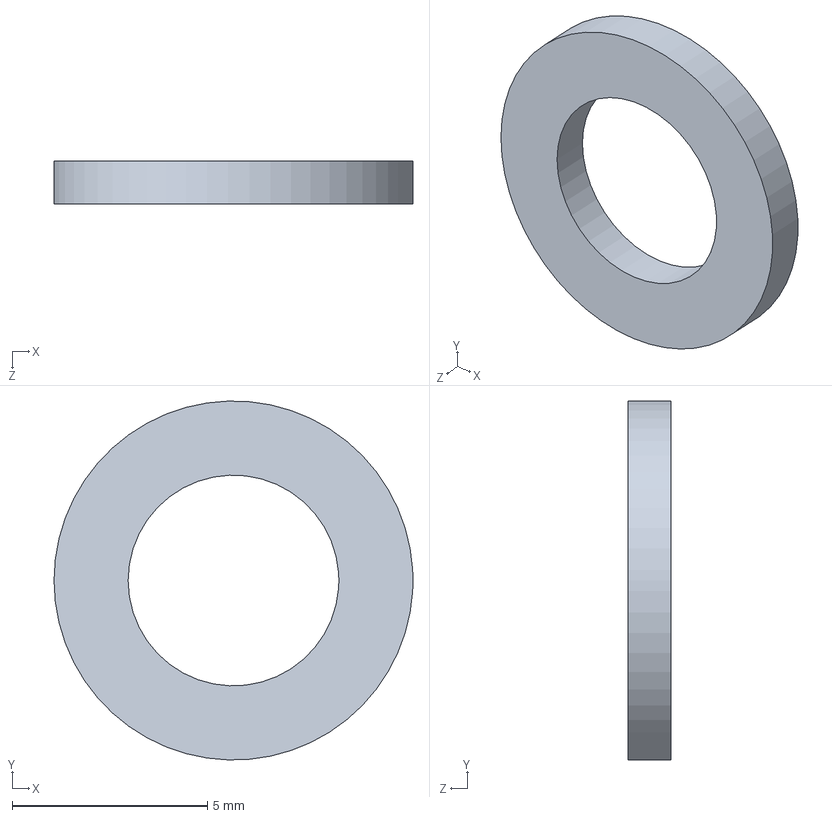
[picture p80: CAD file, 2016-05-18]
CAD/solidworks/hardware/H-018.SLDPRT
9.20 x 9.20 x 1.10 mm
