a-drizzle/Printer1/production_parts/solidworks/Y-006.SLDPRT

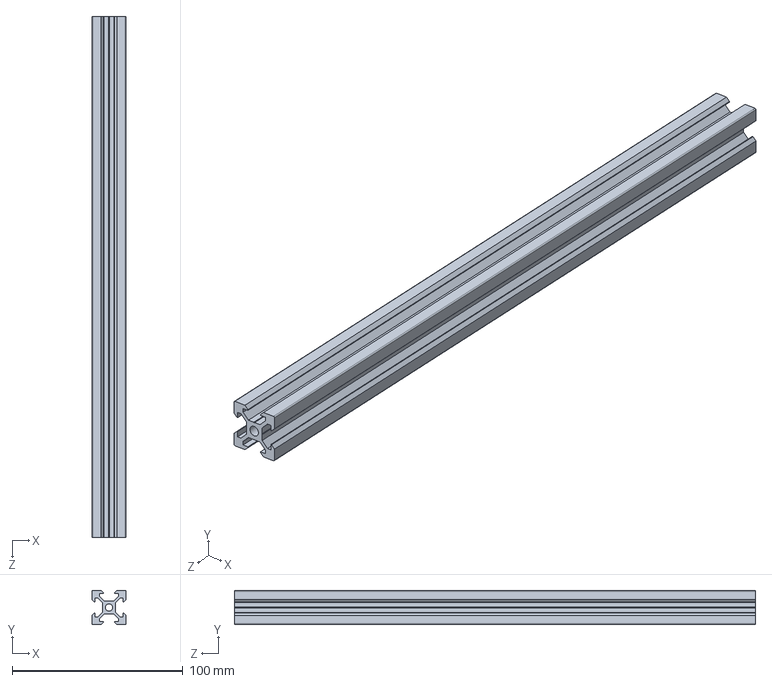
[picture p81: CAD file, 2016-05-18]
production_parts/solidworks/Y-006.SLDPRT
20.0 x 20.0 x 304.8 mm
