a-drizzle/Printer1/CAD/solidworks/hardware/H-015.SLDPRT

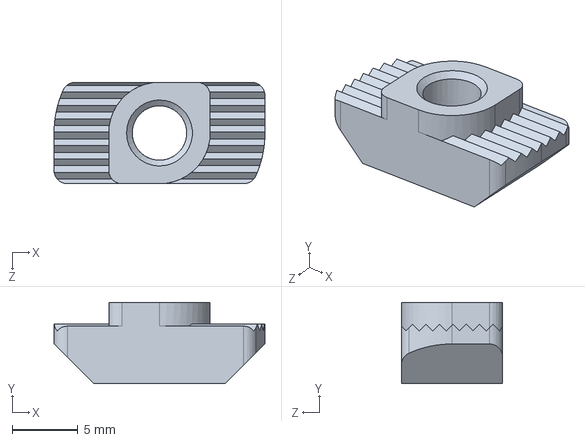
[picture p82: CAD file, 2016-05-18]
CAD/solidworks/hardware/H-015.SLDPRT
16.0 x 6.15 x 7.70 mm
