a-drizzle/Printer1/production_parts/solidworks/F-007_rB.SLDPRT

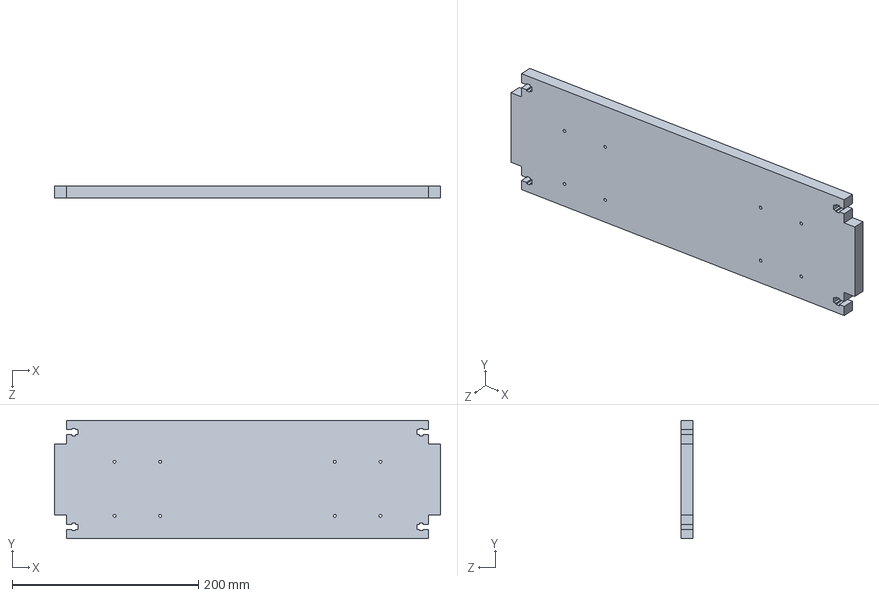
[picture p83: CAD file, 2016-05-12]
production_parts/solidworks/F-007_rB.SLDPRT
414.0 x 127.0 x 12.7 mm
