a-drizzle/Printer1/CAD/solidworks/hardware/H-005.SLDPRT

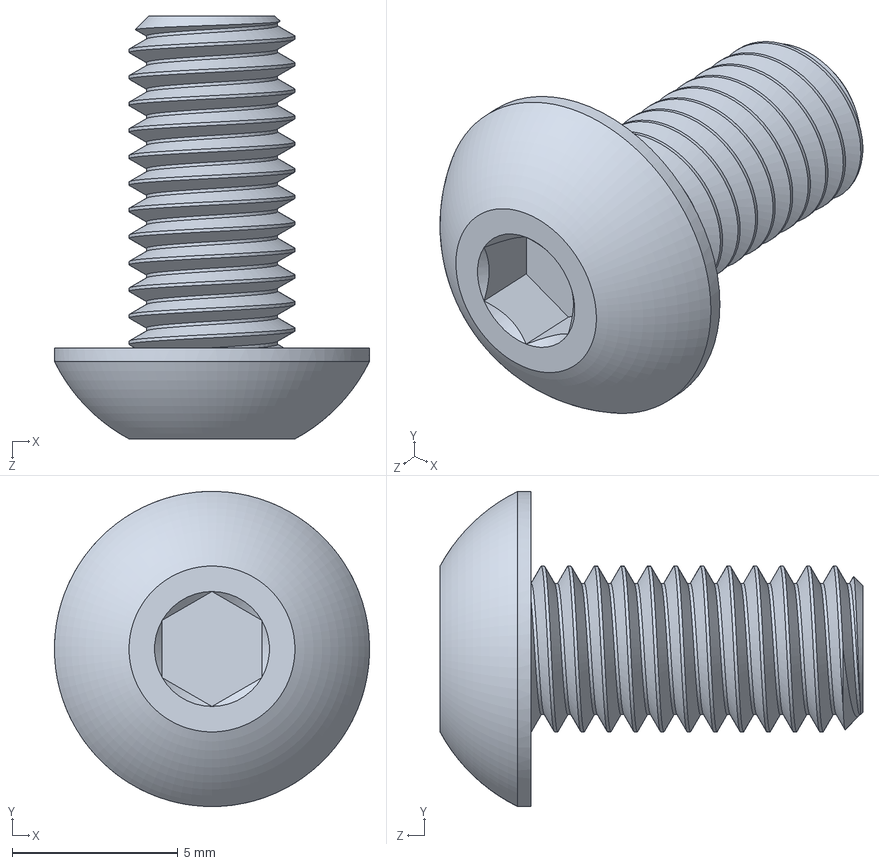
[picture p84: CAD file, 2016-05-18]
CAD/solidworks/hardware/H-005.SLDPRT
9.50 x 9.50 x 12.8 mm
