a-drizzle/Printer1/production_parts/solidworks/F-008.SLDPRT

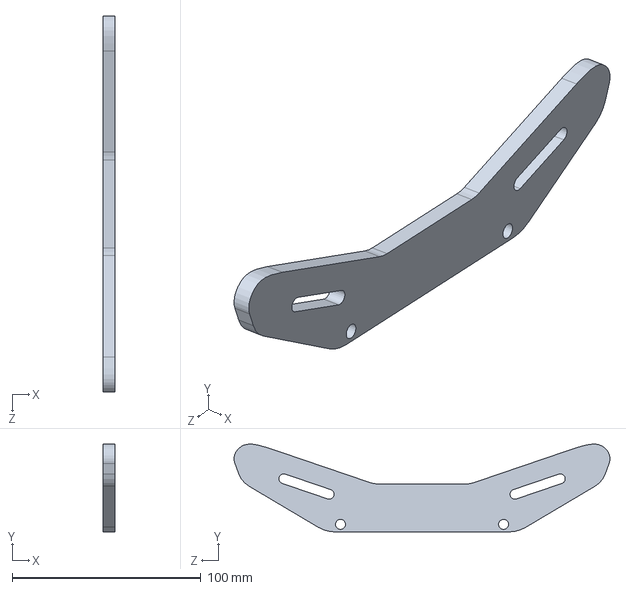
[picture p85: CAD file, 2016-05-12]
production_parts/solidworks/F-008.SLDPRT
6.35 x 46.5 x 199.1 mm
