a-drizzle/Printer1/CAD/solidworks/hardware/H-022.SLDPRT

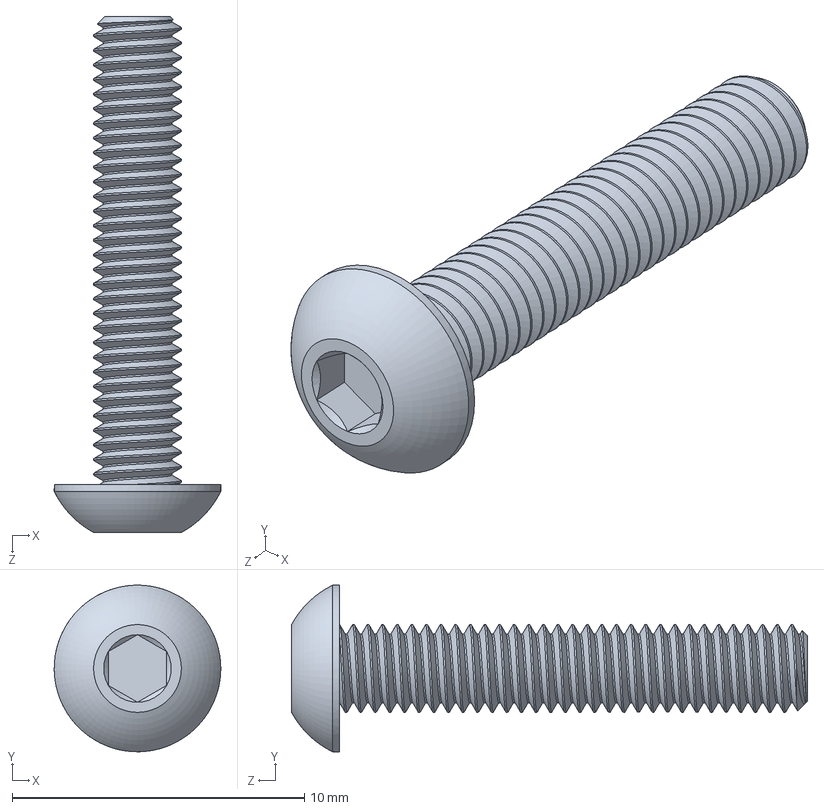
[picture p86: CAD file, 2016-05-18]
CAD/solidworks/hardware/H-022.SLDPRT
5.70 x 5.70 x 17.7 mm
