a-drizzle/Printer1/CAD/solidworks/hardware/H-013.SLDPRT

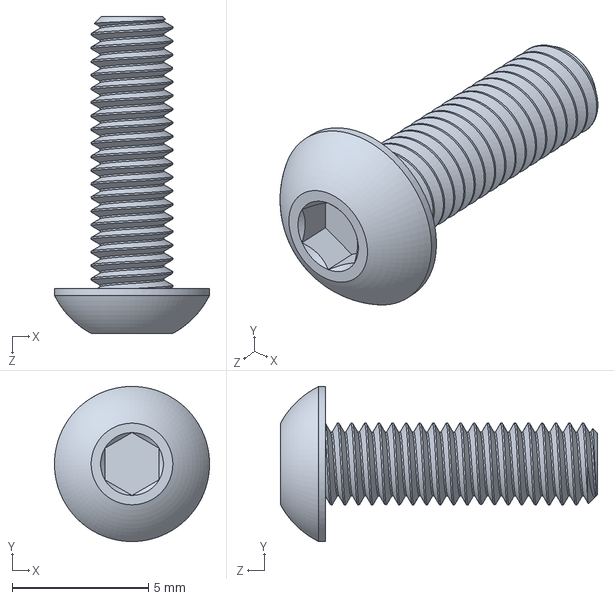
[picture p87: CAD file, 2016-05-18]
CAD/solidworks/hardware/H-013.SLDPRT
5.70 x 5.70 x 11.6 mm
