a-drizzle/Printer1/CAD/solidworks/hardware/H-030.SLDPRT

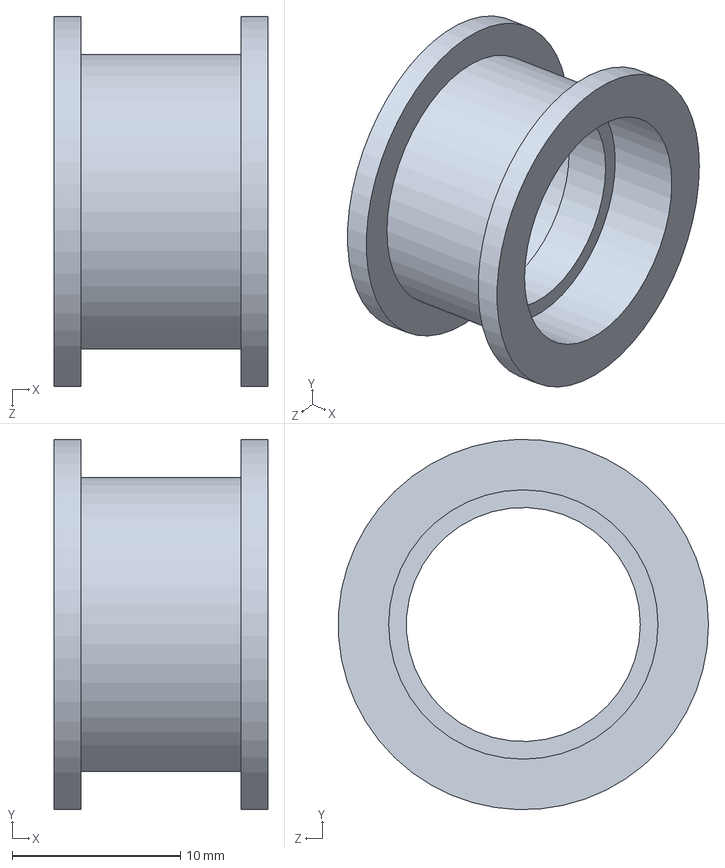
[picture p88: CAD file, 2016-05-18]
CAD/solidworks/hardware/H-030.SLDPRT
12.7 x 22.0 x 22.0 mm
