a-drizzle/Printer1/production_parts/solidworks/M-001.SLDPRT

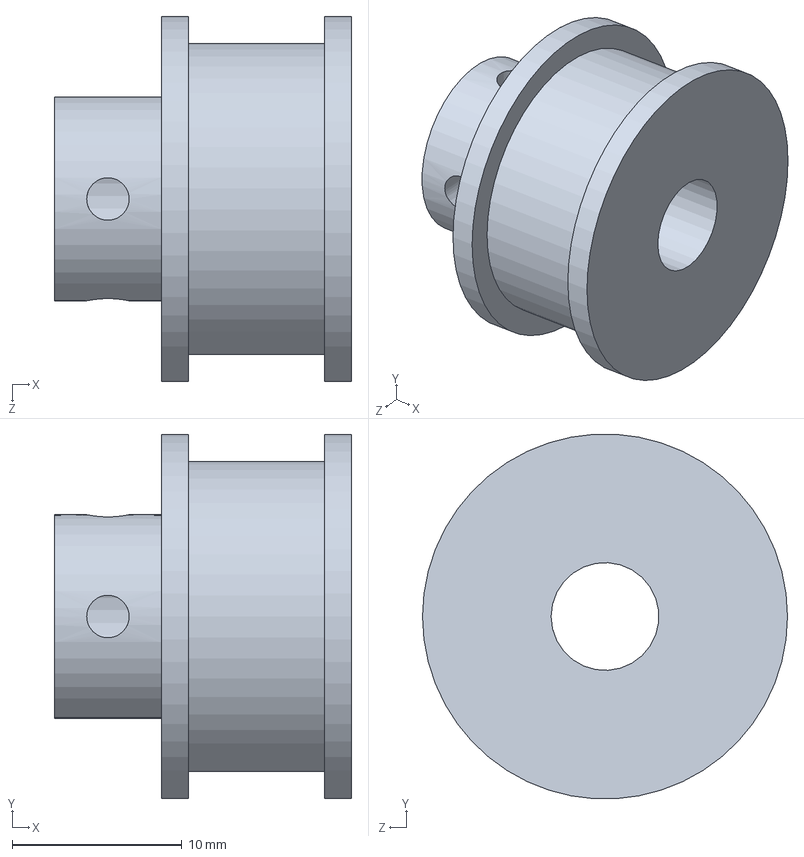
[picture p89: CAD file, 2016-05-12]
production_parts/solidworks/M-001.SLDPRT
17.5 x 21.5 x 21.5 mm
