a-drizzle/Printer1/CAD/solidworks/hardware/H-019.SLDPRT

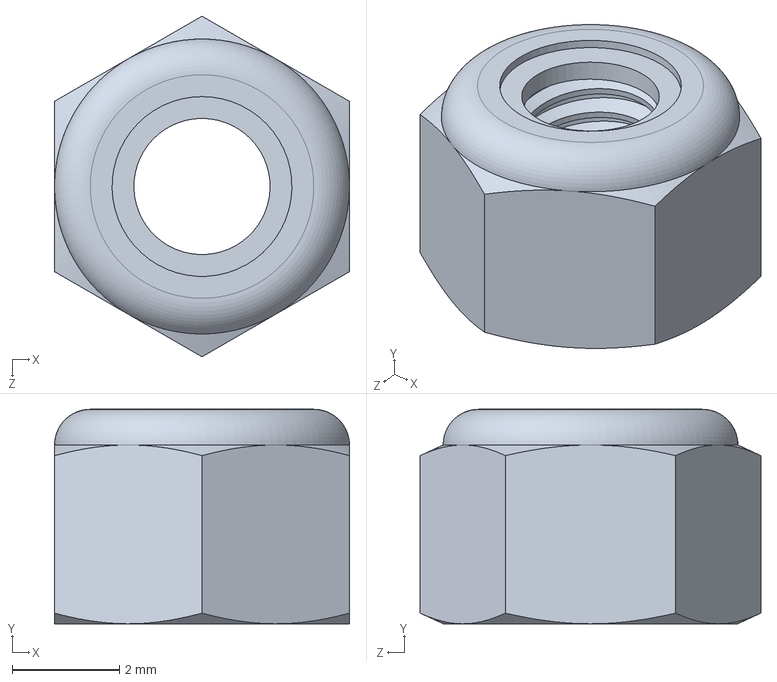
[picture p90: CAD file, 2016-05-18]
CAD/solidworks/hardware/H-019.SLDPRT
5.50 x 4.00 x 6.35 mm
