a-drizzle/Printer1/CAD/solidworks/hardware/H-025.SLDPRT

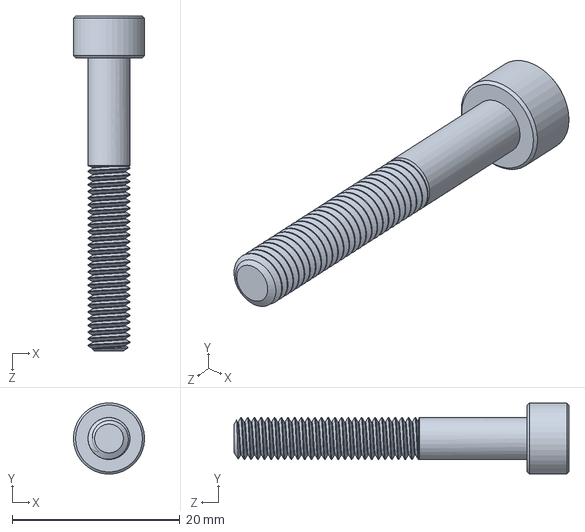
[picture p91: CAD file, 2016-05-18]
CAD/solidworks/hardware/H-025.SLDPRT
8.50 x 8.47 x 40.0 mm
