a-drizzle/Printer1/production_parts/solidworks/X-001.SLDPRT

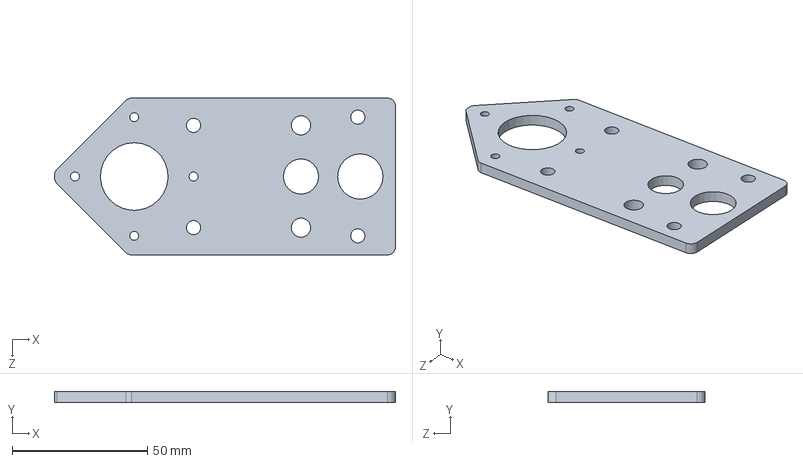
[picture p92: CAD file, 2016-05-12]
production_parts/solidworks/X-001.SLDPRT
126.0 x 4.06 x 58.0 mm
