a-drizzle/Printer1/CAD/solidworks/F-005_rB.SLDPRT

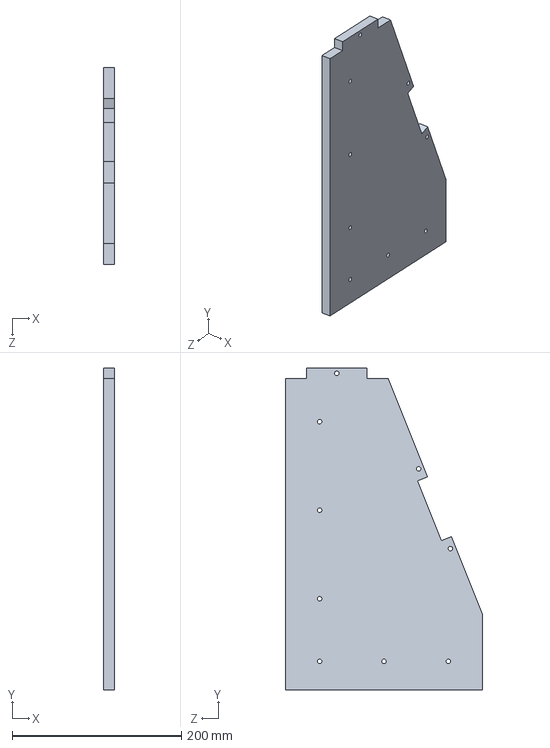
[picture p93: CAD file, 2016-05-12]
CAD/solidworks/F-005_rB.SLDPRT
12.7 x 381.0 x 233.7 mm
