a-drizzle/Printer1/CAD/solidworks/hardware/H-001.SLDPRT

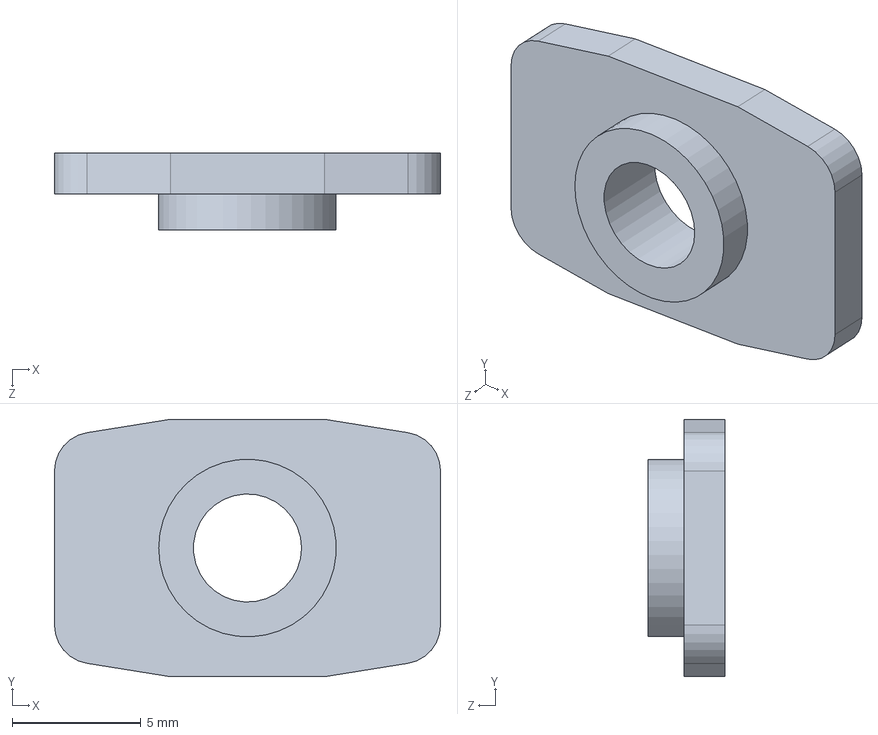
[picture p94: CAD file, 2016-05-12]
CAD/solidworks/hardware/H-001.SLDPRT
15.0 x 10.0 x 3.00 mm
