a-drizzle/Printer1/production_parts/solidworks/X-002_rB.SLDPRT

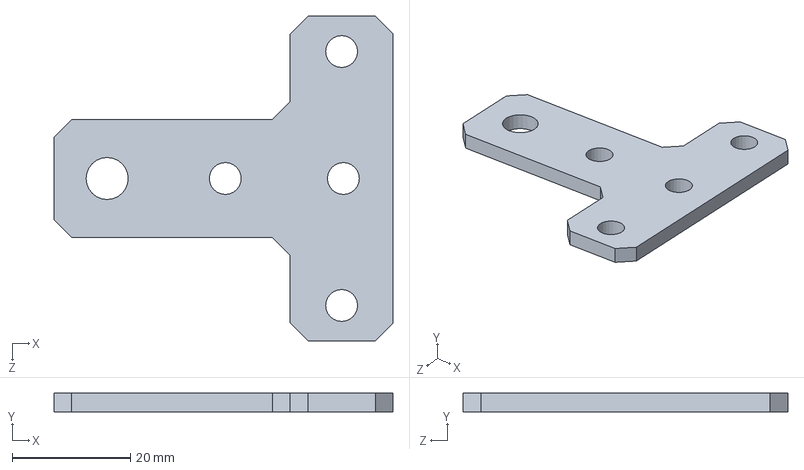
[picture p95: CAD file, 2016-05-12]
production_parts/solidworks/X-002_rB.SLDPRT
57.4 x 3.17 x 55.0 mm
