a-drizzle/Printer1/CAD/solidworks/F-004.SLDPRT

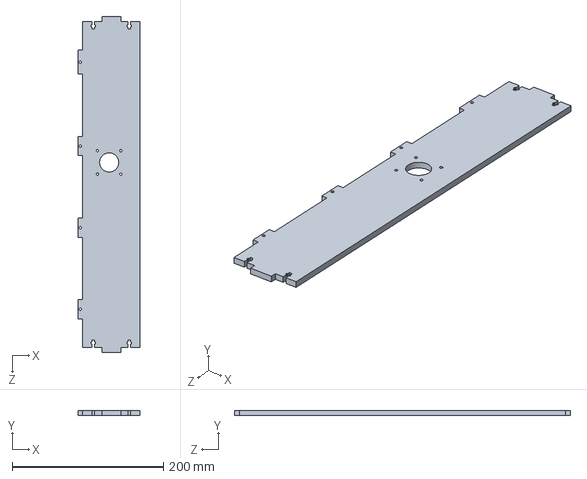
[picture p96: CAD file, 2016-05-12]
CAD/solidworks/F-004.SLDPRT
82.6 x 6.35 x 444.5 mm
