a-drizzle/Printer1/CAD/solidworks/hardware/H-012.SLDPRT

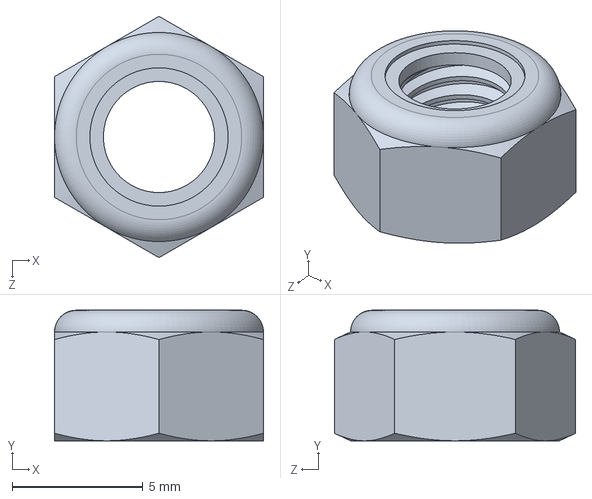
[picture p97: CAD file, 2016-05-12]
CAD/solidworks/hardware/H-012.SLDPRT
8.00 x 5.00 x 9.24 mm
