a-drizzle/Printer1/CAD/solidworks/F-003_rB.SLDPRT

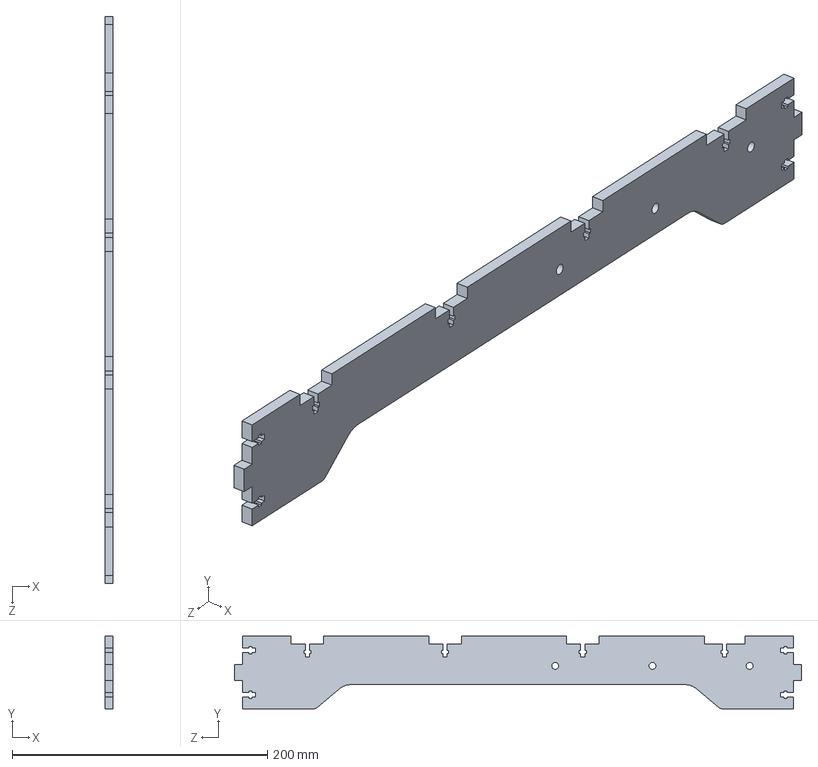
[picture p98: CAD file, 2016-05-12]
CAD/solidworks/F-003_rB.SLDPRT
6.35 x 57.1 x 444.5 mm
