a-drizzle/Printer1/CAD/solidworks/hardware/H-011.SLDPRT

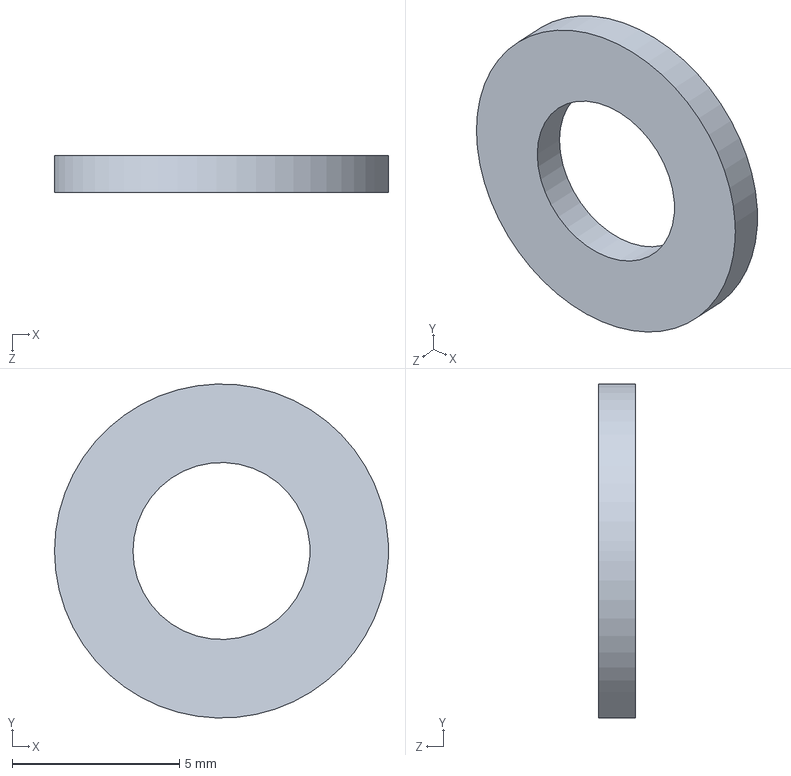
[picture p99: CAD file, 2016-05-12]
CAD/solidworks/hardware/H-011.SLDPRT
10.0 x 10.00 x 1.10 mm
