a-drizzle/Printer1/production_parts/solidworks/X-002.SLDPRT

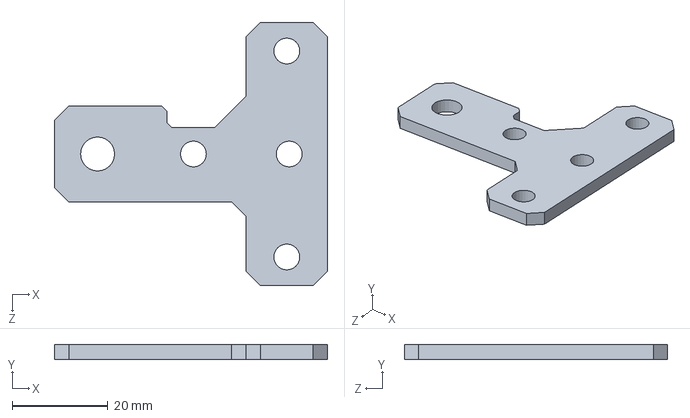
[picture p100: CAD file, 2016-05-12]
production_parts/solidworks/X-002.SLDPRT
57.0 x 3.17 x 55.0 mm
