a-drizzle/Printer1/CAD/solidworks/hardware/H-016.SLDPRT

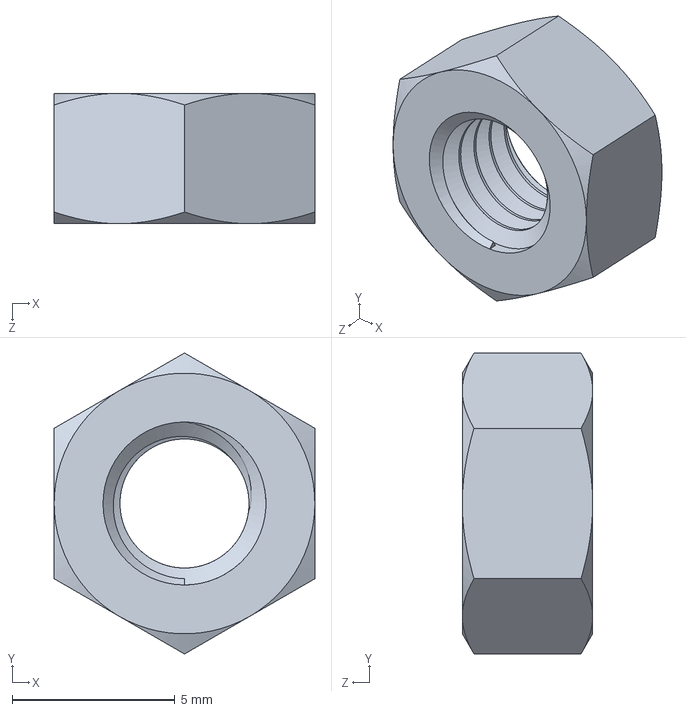
[picture p101: CAD file, 2016-05-12]
CAD/solidworks/hardware/H-016.SLDPRT
8.00 x 9.24 x 4.00 mm
