a-drizzle/Printer1/CAD/solidworks/hardware/H-003.SLDPRT

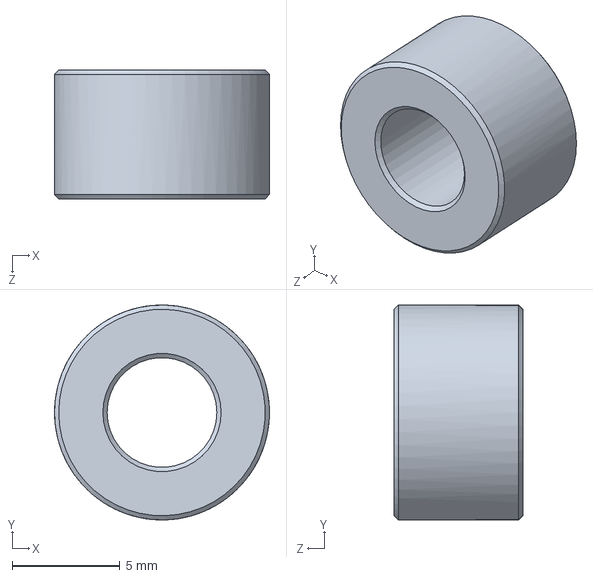
[picture p102: CAD file, 2016-05-12]
CAD/solidworks/hardware/H-003.SLDPRT
10.0 x 10.00 x 6.00 mm
