a-drizzle/Printer1/production_parts/solidworks/F-006_rB.SLDPRT

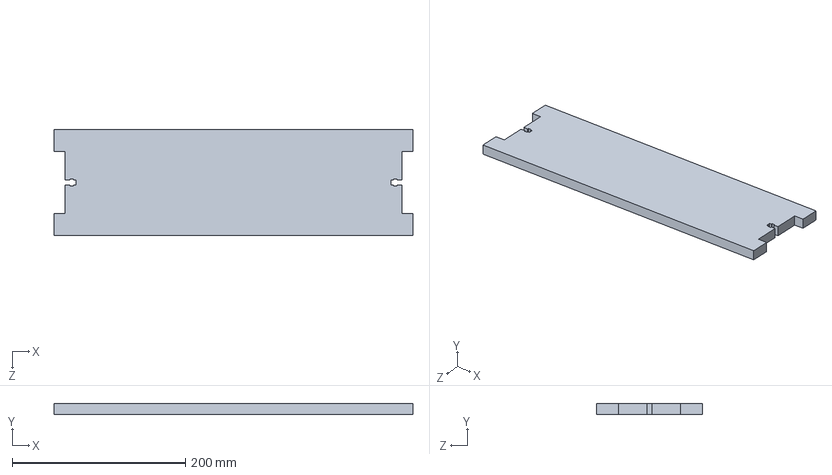
[picture p103: CAD file, 2016-05-12]
production_parts/solidworks/F-006_rB.SLDPRT
414.0 x 12.7 x 121.9 mm
