a-drizzle/Printer1/production_parts/solidworks/F-001.SLDPRT

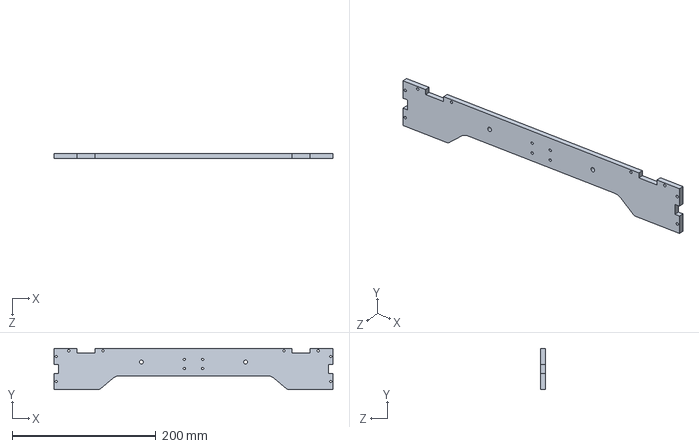
[picture p104: CAD file, 2016-05-12]
production_parts/solidworks/F-001.SLDPRT
388.6 x 57.1 x 6.35 mm
