a-drizzle/Printer1/CAD/solidworks/Y-004.SLDPRT

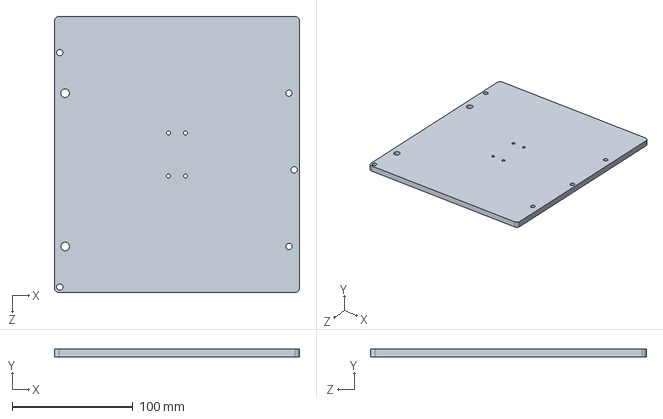
[picture p105: CAD file, 2016-05-06]
CAD/solidworks/Y-004.SLDPRT
203.2 x 6.35 x 228.6 mm
