a-drizzle/Printer1/CAD/solidworks/Y-003.SLDPRT

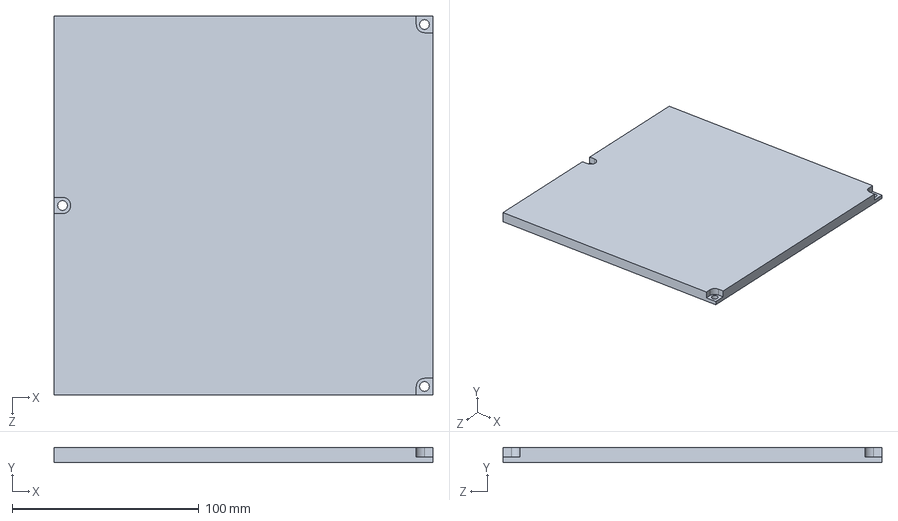
[picture p106: CAD file, 2016-05-06]
CAD/solidworks/Y-003.SLDPRT
203.2 x 7.94 x 203.2 mm
