a-drizzle/Printer1/(list of files, cad)

Other CAD files:
CAD/solidworks/electronics/E-001.SLDPRT
production_parts/solidworks/PX-009.SLDPRT
production_parts/printed_parts/PX-002_rB.STL
CAD/solidworks/PX-006.SLDPRT
production_parts/printed_parts/PX-004.STL
production_parts/solidworks/PX-008.SLDPRT
CAD/solidworks/PX-009.SLDPRT
CAD/solidworks/Y-001.SLDPRT
CAD/solidworks/M-004.SLDPRT
production_parts/solidworks/PX-007.SLDPRT
CAD/solidworks/PX-007.SLDPRT
CAD/solidworks/PX-005.SLDPRT
CAD/solidworks/PX-003.SLDPRT
CAD/solidworks/PX-008.SLDPRT
production_parts/solidworks/PX-006.SLDPRT
CAD/solidworks/Y-004_rB.SLDPRT
production_parts/solidworks/PX-002_rB.SLDPRT
CAD/solidworks/M-005.SLDPRT
production_parts/solidworks/PX-005.SLDPRT
CAD/solidworks/Y-002.SLDPRT
production_parts/solidworks/PX-003.SLDPRT
production_parts/solidworks/PX-001_rB.SLDPRT
CAD/solidworks/PX-001_rB.SLDPRT
production_parts/solidworks/PX-004.SLDPRT
CAD/solidworks/M-003.SLDPRT
CAD/solidworks/PX-002.SLDPRT
production_parts/solidworks/PX-002.SLDPRT
CAD/solidworks/PX-001.SLDPRT
CAD/solidworks/F-100.SLDDRW
CAD/solidworks/X-100.SLDDRW
