a-drizzle/Printer1/media/pictures/building/20160420_125756.jpg

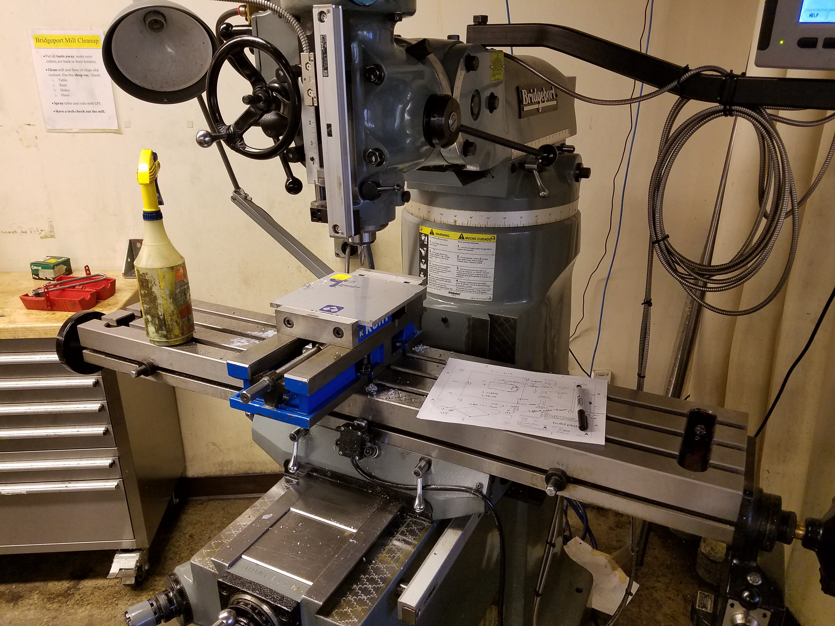
media/pictures/building/20160420_125756.jpg
