a-drizzle/Printer1/media/pictures/building/20160420_191403.jpg

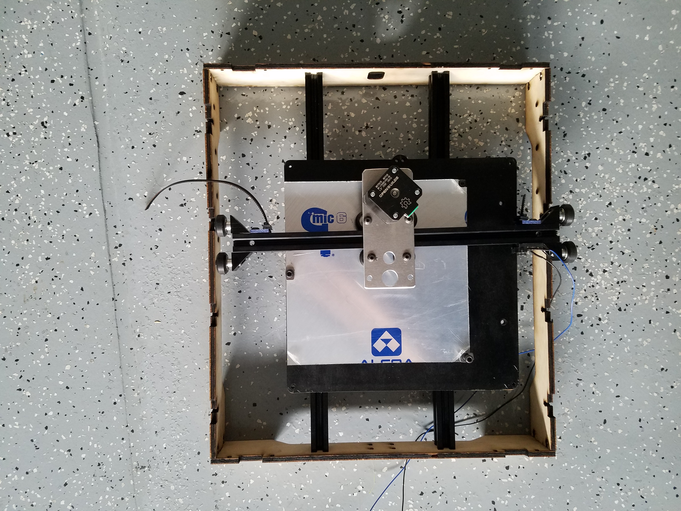
media/pictures/building/20160420_191403.jpg
