a-drizzle/Printer1/media/pictures/building/20160507_175931.jpg

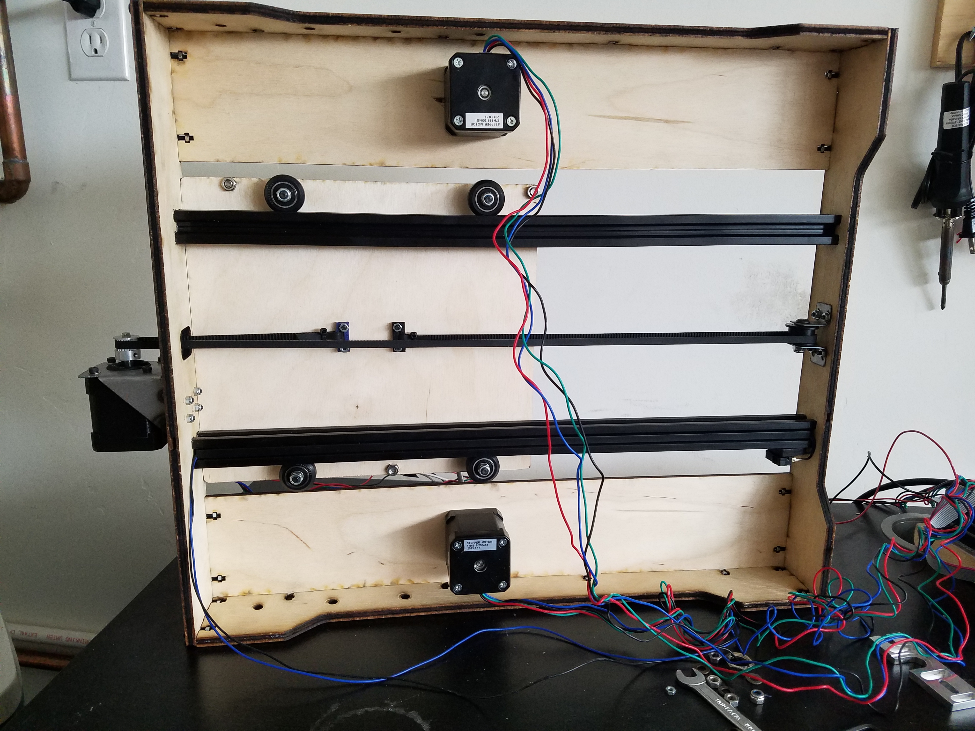
media/pictures/building/20160507_175931.jpg
