a-drizzle/Printer1/media/pictures/building/20160507_175943.jpg

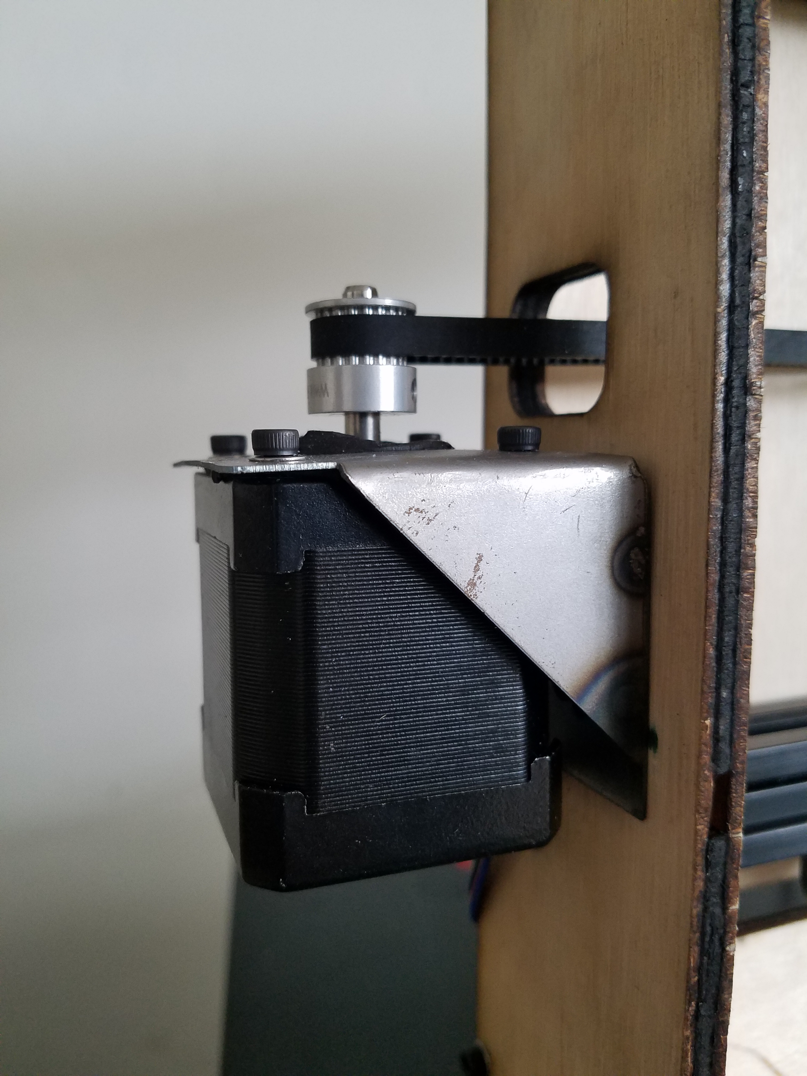
media/pictures/building/20160507_175943.jpg
