a-drizzle/Printer1/media/pictures/building/20160507_180002.jpg

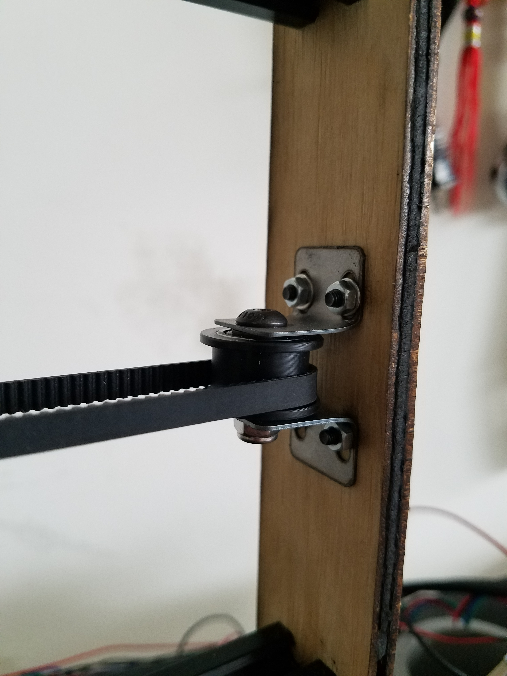
media/pictures/building/20160507_180002.jpg
