a-drizzle/Printer1/media/pictures/building/20160507_180004.jpg

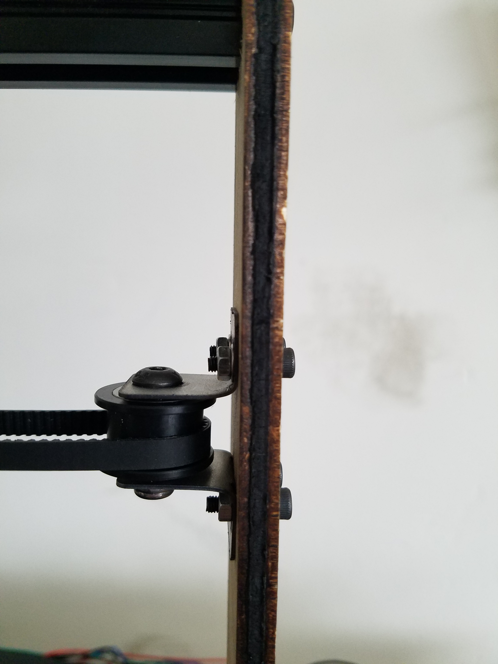
media/pictures/building/20160507_180004.jpg
