a-drizzle/Printer1/media/pictures/building/20160507_180016.jpg

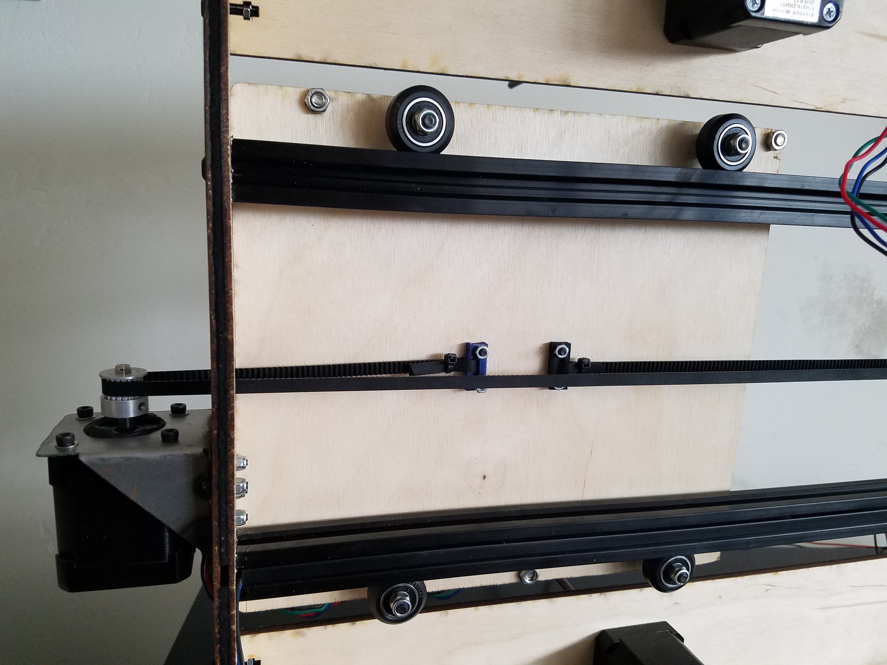
media/pictures/building/20160507_180016.jpg
