a-drizzle/Printer1/media/pictures/building/20160507_185223.jpg

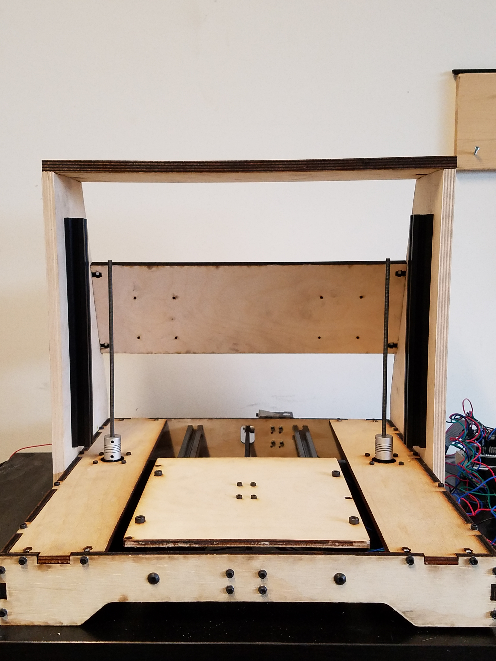
media/pictures/building/20160507_185223.jpg
