a-drizzle/Printer1/media/pictures/building/20160513_124229.jpg

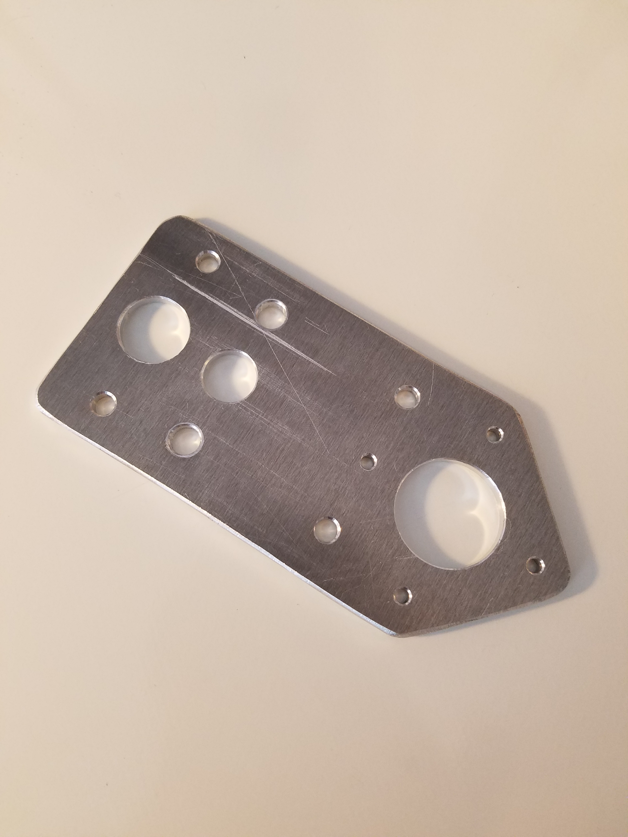
media/pictures/building/20160513_124229.jpg
