a-drizzle/Printer1/media/pictures/test prints/20160508_143635.jpg

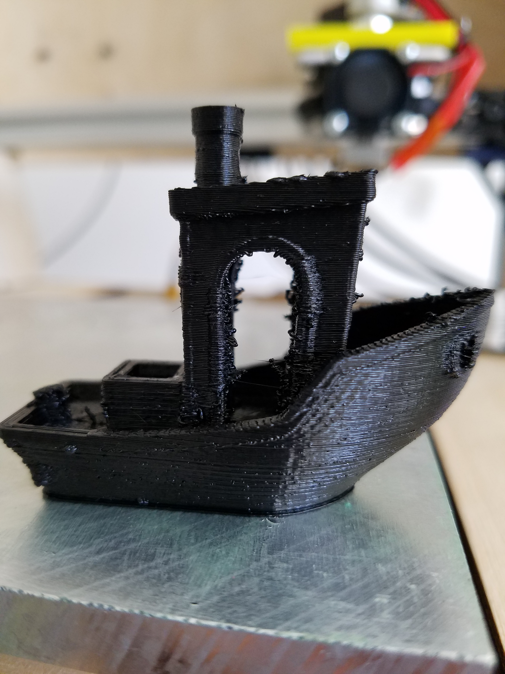
media/pictures/test prints/20160508_143635.jpg
