a-drizzle/Printer1/media/pictures/test prints/20160510_224738.jpg

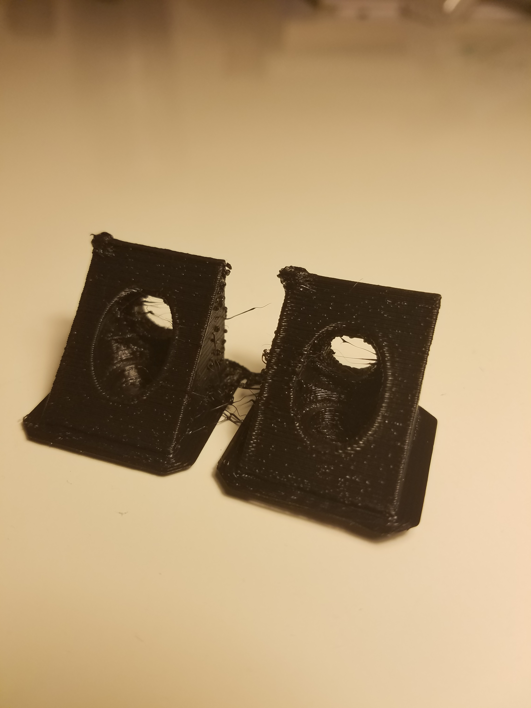
media/pictures/test prints/20160510_224738.jpg
