a-drizzle/Printer1/production_parts/laser_cut_parts/F-002.pdf

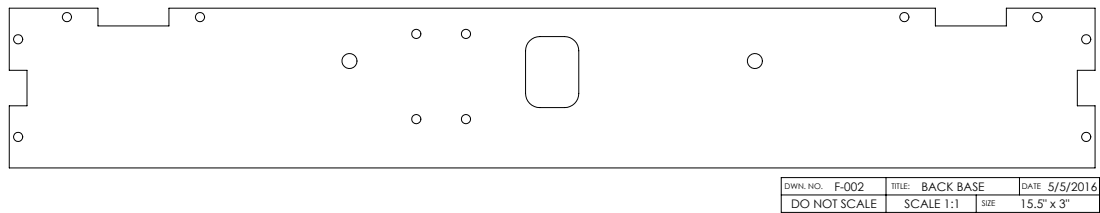
[picture p126: page 1]

DWN. NO. F-002 | TITLE: BACK BASE | 5/5/2016 DATE
DO NOT SCALE | SCALE 1:1 | 15.5" x 3" SIZE
