a-drizzle/Printer1/production_parts/laser_cut_parts/F-003.pdf

DWN. NO. F-003_rB | TITLE: SIDES BASE | 5/15/2016 DATE
DO NOT SCALE | SCALE 1:1 | 17.7" x 3" SIZE
