a-drizzle/Printer1/production_parts/laser_cut_parts/F-005.pdf

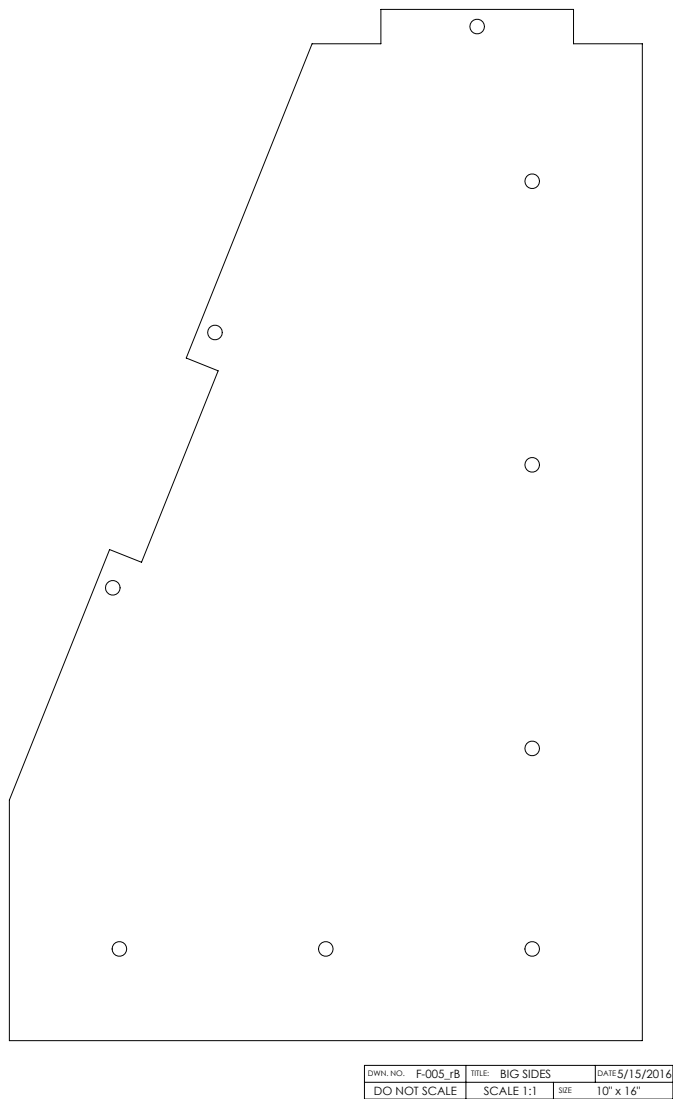
[picture p127: page 1]
DATE; SIZE; DWN. NO. F-005_rB; TITLE: BIG SIDES; DO NOT SCALE; SCALE 1:1
