a-drizzle/Printer1/production_parts/laser_cut_parts/F-007.pdf

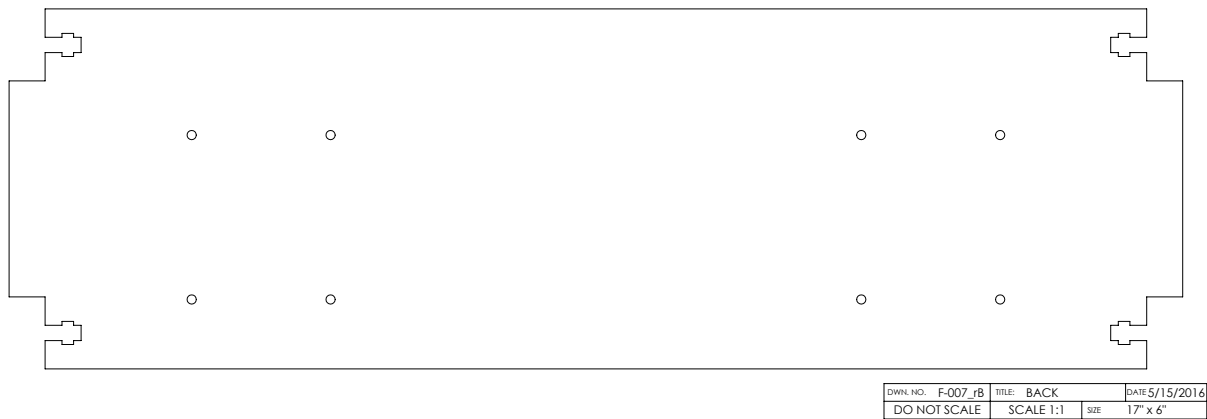
[picture p128: page 1]

DWN. NO. F-007_rB | TITLE: BACK | 5/15/2016 DATE
DO NOT SCALE | SCALE 1:1 | 17" x 6" SIZE
