a-drizzle/Printer1/production_parts/laser_cut_parts/full_sheets/2x_F-004.pdf

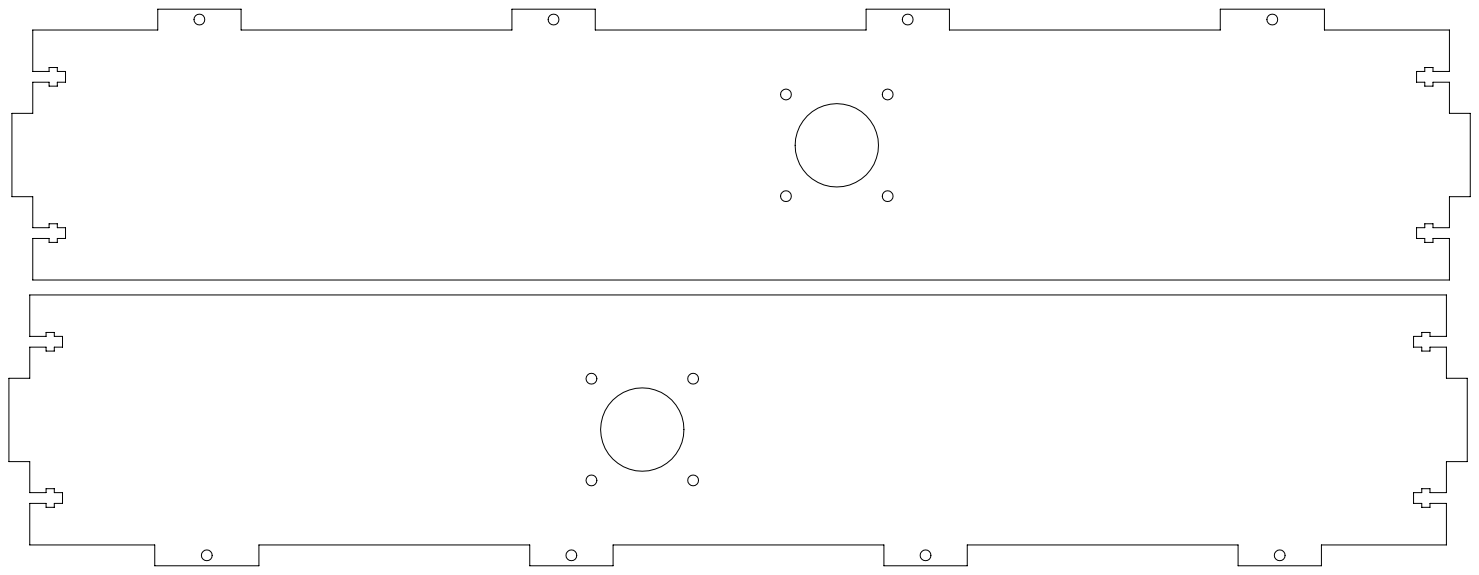
[picture p129: page 1]
