a-drizzle/Printer1/production_parts/laser_cut_parts/full_sheets/2x_F-005.pdf

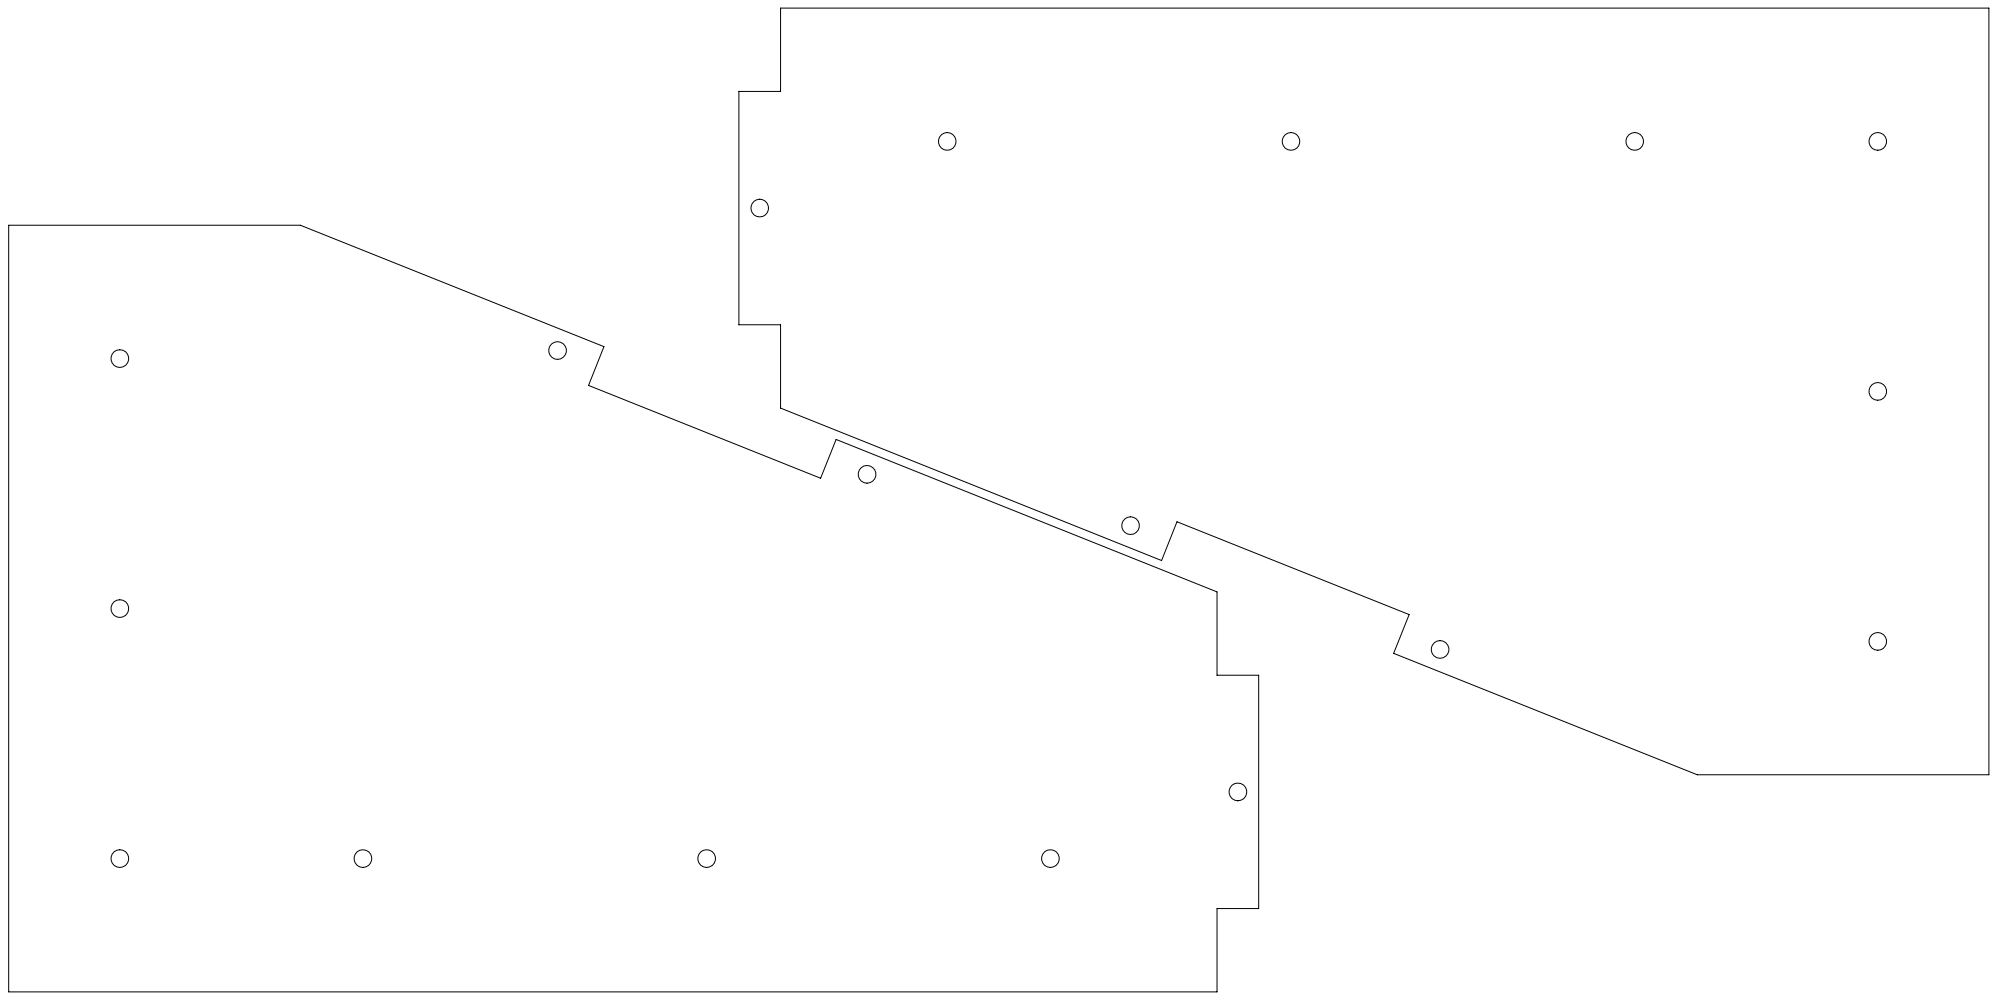
[picture p130: page 1]
