a-drizzle/Printer1/production_parts/laser_cut_parts/full_sheets/F-001_F-002_2x_F-003.pdf

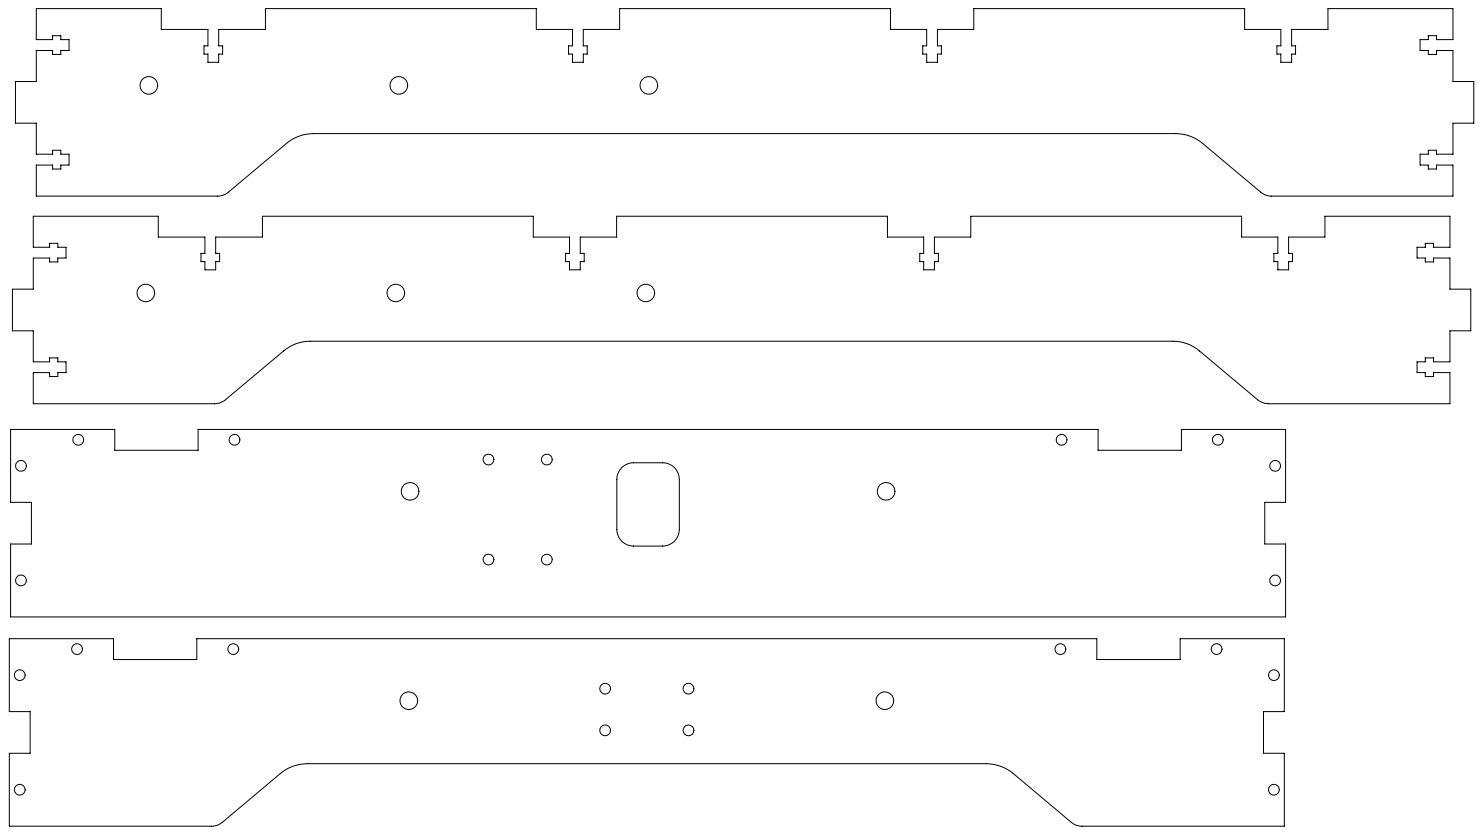
[picture p131: page 1]
