a-drizzle/Printer1/documentation/rasberryPi B+.pdf

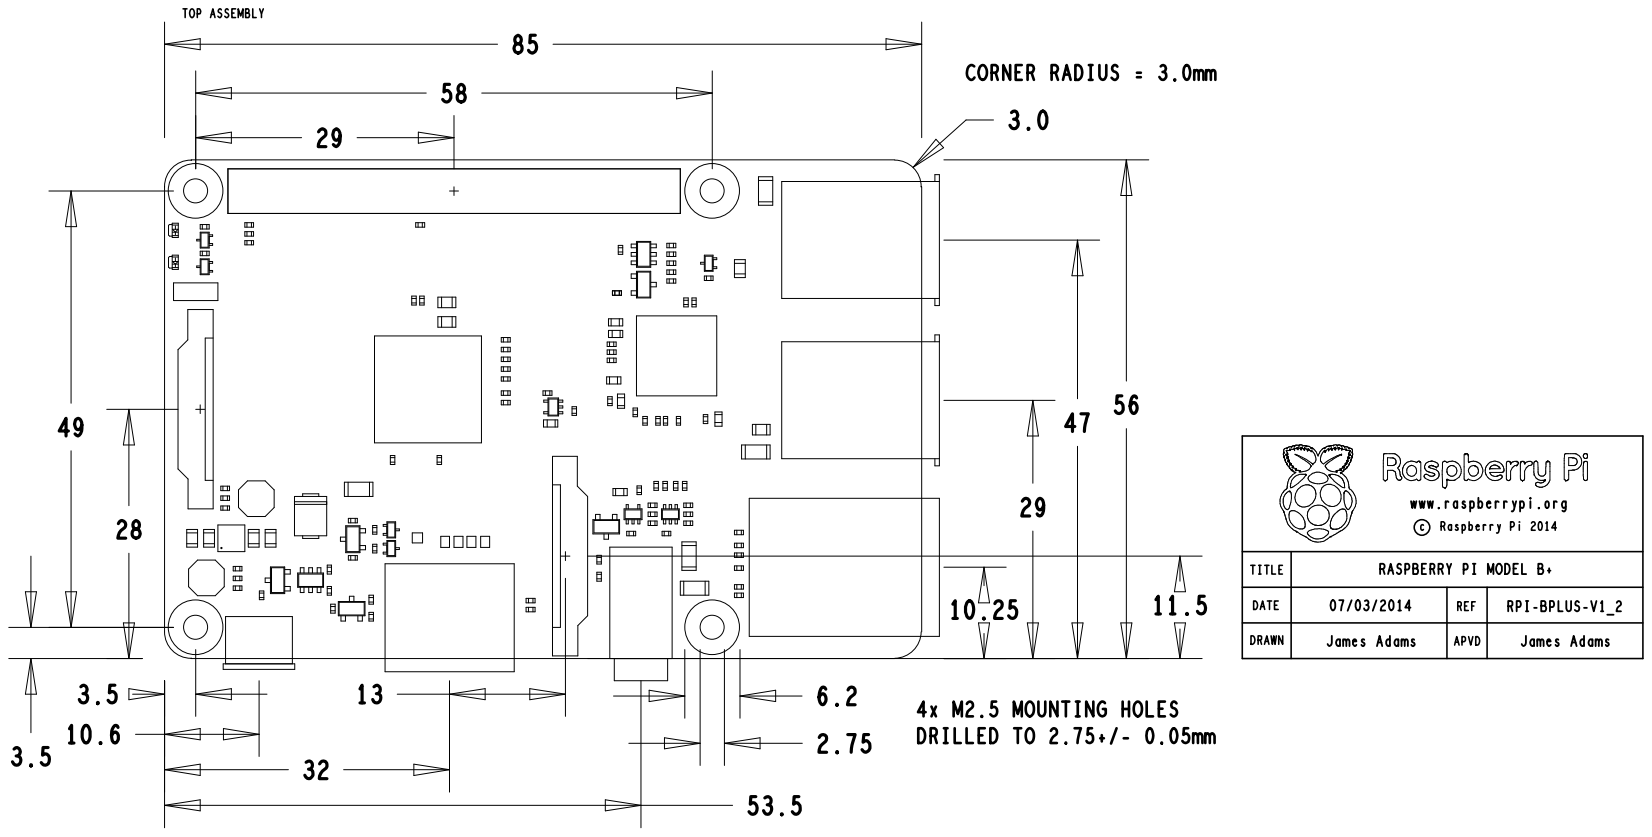
[picture p132: page 1]
