a-drizzle/Printer1/(commit log)

2016-05-06 SolidWorks, Laser Cutting, Pictures & Renders
    SolidWorks files, drawings (pdfs), laser cutting files (pdf and ai),
    initial BOM, pictures, old renders
    [BOM_initial.xlsx, F-001.SLDPRT, F-002.SLDPRT, F-003.SLDPRT, F-004.SLDPRT, F-005.SLDPRT, F-006.SLDPRT, F-007.SLDPRT]
2016-05-12 X-Axis assembly drawings! Frame RevB. Firmware.
    Lots of CAD. Drawings of x-axis assembly. Frame revision. Stable
    firmware. More pictures.
    [BOM_initial.xlsx, BOM_rB.xlsx, E-001.SLDPRT, E-003.SLDPRT, E-004.SLDPRT, F-001.SLDPRT, F-002.SLDPRT, F-003.SLDPRT]
2016-05-18 v1.0
    Everything you need to build Printer1.
    [BOM_final.xlsx, BOM_rB.xlsx, E-002.SLDPRT, E-003.SLDPRT, E-004.SLDPRT, F-002.SLDPRT, F-100.SLDASM, F-100.SLDDRW]
