a-drizzle/Printer1/media/pictures/building/20160513_101009.jpg

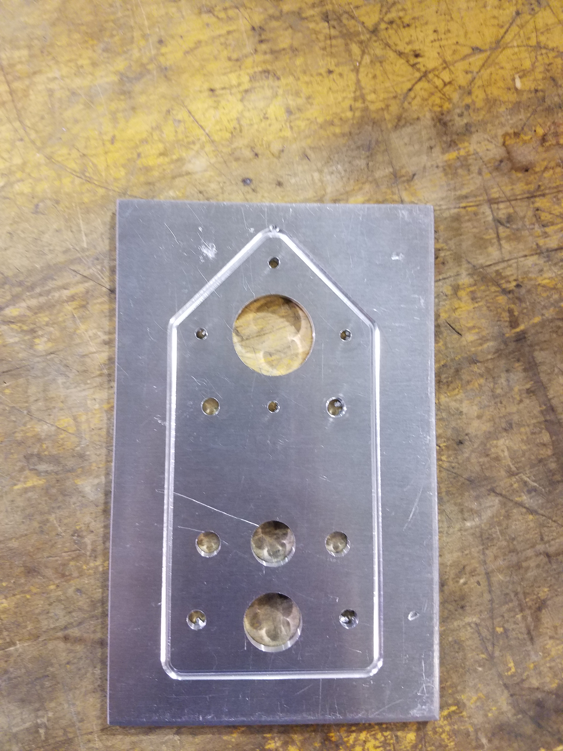
media/pictures/building/20160513_101009.jpg
